ezfarm-farmcloud/cflora/hardware/ver.1/Circuit_PCB/CECS_Base_Board/PDF/CECS_base_PL.pdf

Item | Quantity | Reference | Part | Package
1 | 1 | BT1 | CR1220 | CR1220
2 3 4 5 6 7 | 3 2 4 4 1 28 | C3,C15,C16 C32,C41 C7,C26,C27,C37 C11,C34,C36,C42 C6 C1,C2,C4,C5,C8,C9,C10,C12,C13,C14,C17,C18,C19, C20,C21,C22,C23,C24,C25,C28,C29,C30,C31,C33,C35,C 38,C39,C40 | 18pF 100pF 330pF 470pF 1000pF 100nF | SMD2012
8 9 10 11 12 13 14 15 16 17 | 4 5 4 2 8 4 1 4 4 7 | D15,D18,D19,D22 D1,D2,D3,D4,D13 D16,D17,D21,D23 EC4,EC5 EC2,EC3,EC7,EC9,EC10,EC11,EC13,EC14 EC1,EC6,EC8,EC12 J8 L2,L4,L6,L8 L1,L3,L5,L7 Q1,Q2,Q3,Q4,Q5,Q6,Q7 | SS24 1N4148 ESD5B5.0ST1-D 10uF/16V 100uF/16V 220uF/35V FFC-0.5MM-40P 1uH 100uH MMBT2222LT1G | DO-214AA SOD-80 SOD-523 EC-D55 EC-F60 EC-J10 FFC-0.5MM-40P YCDM6045T VLP8040T SOT-23
18 19 20 21 22 23 24 25 26 27 28 | 3 21 1 12 6 10 1 1 17 1 1 | R47,R53,R78 R4,R6,R11,R12,R27,R34,R42,R43,R46,R48,R51,R52,R54, R55,R56,R57,R62,R63,R69,R72,R80 R32 R21,R22,R23,R24,R25,R26,R29,R40,R74,R75,R76,R81 R9,R10,R17,R18,R73,R79 R1,R2,R7,R8,R13,R14,R19,R20,R35,R70 R36 R37 R3,R5,R28,R30,R41,R44,R45,R49,R50,R58,R59,R60,R61, R64,R65,R66,R67 R38 R39 | 0R 120R 560R 1K3 2K2 4K7 6K8 8K2 10K 15K 33K | SMD2012
29 30 | 3 4 | R15,R16,R31 R33,R68,R71,R77 | 24R 0R1 | SMD3216 SMD6432
31 | 5 | SW1,SW2,SW3,SW4,SW6 | SW PB | ITS-1105-4.3-SMD
32 | 2 | U1,U5 | 74LVC14 | SO14
33 | 1 | U2 | PCF8563 | SO8
34 | 1 | U3 | MAX3485CSA | SO8
35 | 4 | U4,U9,U10,U11 | MC33063A | SO8
36 | 1 | U6 | STM32F103VET6 | TQFP100
37 | 1 | U7 | SN65HVD230/1D | SO8
38 | 1 | U8 | MAX3232CSE | SO16
39 | 1 | Y2 | Xtal-16MHz | XTAL3225-SMD
1 | 1 | CAN1 | RJ45-4C4P
2 | 10 | D5,D6,D7,D8,D9,D10,D11,D12D14,D20 | 3pi LED
3 | 1 | F1 | F-520
4 | 4 | J1,J2,J3,J4 | BR-350MLH-3P
5 | 2 | J5,J6 | HEADER 8X2 2.0mm
6 | 2 | J7,J10 | HEADER 24X2
7 | 2 | J9,J17 | 5267-4P
8 | 1 | J11 | Header 6X2 2.54mm
9 | 3 | J12,J20,J21 | 5267-2P
10 | 1 | J13 | HEADER 17X2
11 | 2 | J14,J15 | Header 2P 2.54mm
12 | 1 | J16 | 5267-3P
13 | 1 | J18 | IDC 5X2 2mm
14 | 1 | J19 | YW500-02V
15 | 2 | LS1,LS2 | DS1E-S-DC5V
16 | 1 | LS3 | Buzzer
17 | 1 | SW5 | SW DIP-4
18 | 5 | T1,T2,T3,T4,T5 | TP
19 | 1 | Y1 | 32768Hz
20 | 2 | RV1,RV2 | VARISTOR 18V
21 | 2 | ISO1,ISO2 | TLP281

dip.

*** CECS_Base_Board_PL

*** 이하 수삽부품
