ezfarm-farmcloud/cflora/hardware/ver.1/Circuit_PCB/CECS_MODULE_AtoD/pdf/cecs_module_atod_PL.pdf

Item | Quantity | Reference | Part | Package
1 2 3 4 5 6 7 8 | 2 1 2 2 1 8 49 8 | C41,C43 C58 C59,C65 C64,C73 C72 C4,C8,C12,C19,C24,C29,C34,C39 C2,C3,C5,C7,C9,C10,C13,C14,C15,C17,C18,C20,C22, C1,C6,C11,C16,C21,C26,C31,C36 | 18pF 100pF 330pF 470pF 1500pF 68nF 100nF 150nF | SMD2012
9 10 11 12 13 14 15 16 17 18 | 2 9 16 8 1 2 13 8 16 32 | R75,R89 R82,R84,R85,R86,R87,R92,R94,R100,R106 R3,R7,R12,R15,R21,R25,R30,R34,R39,R43,R48,R52,R57, R95,R96,R97,R98,R102,R104,R108,R110 R107 R101,R109 R73,R74,R76,R77,R78,R79,R80,R81,R83,R88,R90,R91, R4,R16,R24,R33,R42,R51,R59,R69 R2,R9,R11,R18,R20,R27,R29,R36,R38,R45,R47,R54,R56, R1,R5,R6,R8,R10,R13,R14,R17,R19,R22,R23,R26,R28, | 0R 120R 249R 1K3 2K2 5K6 10K 13K 49K9 100K | SMD2012
19 20 | 2 1 | R99,R105 R103 | 0R1 0R2 | SMD6432
21 22 23 24 25 26 27 28 29 30 31 32 33 34 35 36 37 38 39 | 2 3 6 3 3 3 3 19 8 1 1 1 3 1 8 1 1 1 1 | EC1,EC2 EC3,EC4,EC5 EC7,EC8,EC10,EC12,EC13,EC14 EC6,EC9,EC11 L1,L4,L6 L2,L3,L5 D28,D33,D34 D1,D2,D4,D5,D7,D8,D10,D11,D13,D14,D16,D18,D19, D3,D6,D9,D12,D15,D17,D20,D23 U15 U10 U12 U14,U16,U17 U13 U1,U2,U3,U4,U5,U6,U7,U8 U11 U9 Y1 SW2 | 1uF/35V 10uF/16V 100uF/16V 220uF/35V 100uH 1uH SS24 ESD5B5.0ST1-D BTA54SL LM1117S-5.0 SN65HVD230/1D ADR381 MC33063A 74LVC14 TL074C MAX3232CSE STM32F103VET6 Xtal-16MHz SW PUSHBUTTON | EC-D55 EC-D55 EC-F60 EC-J10 VLP8040T YCDM6045T DO-214AA SOD-523 SOT-23 SOT-223 SO8 SO8 SO8 SO14 SO14 SO16 TQFP100 XTAL3225-SMD ITS-1105-4.3-SMD
1 | 2 | CAN1,CAN2 | RJ45-4P4C
2 | 5 | D29,D30,D31,D32,D35 | 3pi LED
3 | 1 | F1 | F-520
4 | 8 | J1,J3,J5,J7,J9,J11,J13,J15 | BR-350MLH-3P
5 | 8 | J2,J4,J6,J8,J10,J12,J14,J16 | Header 3X2 2.54mm
6 | 1 | J17 | JMP
7 | 1 | J18 | IDC 5X2 2mm
8 | 2 | J19,J20 | 5267-3P
9 | 1 | J21 | HEADER 8X2 2.0mm
10 | 1 | J22 | YW500-02V
11 | 1 | J23 | HEADER 8X2 2mm
12 | 1 | RV1 | VARISTOR 18V
13 | 1 | SW1 | SW DIP-4
14 | 21 | T1,T2,T3,T4,T5,T6,T7,T8,T9,T10,T11,T12,T13,T14,T15, | TP

dip.

*** 이하 수삽부품

*** CECS_AtoD_Module_PL
