ezfarm-farmcloud/cflora/hardware/ver.1/Circuit_PCB/CECS_atod_base_PL.xlsx

Sheet: CECS_AtoD_Module
*** CECS_AtoD_Module_PL
Item | Quantity | Reference | Part | Package
1 | 2 | C41,C43 | 18pF | SMD2012
2 | 1 | C58 | 100pF
3 | 2 | C59,C65 | 330pF
4 | 2 | C64,C73 | 470pF
5 | 1 | C72 … 부품없음, 실장하지 않음 | 1500pF
6 | 8 | C4,C8,C12,C19,C24,C29,C34,C39 | 68nF
7 | 49 | C2,C3,C5,C7,C9,C10,C13,C14,C15,C17,C18,C20,C22, C23,C25,C27,C28,C30,C32,C33,C35,C37,C38,C40,C42,C44,C45,C46,C47,C48,C49,C50,C51,C52,C53,C54,C55,C56,C57,C60,C61,C62,C63,C66,C67,C68,C69,C70,C71 | 100nF
8 | 8 | C1,C6,C11,C16,C21,C26,C31,C36 | 150nF
9 | 2 | R75,R89 | 0R | SMD2012
10 | 9 | R82,R84,R85,R86,R87,R92,R94,R100,R106 | 120R
11 | 16 | R3,R7,R12,R15,R21,R25,R30,R34,R39,R43,R48,R52,R57,R60,R66,R70 | 249R
12 | 8 | R95,R96,R97,R98,R102,R104,R108,R110 | 1K3
13 | 1 | R107 | 2K2
14 | 2 | R101,R109 | 5K6 >> 6K2로 변경
15 | 13 | R73,R74,R76,R77,R78,R79,R80,R81,R83,R88,R90,R91, R93 | 10K
16 | 8 | R4,R16,R24,R33,R42,R51,R59,R69 | 13K
17 | 16 | R2,R9,R11,R18,R20,R27,R29,R36,R38,R45,R47,R54,R56,R63,R65,R72 | 49K9
18 | 32 | R1,R5,R6,R8,R10,R13,R14,R17,R19,R22,R23,R26,R28, R31,R32,R35,R37,R40,R41,R44,R46,R49,R50,R53,R55, R58,R61,R62,R64,R67,R68,R71 | 100K
19 | 2 | R99,R105 | 0R1 | SMD6432
20 | 1 | R103 | 0R2
21 | 2 | EC1,EC2 | 1uF/50V로 변경 | EC-D55
22 | 3 | EC3,EC4,EC5 | 10uF/16V | EC-D55
23 | 6 | EC7,EC8,EC10,EC12,EC13,EC14 | 100uF/16V | EC-F60
24 | 3 | EC6,EC9,EC11 | 220uF/35V | EC-J10
25 | 3 | L1,L4,L6 | 100uH | VLP8040T
26 | 3 | L2,L3,L5 | 1uH | YCDM6045T
27 | 3 | D28,D33,D34 | SS24 | DO-214AA
28 | 19 | D1,D2,D4,D5,D7,D8,D10,D11,D13,D14,D16,D18,D19, D21,D22,D24,D25,D26,D27 | ESD5B5.0ST1-D | SOD-523
29 | 8 | D3,D6,D9,D12,D15,D17,D20,D23 | BTA54SL | SOT-23
30 | 1 | U15 | LM1117S-5.0 | SOT-223
31 | 1 | U10 | SN65HVD230/1D | SO8
32 | 1 | U12 | ADR381 | SO8
33 | 3 | U14,U16,U17 … 부품 부족 3세트실장 | MC33063A | SO8
34 | 1 | U13 | 74LVC14 | SO14
35 | 8 | U1,U2,U3,U4,U5,U6,U7,U8 TL074, TL084 부품 2종 준비 5세트씩 실장한다, | TL074C | SO14
36 | 1 | U11 | MAX3232CSE | SO16
37 | 1 | U9 | STM32F103VET6 | TQFP100
38 | 1 | Y1 | Xtal-16MHz | XTAL3225-SMD
39 | 1 | SW2 | SW PUSHBUTTON | ITS-1105-4.3-SMD
*** 이하 수삽부품
1 | 2 | CAN1,CAN2 | RJ45-4P4C | dip.
2 | 5 | D29,D30,D31,D32,D35 | 3pi LED
3 | 1 | F1 | F-520
4 | 8 | J1,J3,J5,J7,J9,J11,J13,J15 | BR-350MLH-3P
5 | 8 | J2,J4,J6,J8,J10,J12,J14,J16 | Header 3X2 2.54mm
6 | 1 | J17 | JMP
7 | 1 | J18 | IDC 5X2 2mm
8 | 2 | J19,J20 | 5267-3P
9 | 1 | J21 | HEADER 8X2 2.0mm
10 | 1 | J22 | YW500-02V
11 | 1 | J23 | HEADER 8X2 2mm
12 | 1 | RV1 | VARISTOR 18V
13 | 1 | SW1 | SW DIP-4
14 | 21 | T1,T2,T3,T4,T5,T6,T7,T8,T9,T10,T11,T12,T13,T14,T15, T16,T17,T18,T19,T20,T21 | TP

Sheet: CECS_Base_Board
*** CECS_Base_Board_PL
Item | Quantity | Reference | Part | Package
1 | 1 | BT1 | CR1220 | CR1220
2 | 3 | C3,C15,C16 | 18pF | SMD2012
3 | 2 | C32,C41 | 100pF
4 | 4 | C7,C26,C27,C37 | 330pF
5 | 4 | C11,C34,C36,C42 | 470pF
6 | 1 | C6 | 1000pF
7 | 28 | C1,C2,C4,C5,C8,C9,C10,C12,C13,C14,C17,C18,C19, C20,C21,C22,C23,C24,C25,C28,C29,C30,C31,C33,C35,C38,C39,C40 | 100nF
8 | 4 | D15,D18,D19,D22 | SS24 | DO-214AA
9 | 5 | D1,D2,D3,D4,D13 | 1N4148 | SOD-80
10 | 4 | D16,D17,D21,D23 | ESD5B5.0ST1-D | SOD-523
11 | 2 | EC4,EC5 | 10uF/16V | EC-D55
12 | 8 | EC2,EC3,EC7,EC9,EC10,EC11,EC13,EC14 | 100uF/16V | EC-F60
13 | 4 | EC1,EC6,EC8,EC12 | 220uF/35V | EC-J10
14 | 1 | J8 | FFC-0.5MM-40P | FFC-0.5MM-40P
15 | 4 | L2,L4,L6,L8 | 1uH | YCDM6045T
16 | 4 | L1,L3,L5,L7 | 100uH | VLP8040T
17 | 7 | Q1,Q2,Q3,Q4,Q5,Q6,Q7 | MMBT2222LT1G | SOT-23
18 | 3 | R47,R53,R78 | 0R | SMD2012
19 | 21 | R4,R6,R11,R12,R27,R34,R42,R43,R46,R48,R51,R52,R54,R55,R56,R57,R62,R63,R69,R72,R80 | 120R
20 | 1 | R32 | 560R
21 | 12 | R21,R22,R23,R24,R25,R26,R29,R40,R74,R75,R76,R81 | 1K3
22 | 6 | R9,R10,R17,R18,R73,R79 | 2K2
23 | 10 | R1,R2,R7,R8,R13,R14,R19,R20,R35,R70 | 4K7
24 | 1 | R36 | 6K8
25 | 1 | R37 | 8K2
26 | 17 | R3,R5,R28,R30,R41,R44,R45,R49,R50,R58,R59,R60,R61,R64,R65,R66,R67 | 10K
27 | 1 | R38 | 15K
28 | 1 | R39 | 33K
29 | 3 | R15,R16,R31 | 24R | SMD3216
30 | 4 | R33,R68,R71,R77 | 0R1 | SMD6432
31 | 5 | SW1,SW2,SW3,SW4,SW6 | SW PB | ITS-1105-4.3-SMD
32 | 2 | U1,U5 | 74LVC14 | SO14
33 | 1 | U2 … 부품부족, 5세트 실장 | PCF8563 | SO8
34 | 1 | U3 … 부품 없음, 실장하지 않음 | MAX3485CSA | SO8
35 | 4 | U4,U9,U10,U11 … … 부품 부족 1세트실장 | MC33063A | SO8
36 | 1 | U6 | STM32F103VET6 | TQFP100
37 | 1 | U7 | SN65HVD230/1D | SO8
38 | 1 | U8 | MAX3232CSE | SO16
39 | 1 | Y2 | Xtal-16MHz | XTAL3225-SMD
*** 이하 수삽부품
1 | 1 | CAN1 | RJ45-4C4P | dip.
2 | 10 | D5,D6,D7,D8,D9,D10,D11,D12D14,D20 | 3pi LED
3 | 1 | F1 | F-520
4 | 4 | J1,J2,J3,J4 | BR-350MLH-3P
5 | 2 | J5,J6 | HEADER 8X2 2.0mm
6 | 2 | J7,J10 | HEADER 24X2
7 | 2 | J9,J17 | 5267-4P
8 | 1 | J11 | Header 6X2 2.54mm
9 | 3 | J12,J20,J21 | 5267-2P
10 | 1 | J13 | HEADER 17X2
11 | 2 | J14,J15 | Header 2P 2.54mm
12 | 1 | J16 | 5267-3P
13 | 1 | J18 | IDC 5X2 2mm
14 | 1 | J19 | YW500-02V
15 | 2 | LS1,LS2 | DS1E-S-DC5V
16 | 1 | LS3 | Buzzer
17 | 1 | SW5 | SW DIP-4
18 | 5 | T1,T2,T3,T4,T5 | TP
19 | 1 | Y1 | 32768Hz
20 | 2 | RV1,RV2 | VARISTOR 18V
21 | 2 | ISO1,ISO2 | TLP281
