ezfarm-farmcloud/cflora/hardware/ver.2/Circuit_PCB/CFLORA_BASE2016/pdf/base.pdf

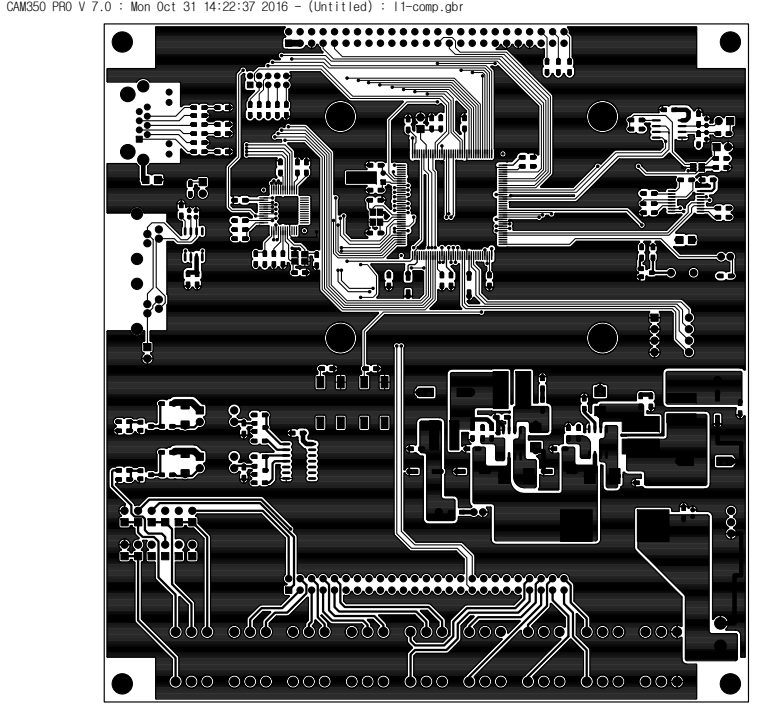
[picture p28: page 1]

CAM350 PRO V 7.0 : Mon Oct 31 14:22:37 2016 - (Untitled) : l1-comp.gbr

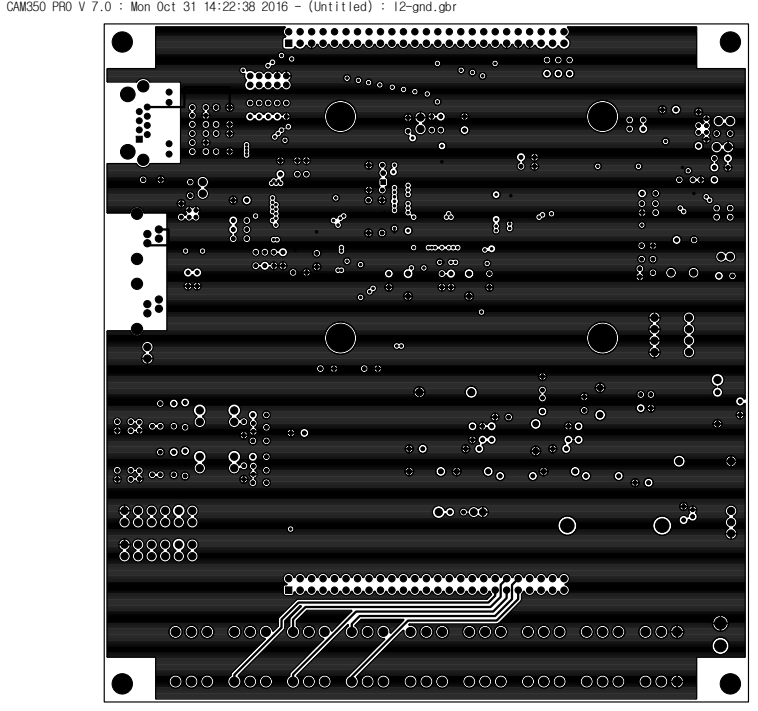
[picture p29: page 2]

CAM350 PRO V 7.0 : Mon Oct 31 14:22:38 2016 - (Untitled) : l2-gnd.gbr

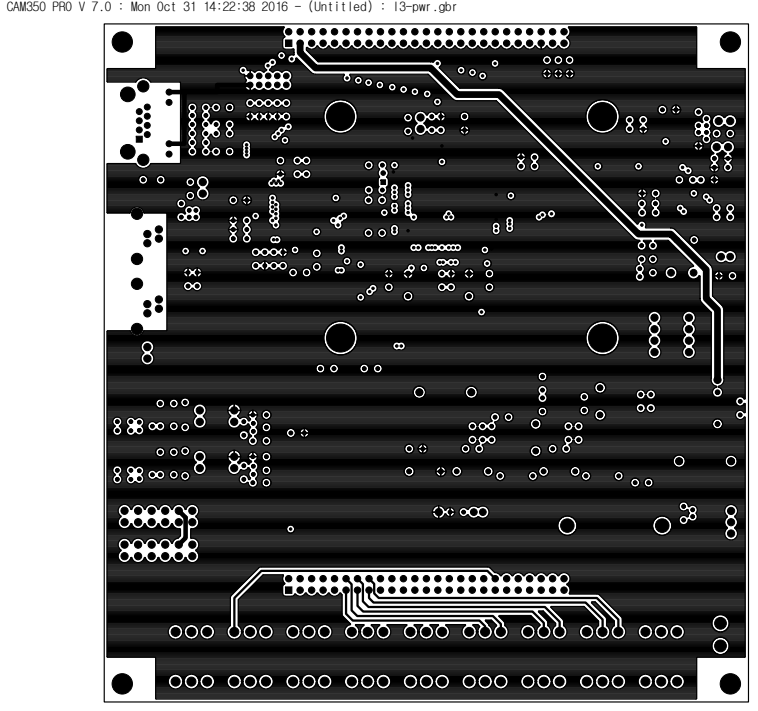
[picture p30: page 3]

CAM350 PRO V 7.0 : Mon Oct 31 14:22:38 2016 - (Untitled) : l3-pwr.gbr

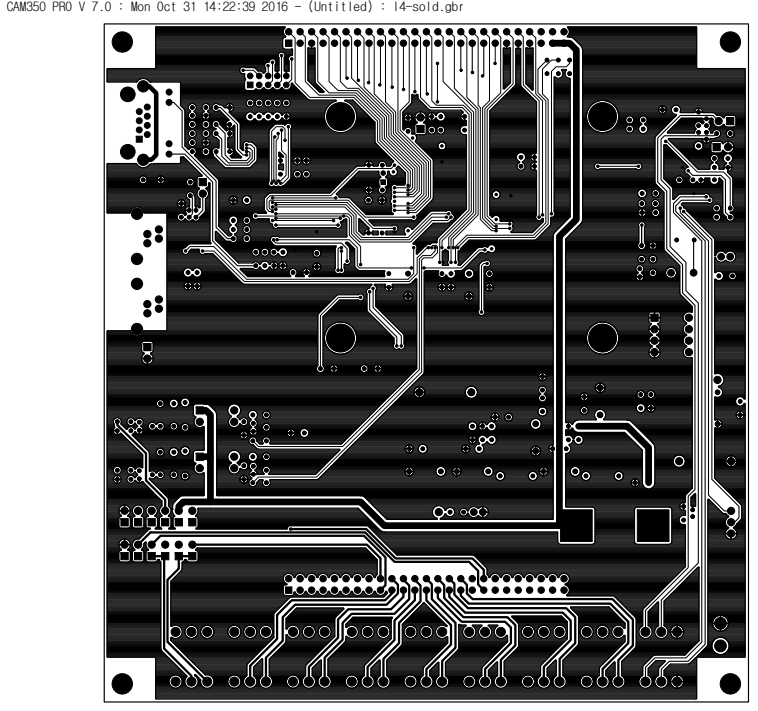
[picture p31: page 4]

CAM350 PRO V 7.0 : Mon Oct 31 14:22:39 2016 - (Untitled) : l4-sold.gbr

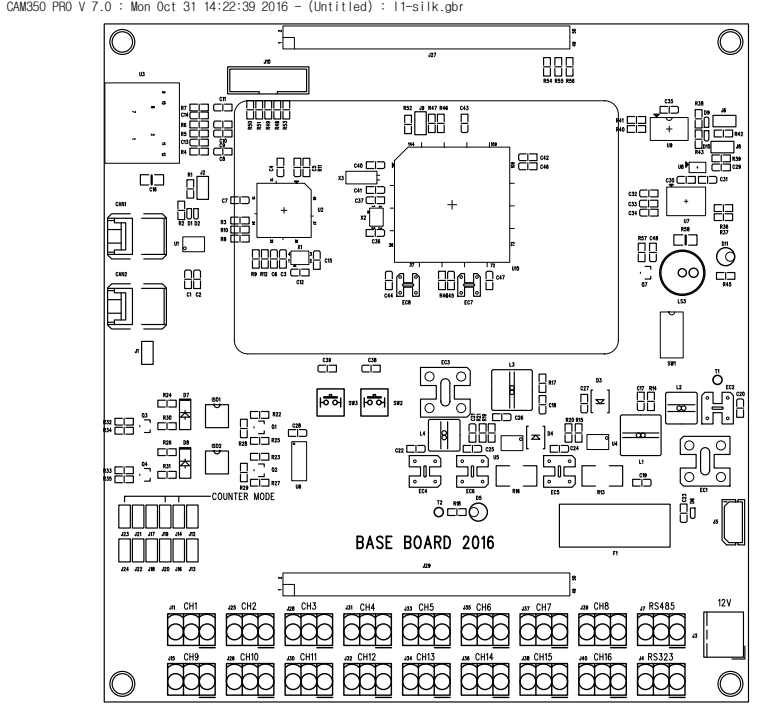
[picture p32: page 5]

CAM350 PRO V 7.0 : Mon Oct 31 14:22:39 2016 - (Untitled) : l1-silk.gbr

CAM350 PRO V 7.0 : Mon Oct 31 14:22:39 2016 - (Untitled) : l4-silk.gbr

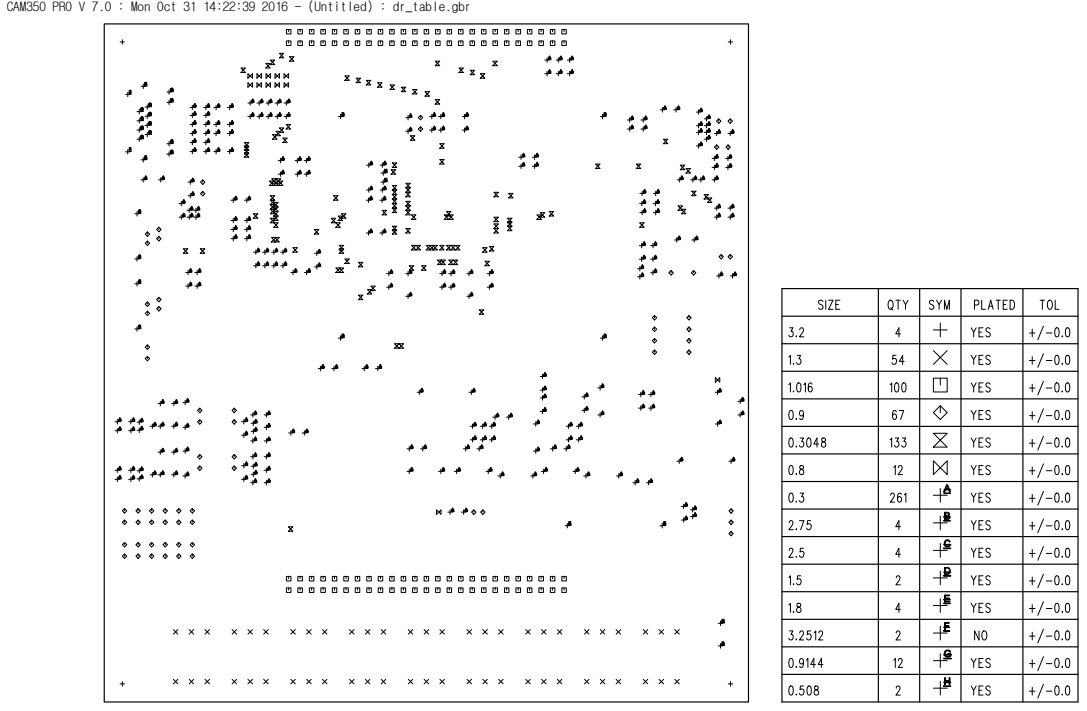
[picture p33: page 7]

CAM350 PRO V 7.0 : Mon Oct 31 14:22:39 2016 - (Untitled) : dr_table.gbr

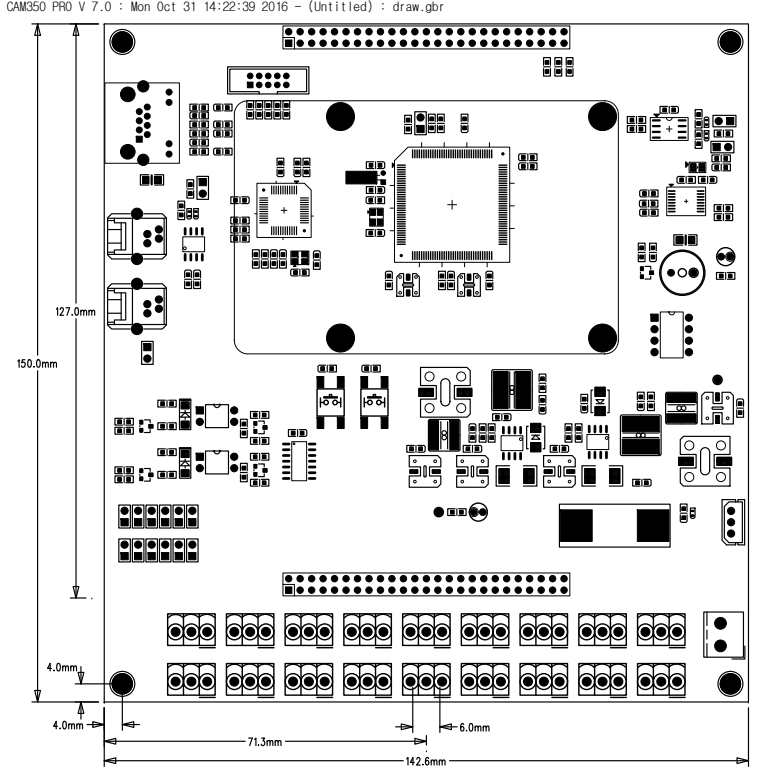
[picture p34: page 8]

CAM350 PRO V 7.0 : Mon Oct 31 14:22:39 2016 - (Untitled) : draw.gbr

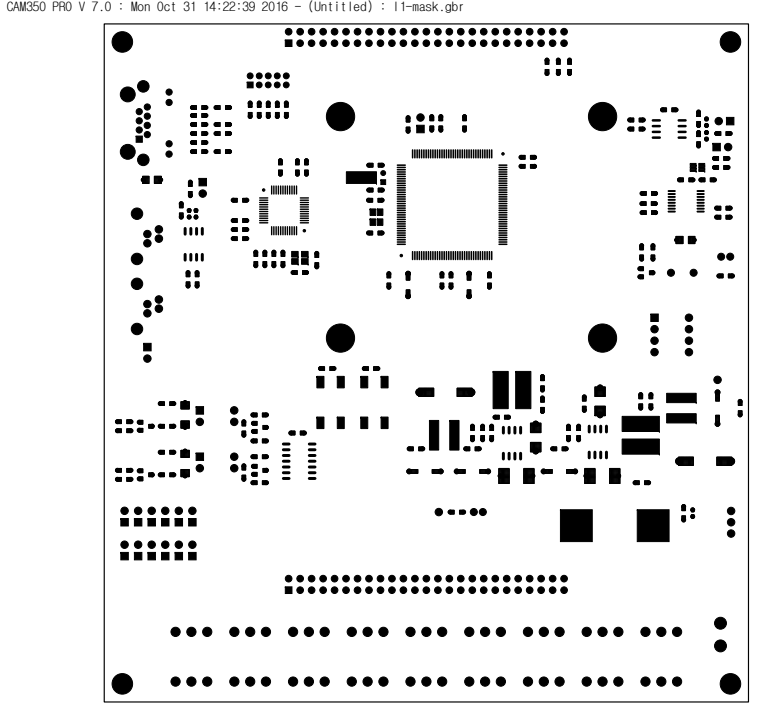
[picture p35: page 9]

CAM350 PRO V 7.0 : Mon Oct 31 14:22:39 2016 - (Untitled) : l1-mask.gbr

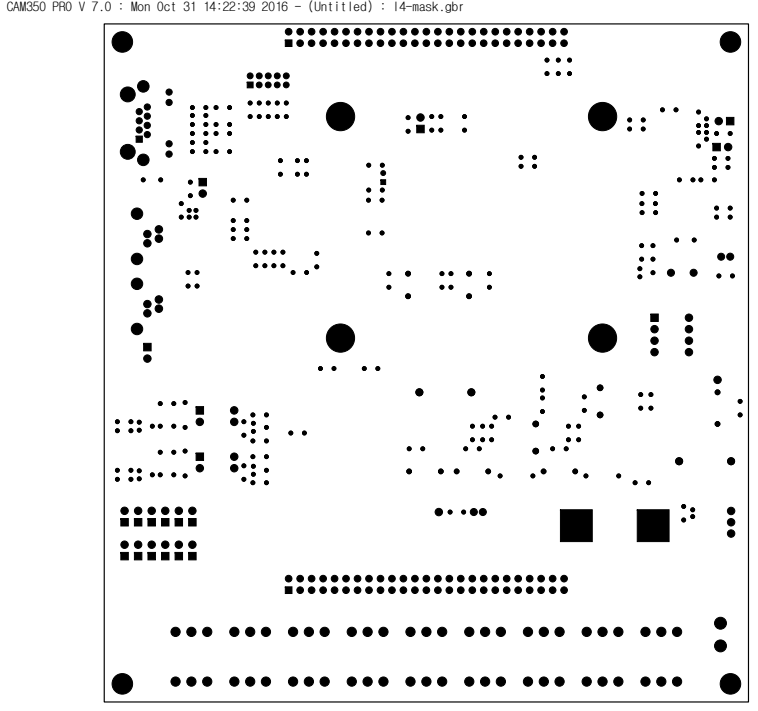
[picture p36: page 10]

CAM350 PRO V 7.0 : Mon Oct 31 14:22:39 2016 - (Untitled) : l4-mask.gbr

CAM350 PRO V 7.0 : Mon Oct 31 14:22:39 2016 - (Untitled) : l1-paste.gbr

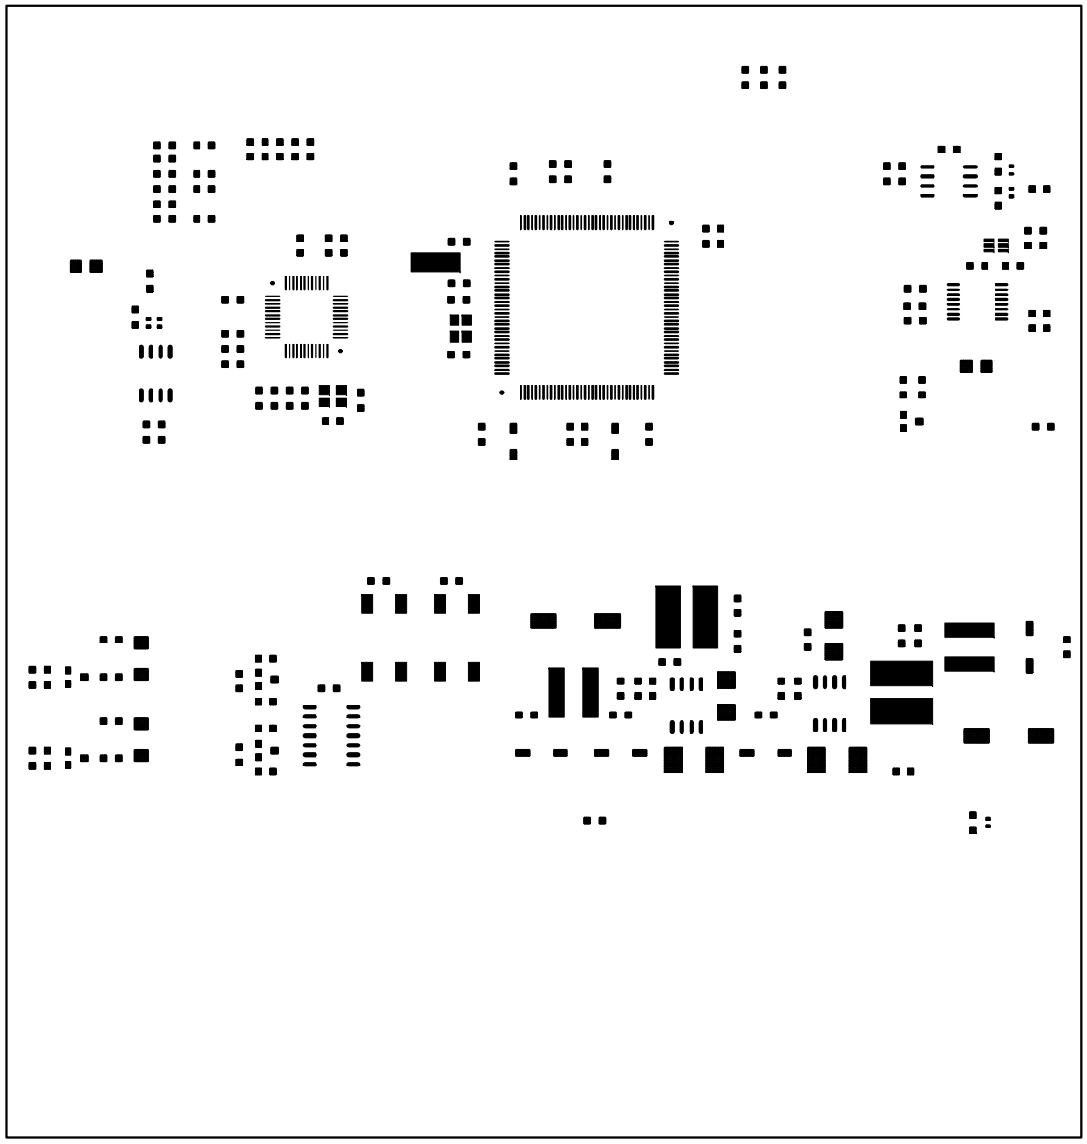
[picture p37: figure]

CAM350 PRO V 7.0 : Mon Oct 31 14:22:39 2016 - (Untitled) : l4-paste.gbr
