ezfarm-farmcloud/cflora/hardware/ver.2/Circuit_PCB/MODULE_AtoD2016/pdf/atod.pdf

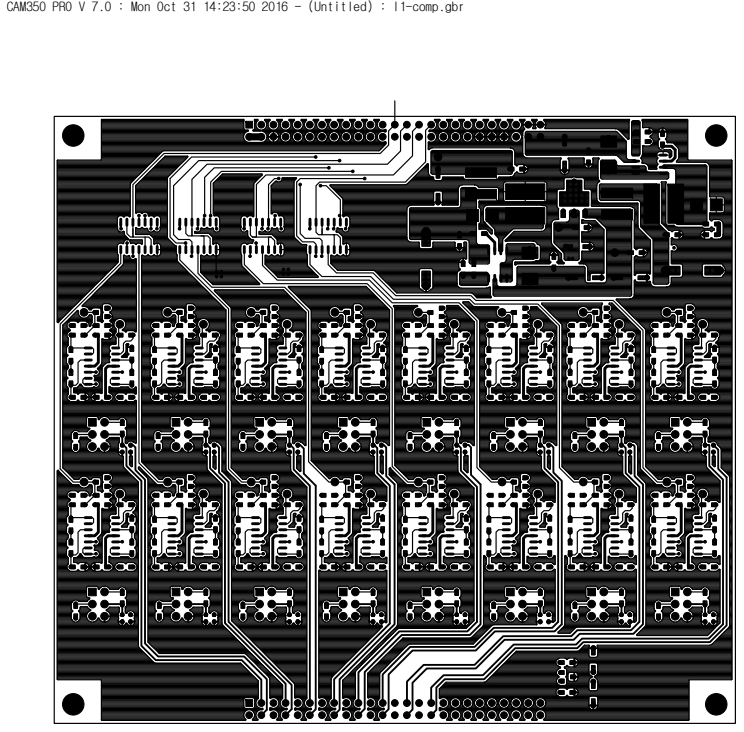
[picture p38: page 1]

CAM350 PRO V 7.0 : Mon Oct 31 14:23:50 2016 - (Untitled) : l1-comp.gbr

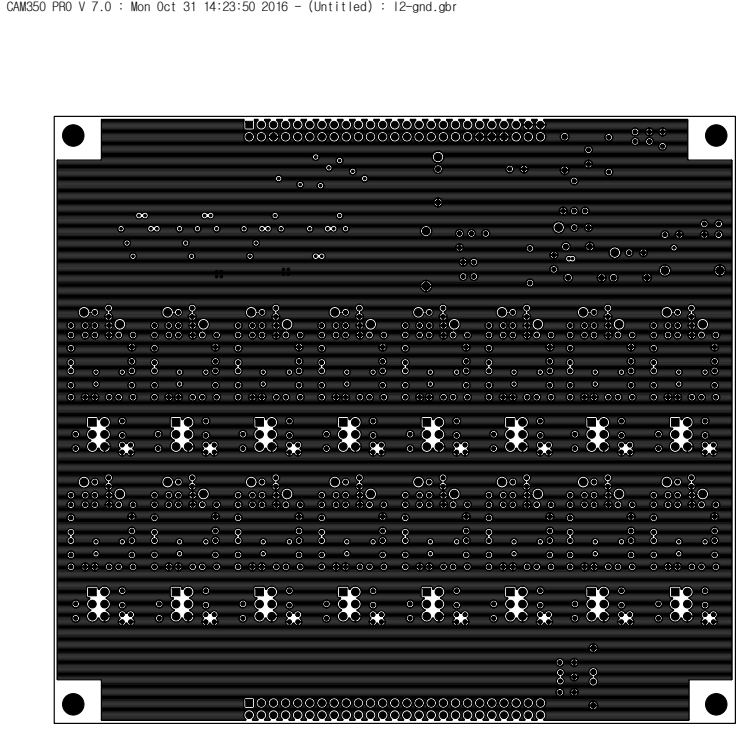
[picture p39: page 2]

CAM350 PRO V 7.0 : Mon Oct 31 14:23:50 2016 - (Untitled) : l2-gnd.gbr

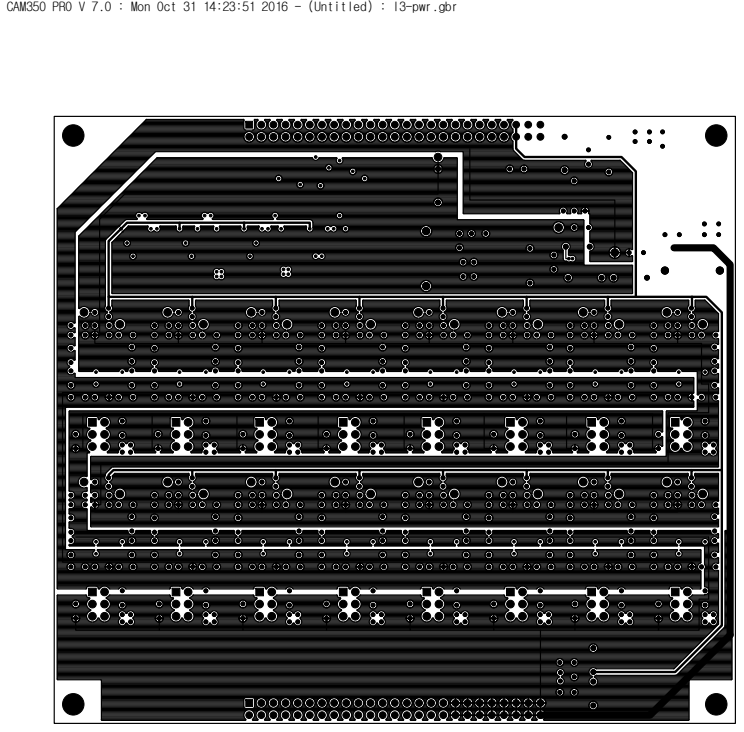
[picture p40: page 3]

CAM350 PRO V 7.0 : Mon Oct 31 14:23:51 2016 - (Untitled) : l3-pwr.gbr

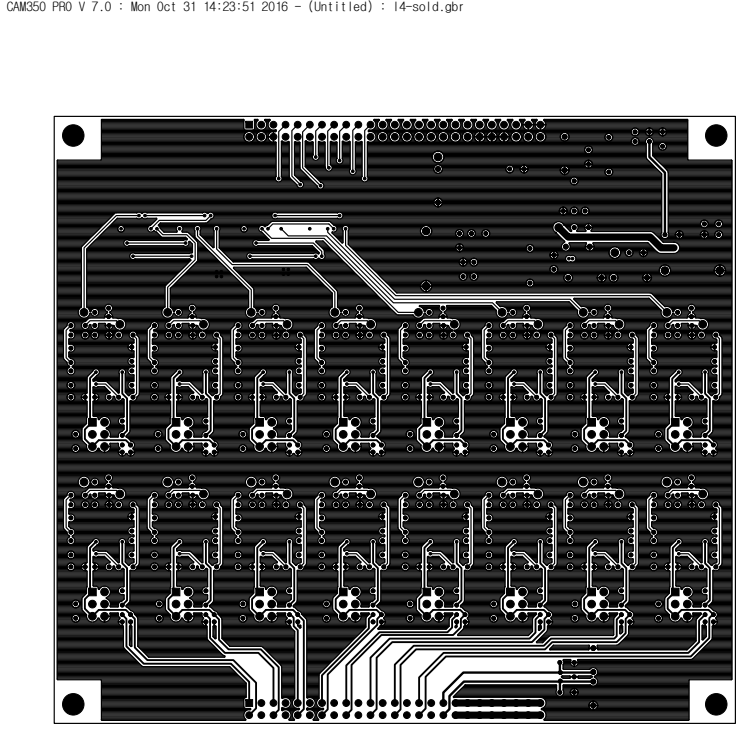
[picture p41: page 4]

CAM350 PRO V 7.0 : Mon Oct 31 14:23:51 2016 - (Untitled) : l4-sold.gbr

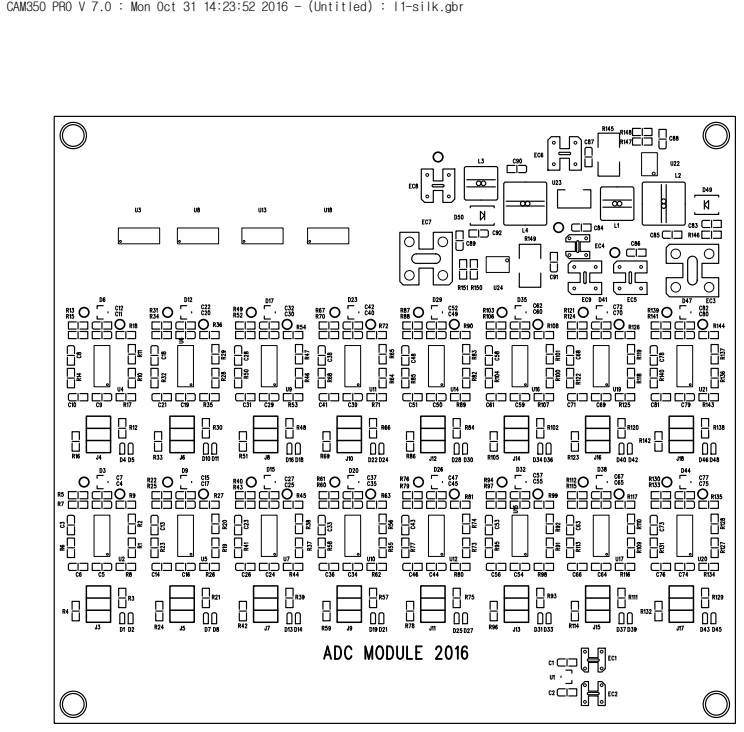
[picture p42: page 5]

CAM350 PRO V 7.0 : Mon Oct 31 14:23:52 2016 - (Untitled) : l1-silk.gbr

CAM350 PRO V 7.0 : Mon Oct 31 14:23:52 2016 - (Untitled) : l4-silk.gbr

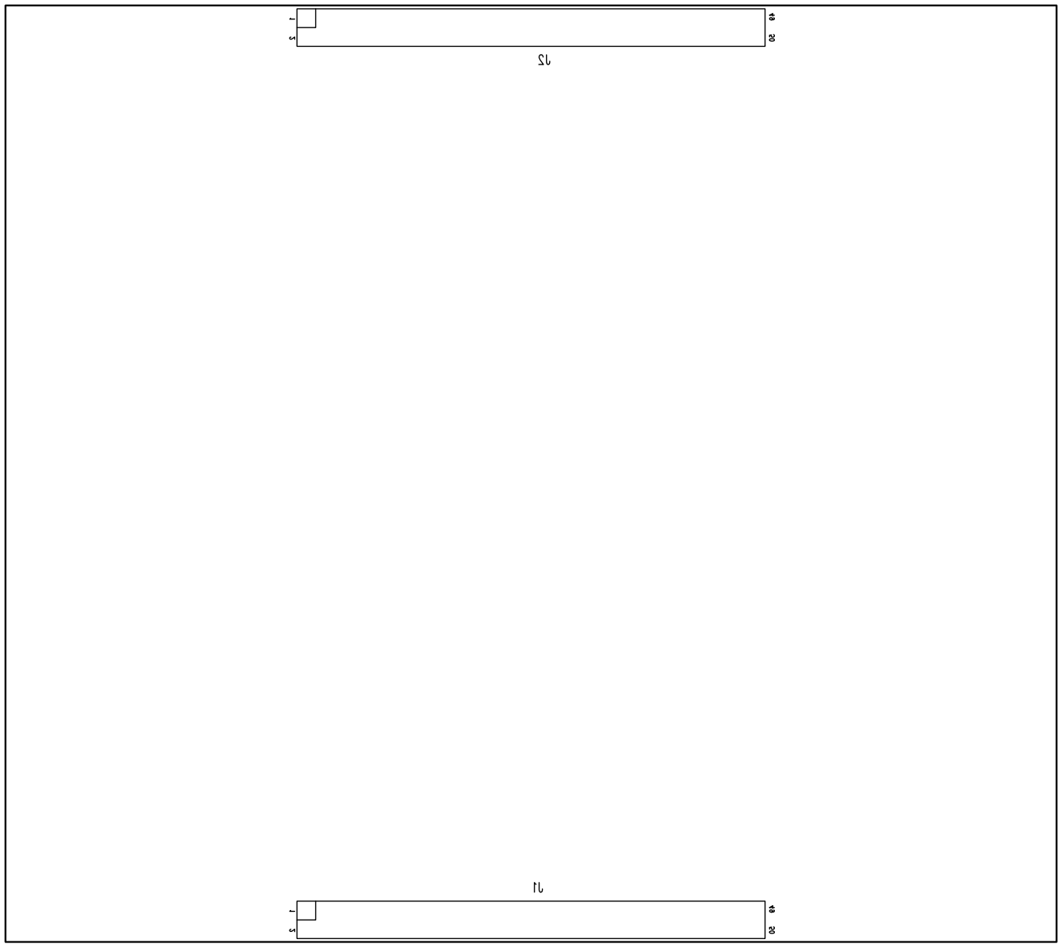
[picture p43: figure]
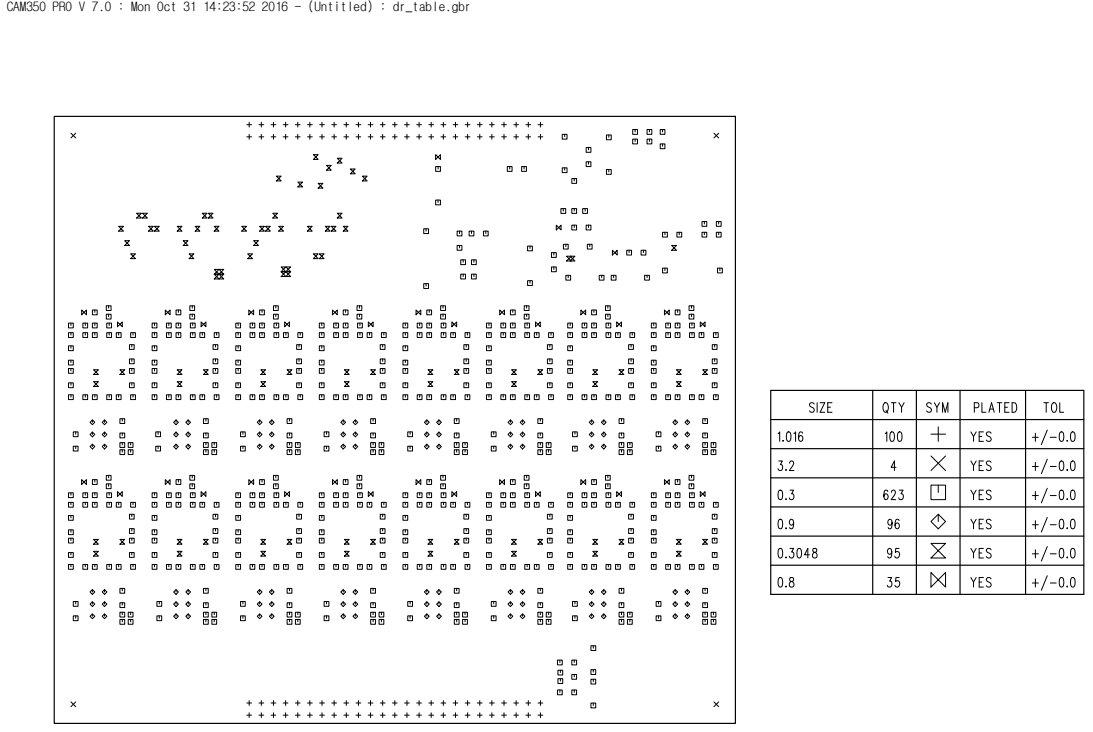
[picture p44: page 7]

CAM350 PRO V 7.0 : Mon Oct 31 14:23:52 2016 - (Untitled) : dr_table.gbr

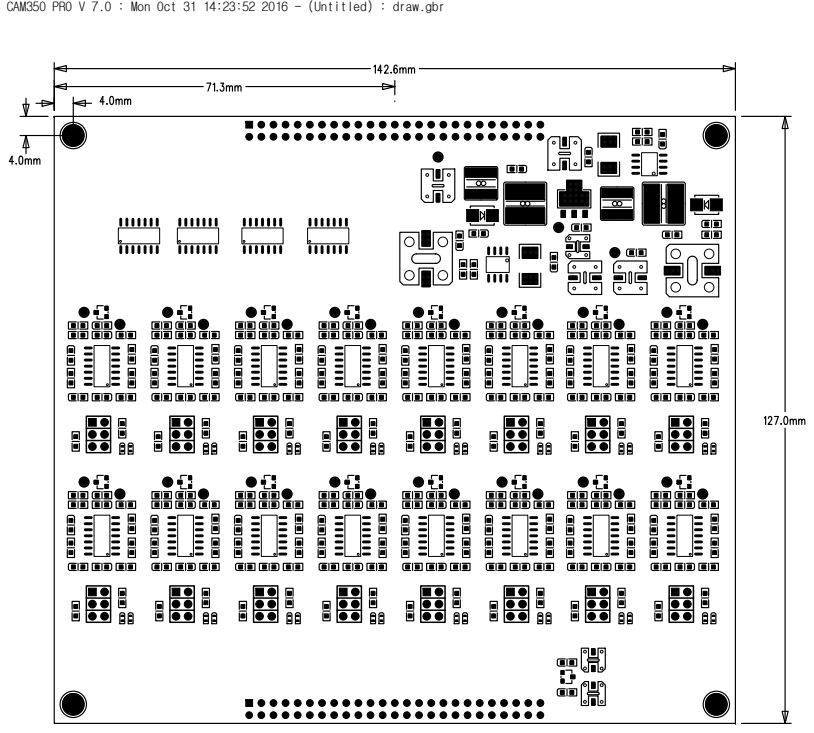
[picture p45: page 8]

CAM350 PRO V 7.0 : Mon Oct 31 14:23:52 2016 - (Untitled) : draw.gbr

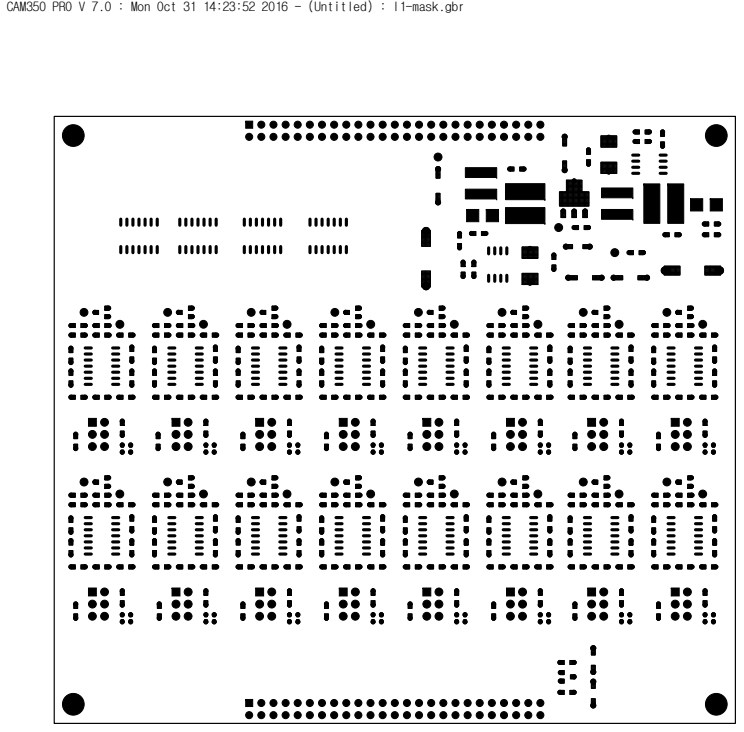
[picture p46: page 9]

CAM350 PRO V 7.0 : Mon Oct 31 14:23:52 2016 - (Untitled) : l1-mask.gbr

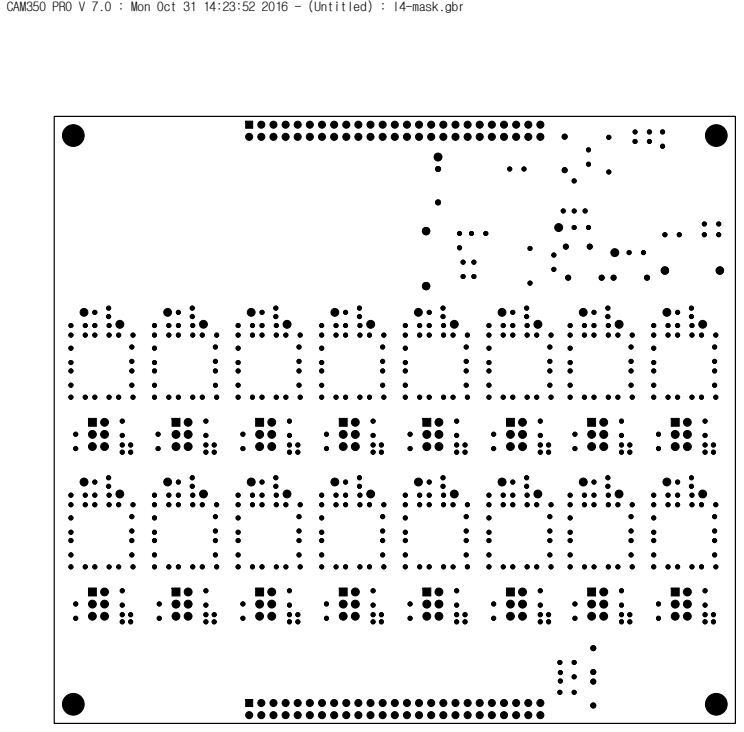
[picture p47: page 10]

CAM350 PRO V 7.0 : Mon Oct 31 14:23:52 2016 - (Untitled) : l4-mask.gbr

CAM350 PRO V 7.0 : Mon Oct 31 14:23:52 2016 - (Untitled) : l1-paste.gbr

CAM350 PRO V 7.0 : Mon Oct 31 14:23:53 2016 - (Untitled) : l4-paste.gbr
