ezfarm-farmcloud/cflora/hardware/ver.2/Circuit_PCB/MODULE_IsoInput2016/pdf/iso.pdf

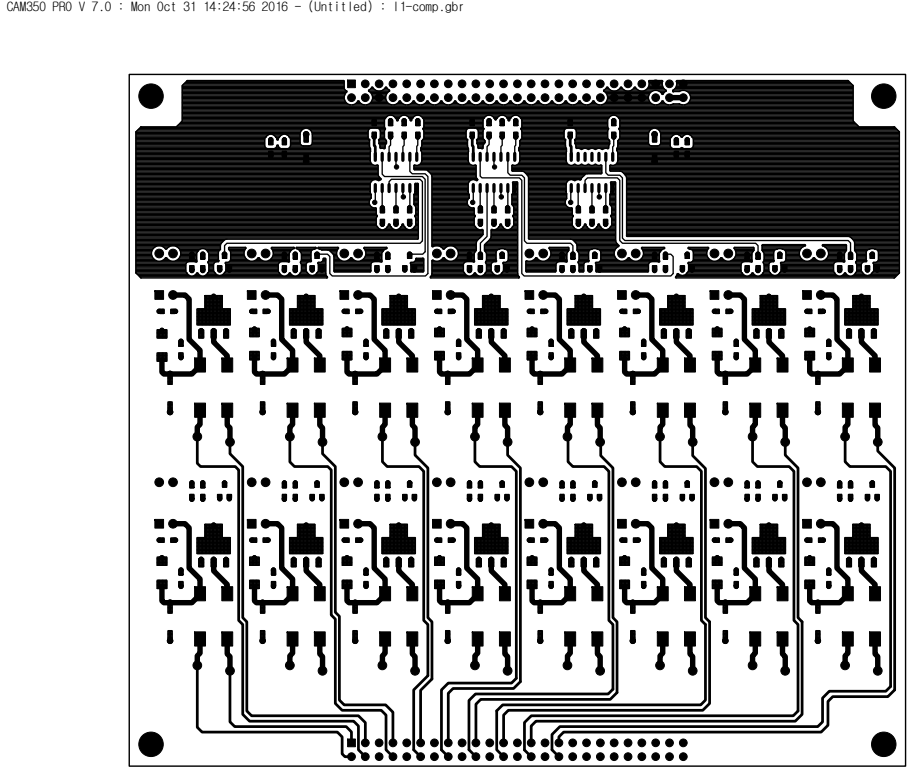
[picture p48: page 1]

CAM350 PRO V 7.0 : Mon Oct 31 14:24:56 2016 - (Untitled) : l1-comp.gbr

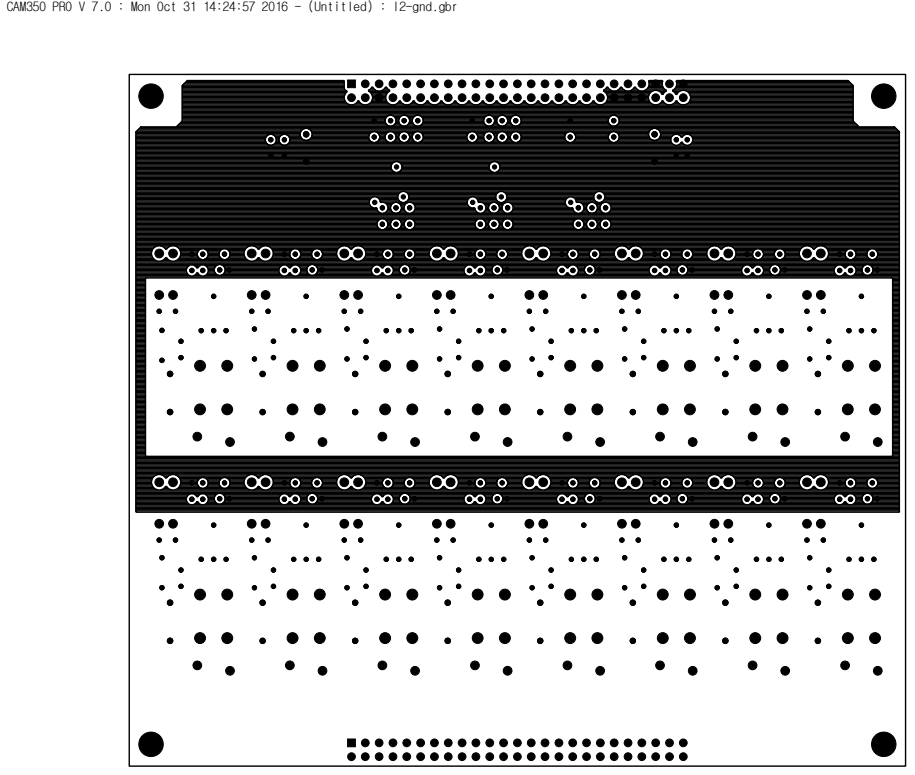
[picture p49: page 2]

CAM350 PRO V 7.0 : Mon Oct 31 14:24:57 2016 - (Untitled) : l2-gnd.gbr

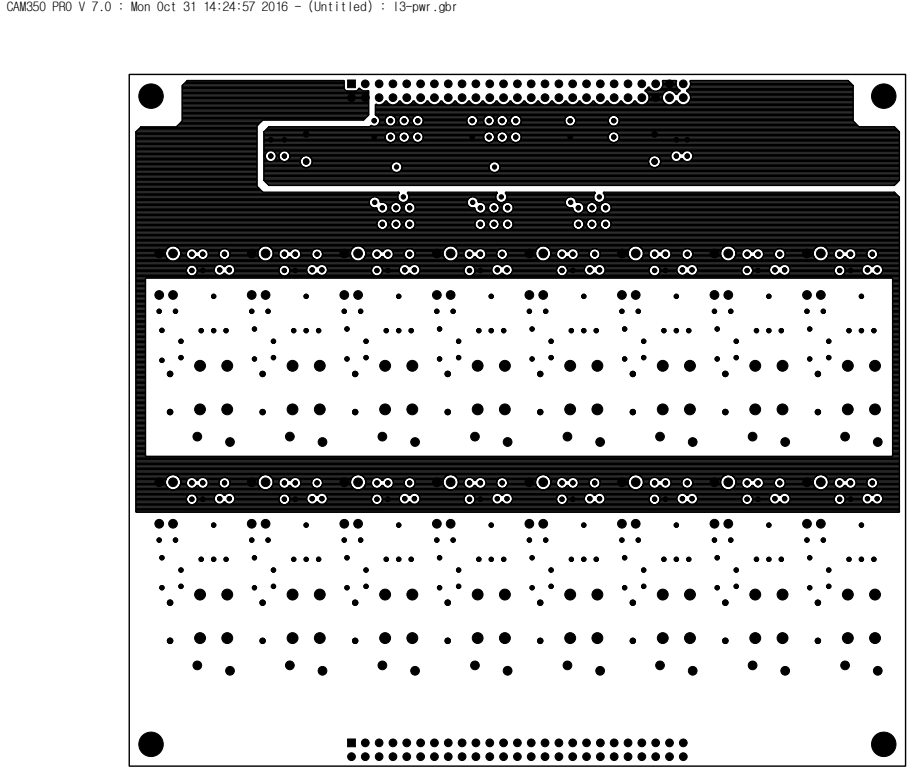
[picture p50: page 3]

CAM350 PRO V 7.0 : Mon Oct 31 14:24:57 2016 - (Untitled) : l3-pwr.gbr

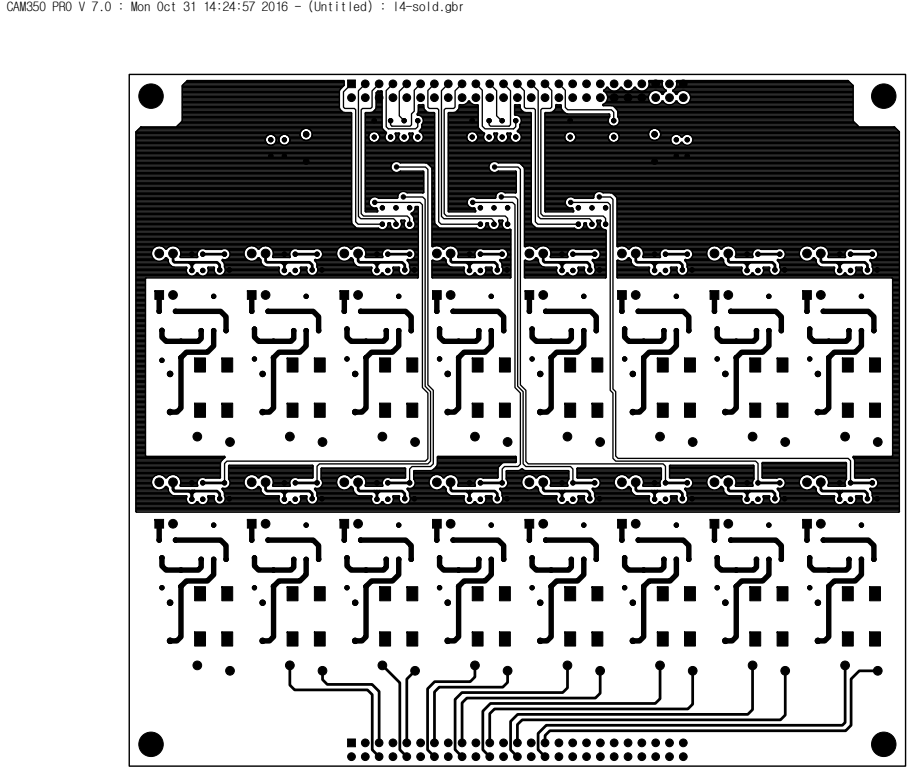
[picture p51: page 4]

CAM350 PRO V 7.0 : Mon Oct 31 14:24:57 2016 - (Untitled) : l4-sold.gbr

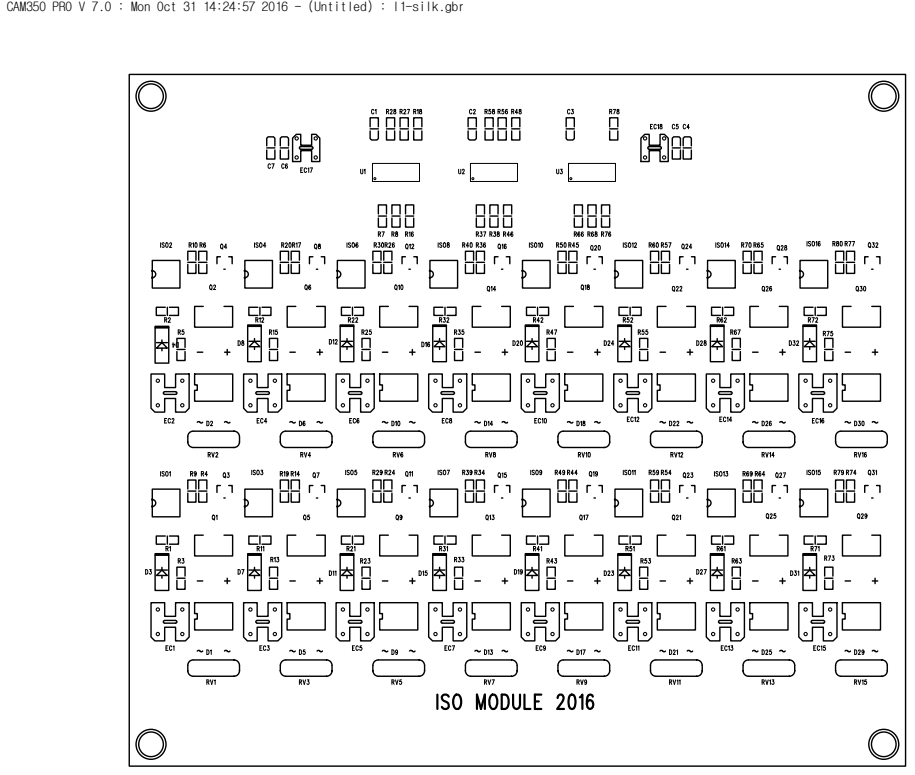
[picture p52: page 5]

CAM350 PRO V 7.0 : Mon Oct 31 14:24:57 2016 - (Untitled) : l1-silk.gbr

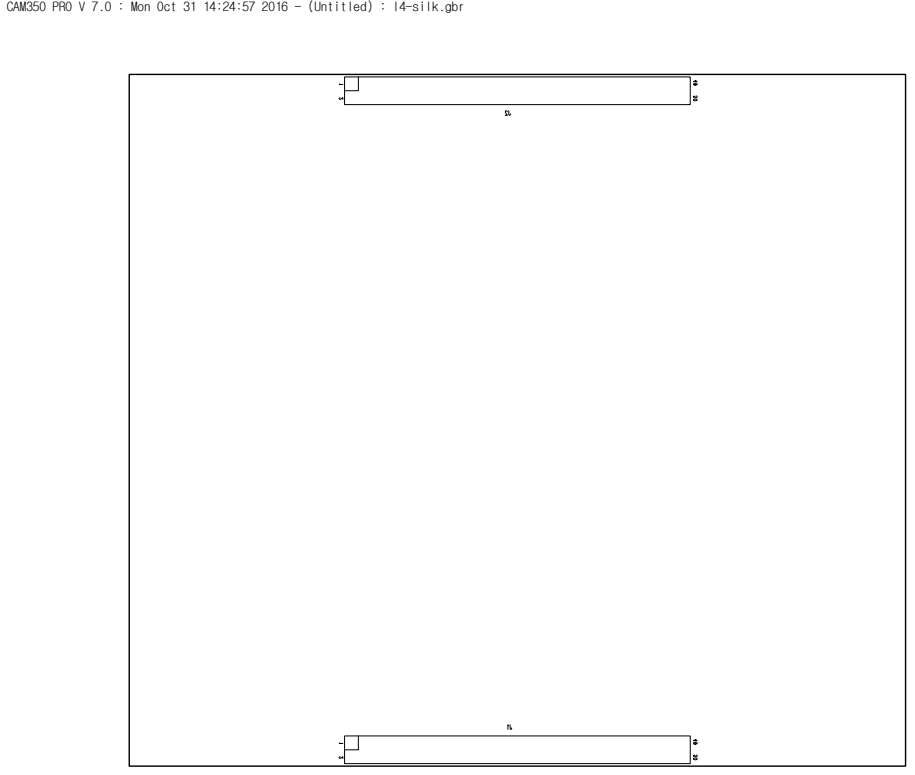
[picture p53: page 6]

CAM350 PRO V 7.0 : Mon Oct 31 14:24:57 2016 - (Untitled) : l4-silk.gbr

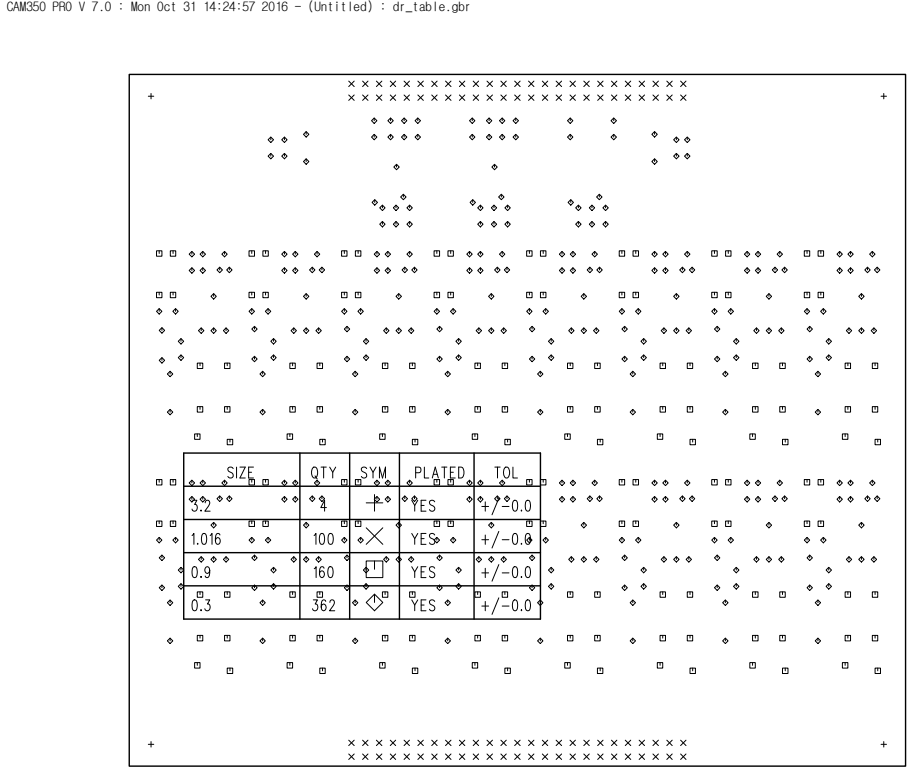
[picture p54: page 7]

CAM350 PRO V 7.0 : Mon Oct 31 14:24:57 2016 - (Untitled) : dr_table.gbr

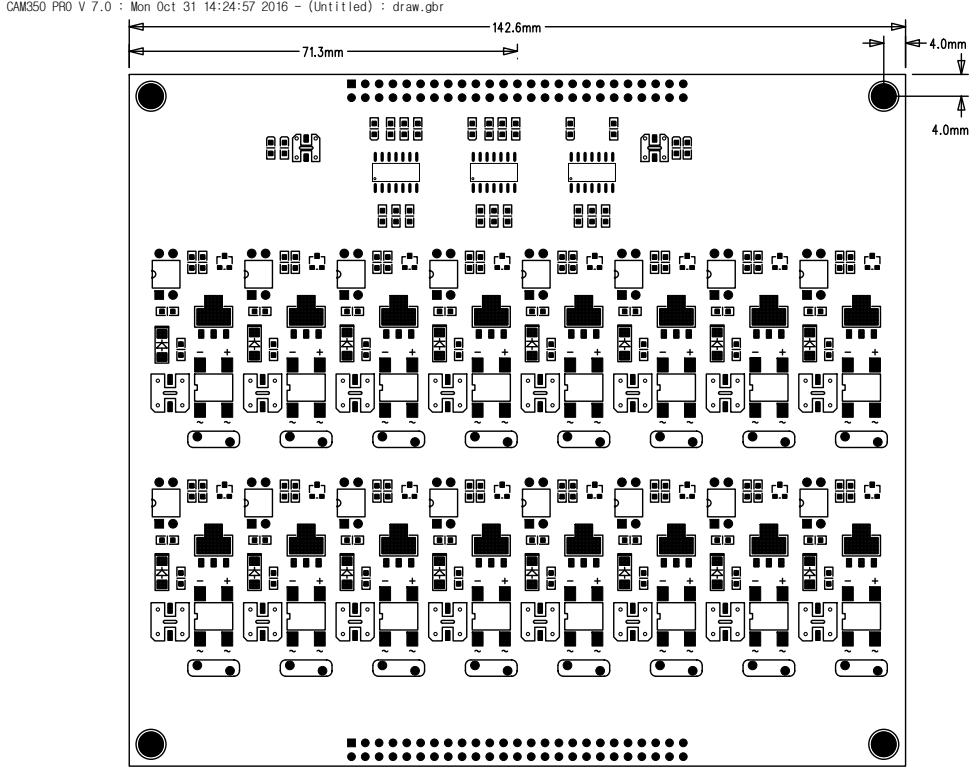
[picture p55: page 8]

CAM350 PRO V 7.0 : Mon Oct 31 14:24:57 2016 - (Untitled) : draw.gbr

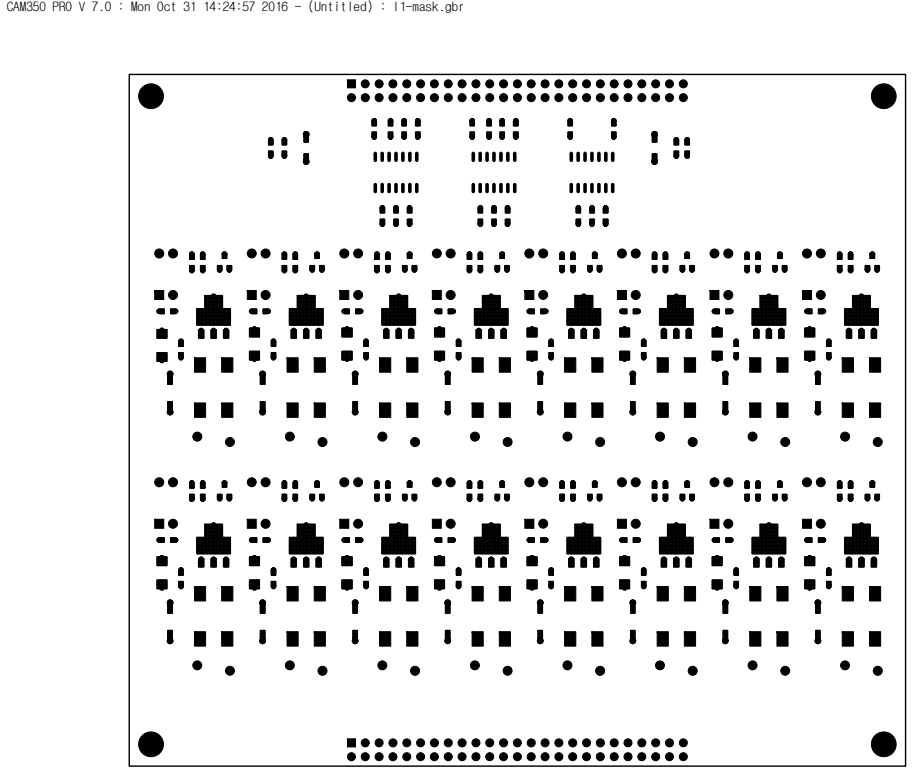
[picture p56: page 9]

CAM350 PRO V 7.0 : Mon Oct 31 14:24:57 2016 - (Untitled) : l1-mask.gbr

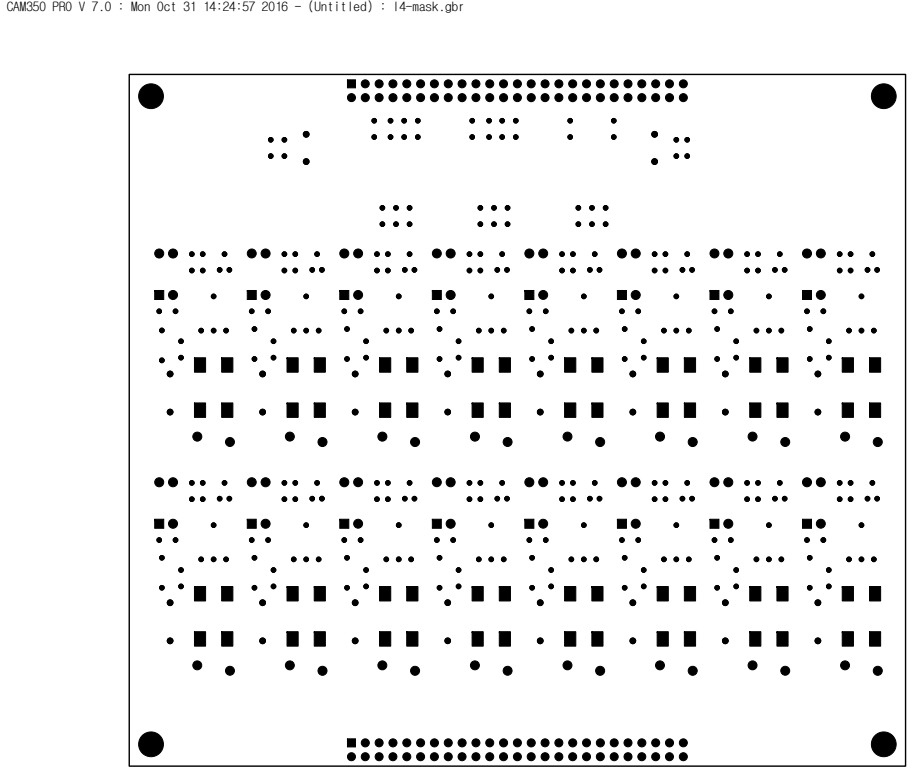
[picture p57: page 10]

CAM350 PRO V 7.0 : Mon Oct 31 14:24:57 2016 - (Untitled) : l4-mask.gbr

CAM350 PRO V 7.0 : Mon Oct 31 14:24:57 2016 - (Untitled) : l1-paste.gbr

CAM350 PRO V 7.0 : Mon Oct 31 14:24:57 2016 - (Untitled) : l4-paste.gbr
