ezfarm-farmcloud/cflora/hardware/ver.2/Circuit_PCB/MODULE_Relay2016/pdf/relay.pdf

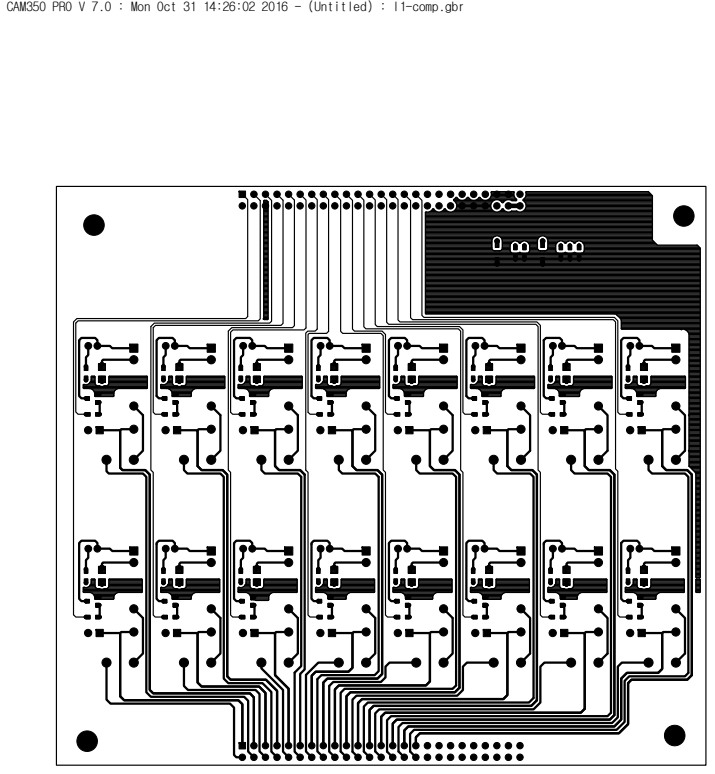
[picture p58: page 1]

CAM350 PRO V 7.0 : Mon Oct 31 14:26:02 2016 - (Untitled) : l1-comp.gbr

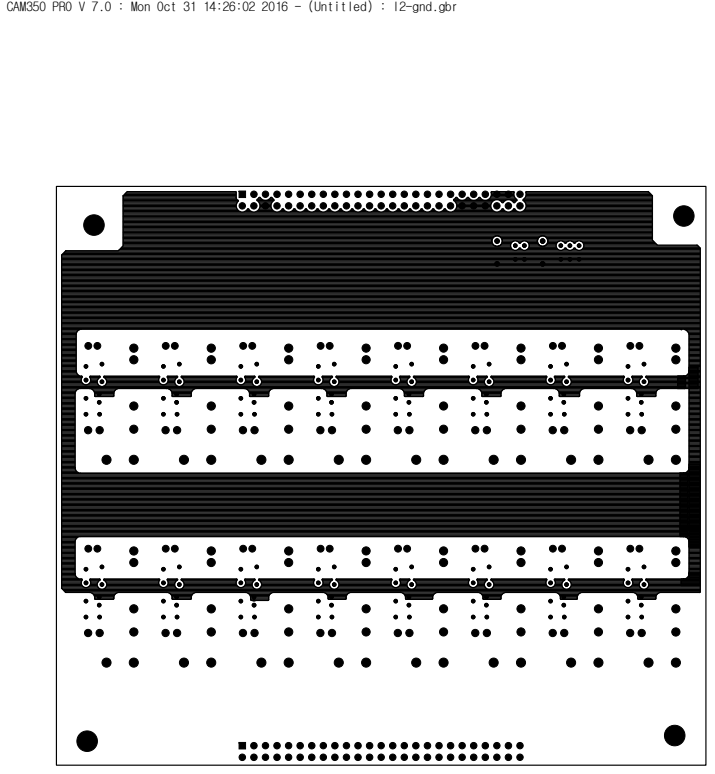
[picture p59: page 2]

CAM350 PRO V 7.0 : Mon Oct 31 14:26:02 2016 - (Untitled) : l2-gnd.gbr

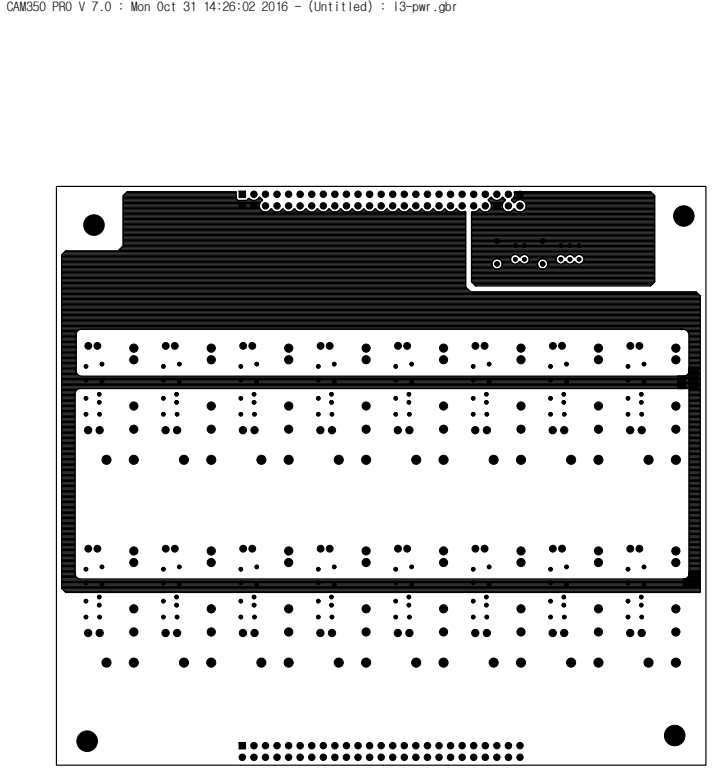
[picture p60: page 3]

CAM350 PRO V 7.0 : Mon Oct 31 14:26:02 2016 - (Untitled) : l3-pwr.gbr

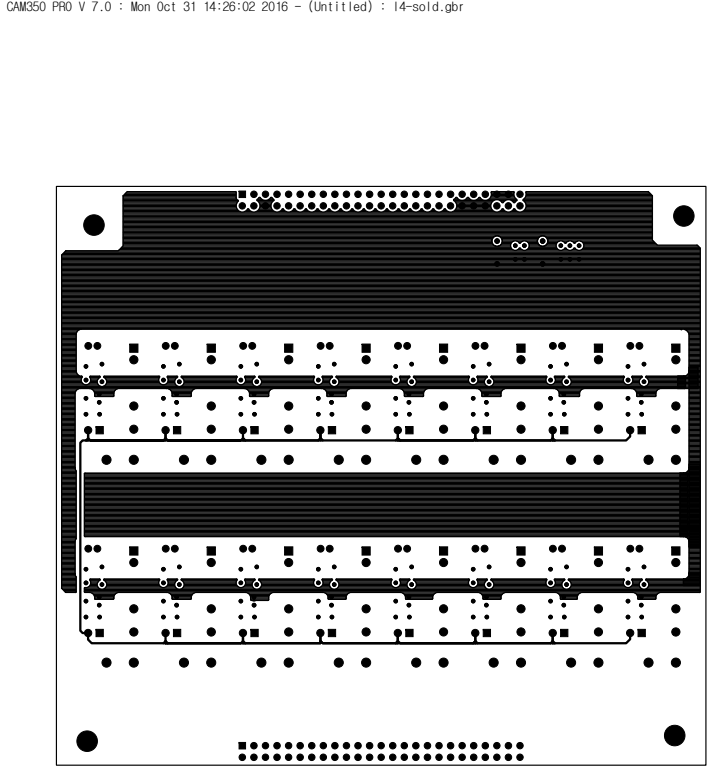
[picture p61: page 4]

CAM350 PRO V 7.0 : Mon Oct 31 14:26:02 2016 - (Untitled) : l4-sold.gbr

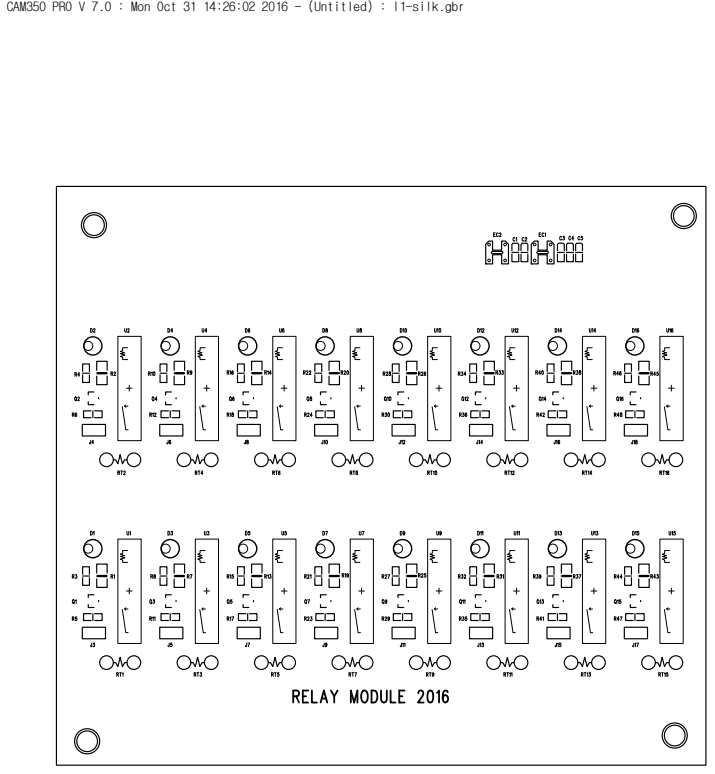
[picture p62: page 5]

CAM350 PRO V 7.0 : Mon Oct 31 14:26:02 2016 - (Untitled) : l1-silk.gbr

CAM350 PRO V 7.0 : Mon Oct 31 14:26:03 2016 - (Untitled) : l4-silk.gbr

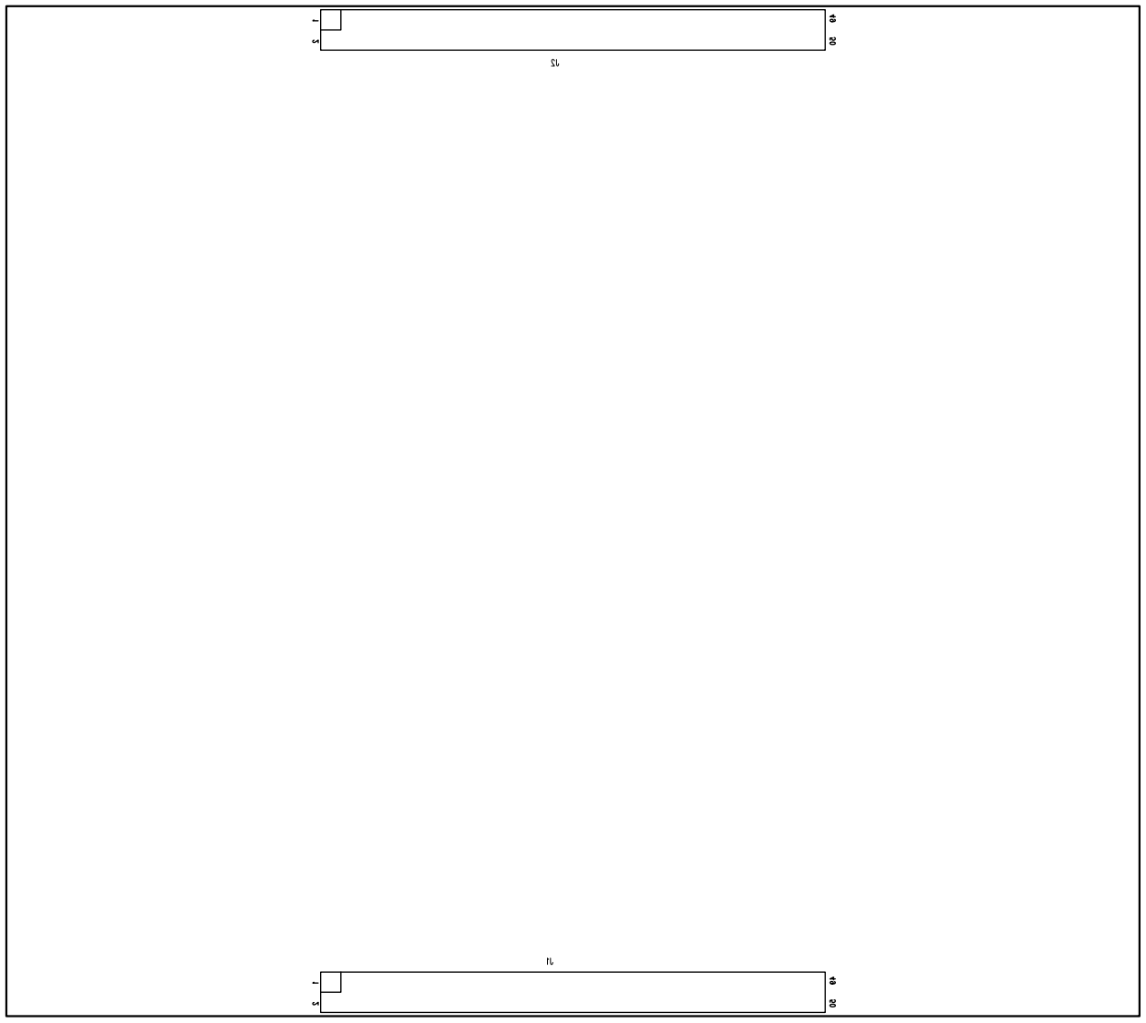
[picture p63: figure]
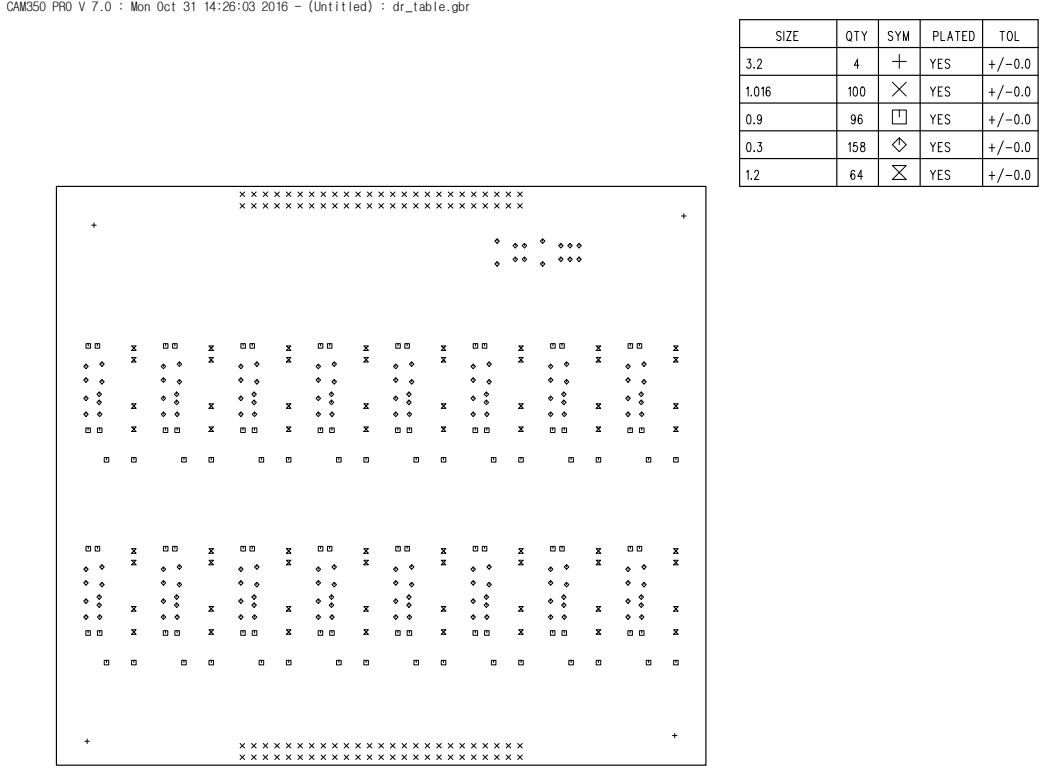
[picture p64: page 7]

CAM350 PRO V 7.0 : Mon Oct 31 14:26:03 2016 - (Untitled) : dr_table.gbr

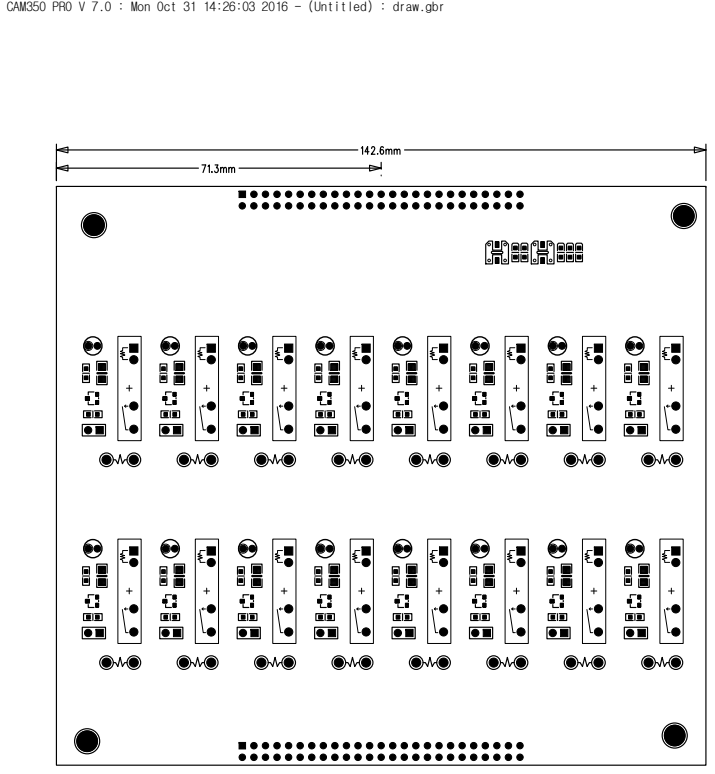
[picture p65: page 8]

CAM350 PRO V 7.0 : Mon Oct 31 14:26:03 2016 - (Untitled) : draw.gbr

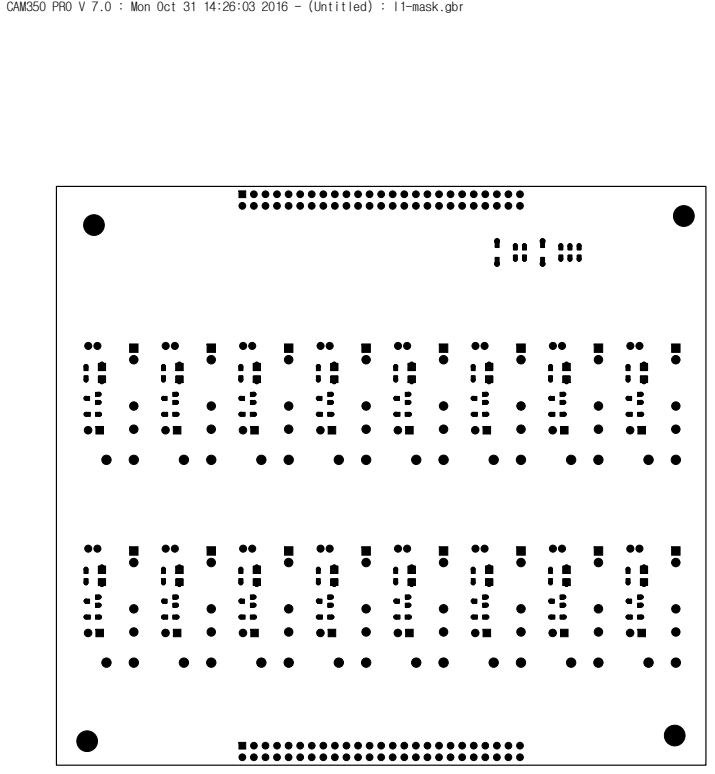
[picture p66: page 9]

CAM350 PRO V 7.0 : Mon Oct 31 14:26:03 2016 - (Untitled) : l1-mask.gbr

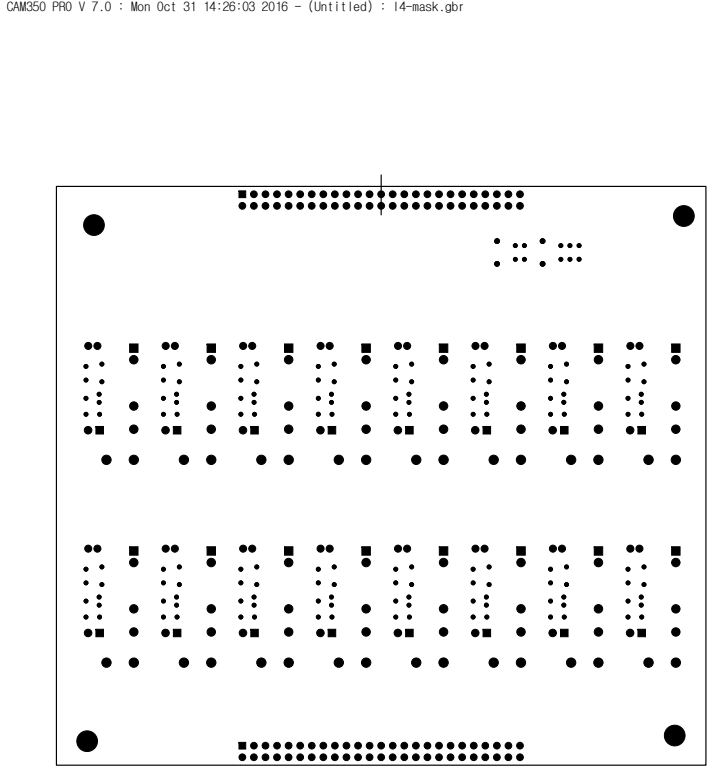
[picture p67: page 10]

CAM350 PRO V 7.0 : Mon Oct 31 14:26:03 2016 - (Untitled) : l4-mask.gbr

CAM350 PRO V 7.0 : Mon Oct 31 14:26:03 2016 - (Untitled) : l1-paste.gbr

CAM350 PRO V 7.0 : Mon Oct 31 14:26:03 2016 - (Untitled) : l4-paste.gbr
