ezfarm-farmcloud/cflora/hardware/ver.1/Circuit_PCB/CECS_Base_Board/PDF/cecs_baseboard_circuit.pdf

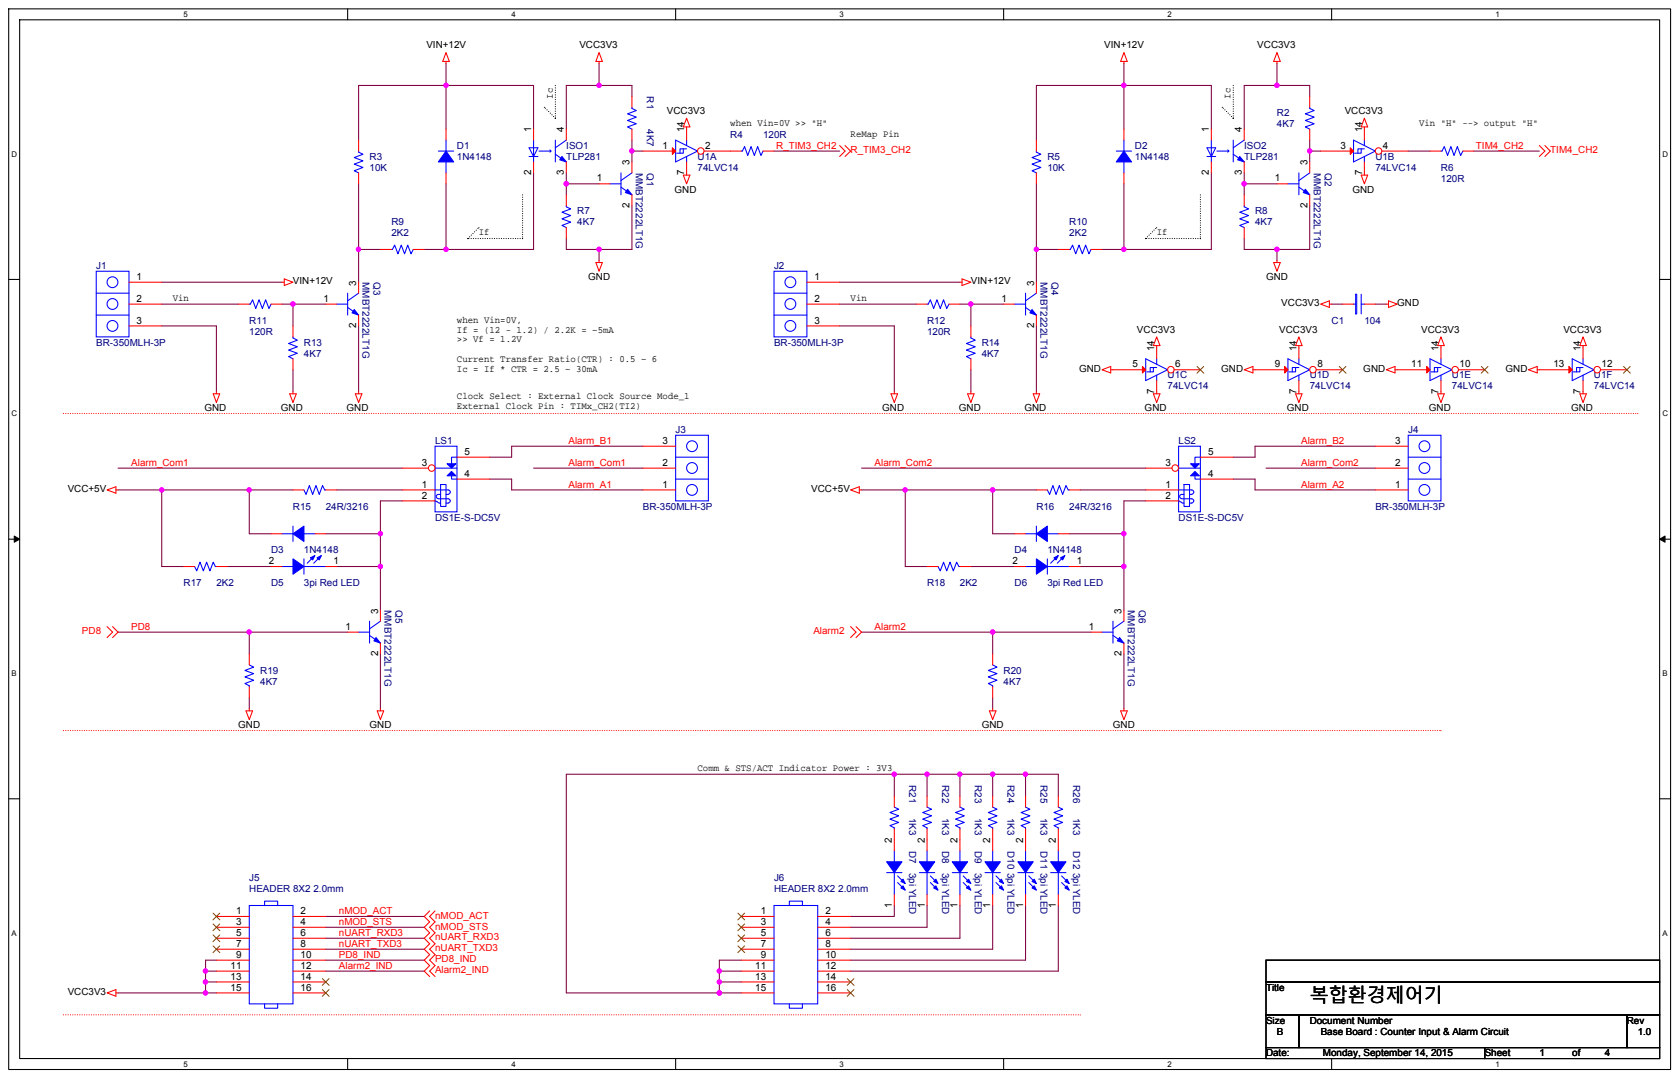
[picture p68: page 1]

when Vin=0V,
Current Transfer Ratio(CTR) : 0.5 ~ 6
Ic = If * CTR = 2.5 ~ 30mA

Clock Select : External Clock Source Mode_1
External Clock Pin : TIMx_CH2(TI2)

Comm & STS/ACT Indicator Power : 3V3

Size Size Size B B B | Document Number Document Number Document Number Base Board : Counter Input & Alarm Circuit Base Board : Counter Input & Alarm Circuit Base Board : Counter Input & Alarm Circuit | Rev Rev Rev 1.0 1.0 1.0

Date: Date: Date: Monday, September 14, 2015 Monday, September 14, 2015 Monday, September 14, 2015 | Sheet Sheet Sheet 1 1 1 of of of 4 4 4

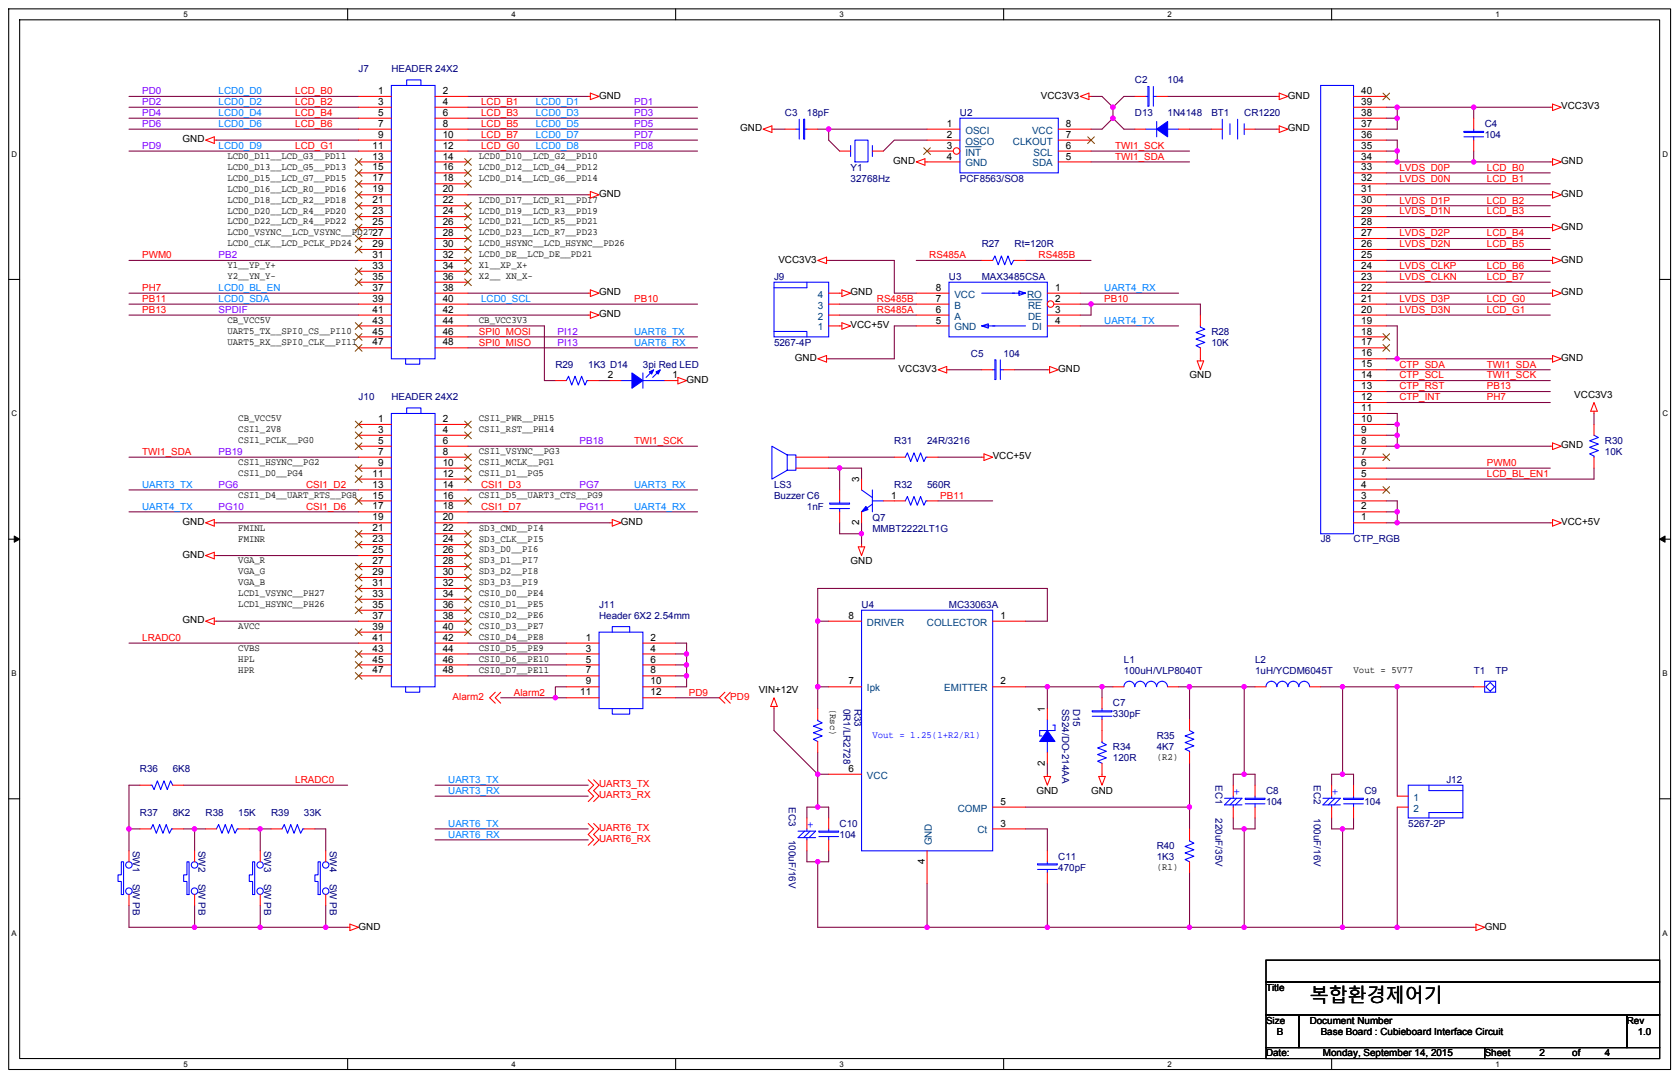
[picture p69: page 2]

44 CSI0_D5__PE9 3 | 4
46 CSI0_D6__PE10 5 | 6
48 CSI0_D7__PE11 7 | 8

Size Size Size B B B | Document Number Document Number Document Number Base Board : Cubieboard Interface Circuit Base Board : Cubieboard Interface Circuit Base Board : Cubieboard Interface Circuit | Rev Rev Rev 1.0 1.0 1.0

Date: Date: Date: Monday, September 14, 2015 Monday, September 14, 2015 Monday, September 14, 2015 | Sheet Sheet Sheet 2 2 2 of of of 4 4 4

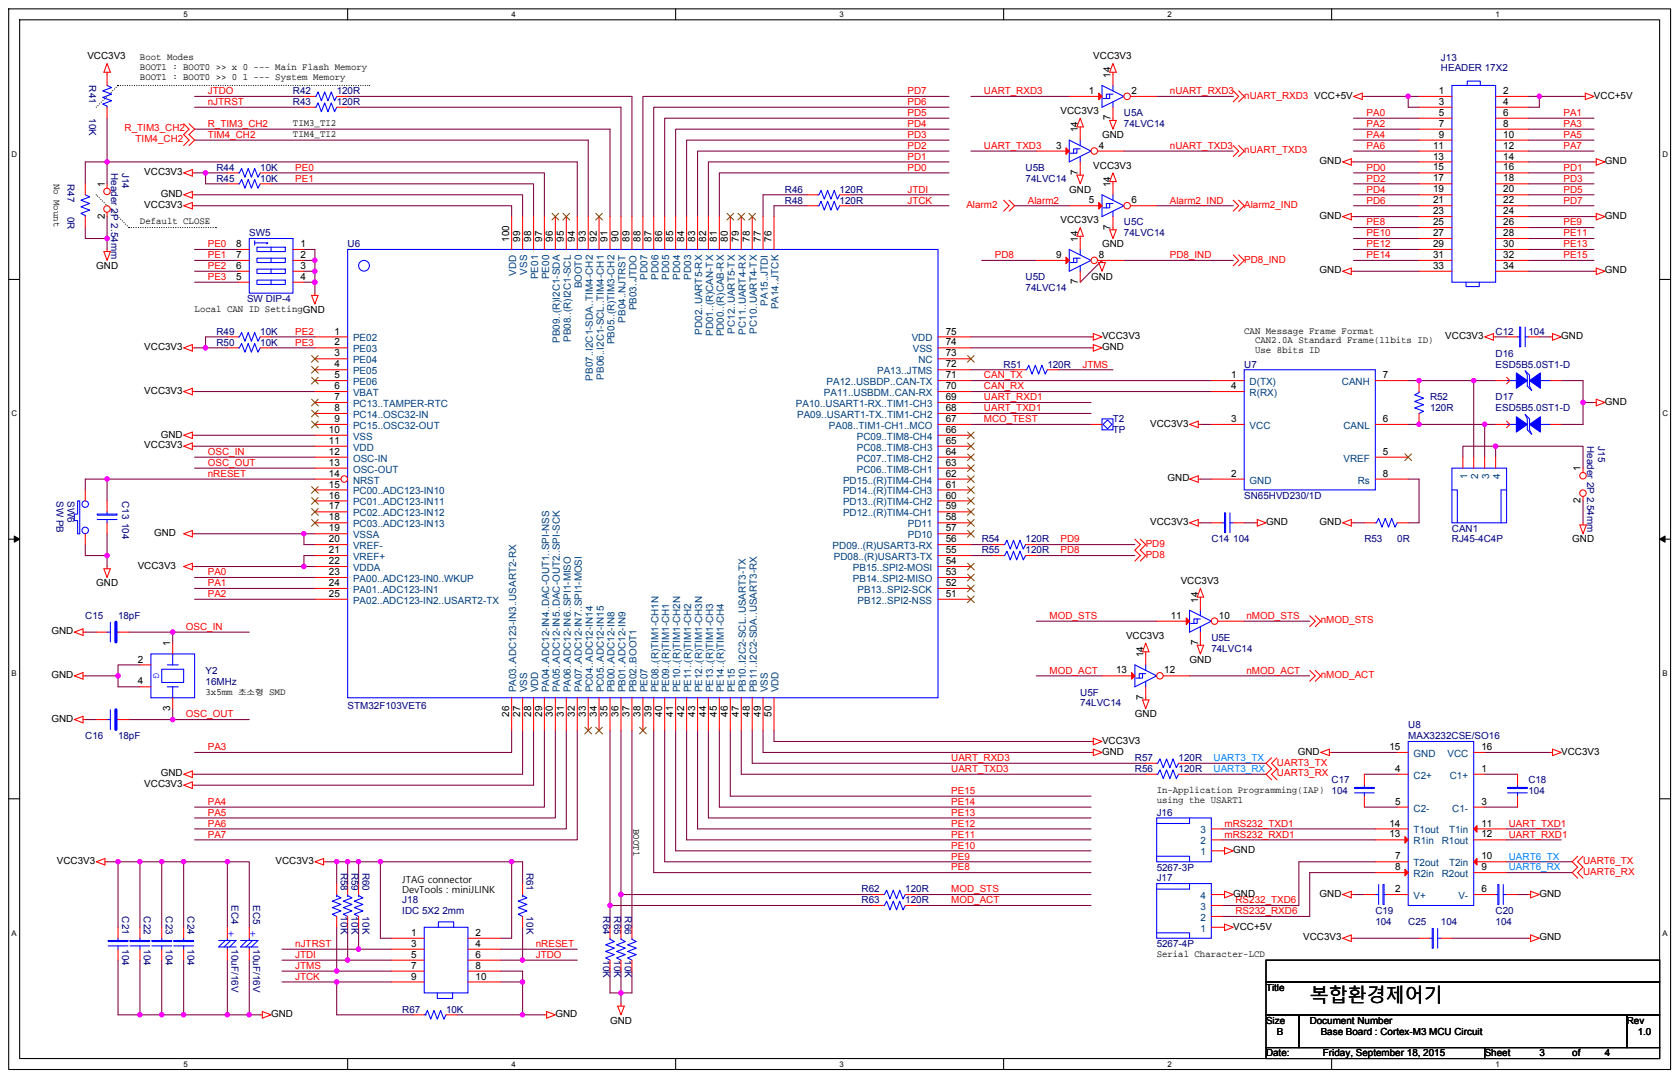
[picture p70: page 3]

PA14..JTCK 76 PA15..JTDI 77 PC10..UART4-TX 78 PC11..UART4-RX 79 PC12..UART5-TX 80 PD00..(R)CAB-RX 81 PD01..(R)CAN-TX 82 PD02..UART5-RX 83 PD03 84 PD04 85 PD05 86 PD06 87 PD07 88 PB03..JTDO 89 PB04..NJTRST 90 PB05..(R)TIM3-CH2 91 PB06..I2C1-SCL..TIM4-CH1 92 PB07..I2C1-SDA..TIM4-CH2 93 BOOT0 94 PB08..(R)I2C1-SCL 95 PB09..(R)I2C1-SDA 96 PE00 97 PE01 98 VSS 99 VDD 100SW5 SW DIP-4

Local CAN ID Setting

CAN Message Frame Format
CAN2.0A Standard Frame(11bits ID)
Use 8bits ID

VBAT 6 | CAN_RX | R(RX) 4 | R52 120R
PC13..TAMPER-RTC 7 | UART_RXD1 UART_TXD1 | VCC 3

PB11..I2C2-SDA..USART3-RX 48 PB10..I2C2-SCL..USART3-TX 47 PE15 46 PE14..(R)TIM1-CH4 45 PE13..(R)TIM1-CH3 44 PE12..(R)TIM1-CH3N 43 PE11..(R)TIM1-CH2 42 PE10..(R)TIM1-CH2N 41 PE09..(R)TIM1-CH1 40 PE08..(R)TIM1-CH1N 39 PE07 38 PB02..BOOT1 37 PB01..ADC12-IN9 36 PB00..ADC12-IN8 35 PC05..ADC12-IN15 34 PC04..ADC12-IN14 33

In-Application Programming(IAP)
using the USART1

Size Size Size B B B | Document Number Document Number Document Number Base Board : Cortex-M3 MCU Circuit Base Board : Cortex-M3 MCU Circuit Base Board : Cortex-M3 MCU Circuit | Rev Rev Rev 1.0 1.0 1.0

Date: Date: Date: Friday, September 18, 2015 Friday, September 18, 2015 Friday, September 18, 2015 | Sheet Sheet Sheet 3 3 3 of of of 4 4 4

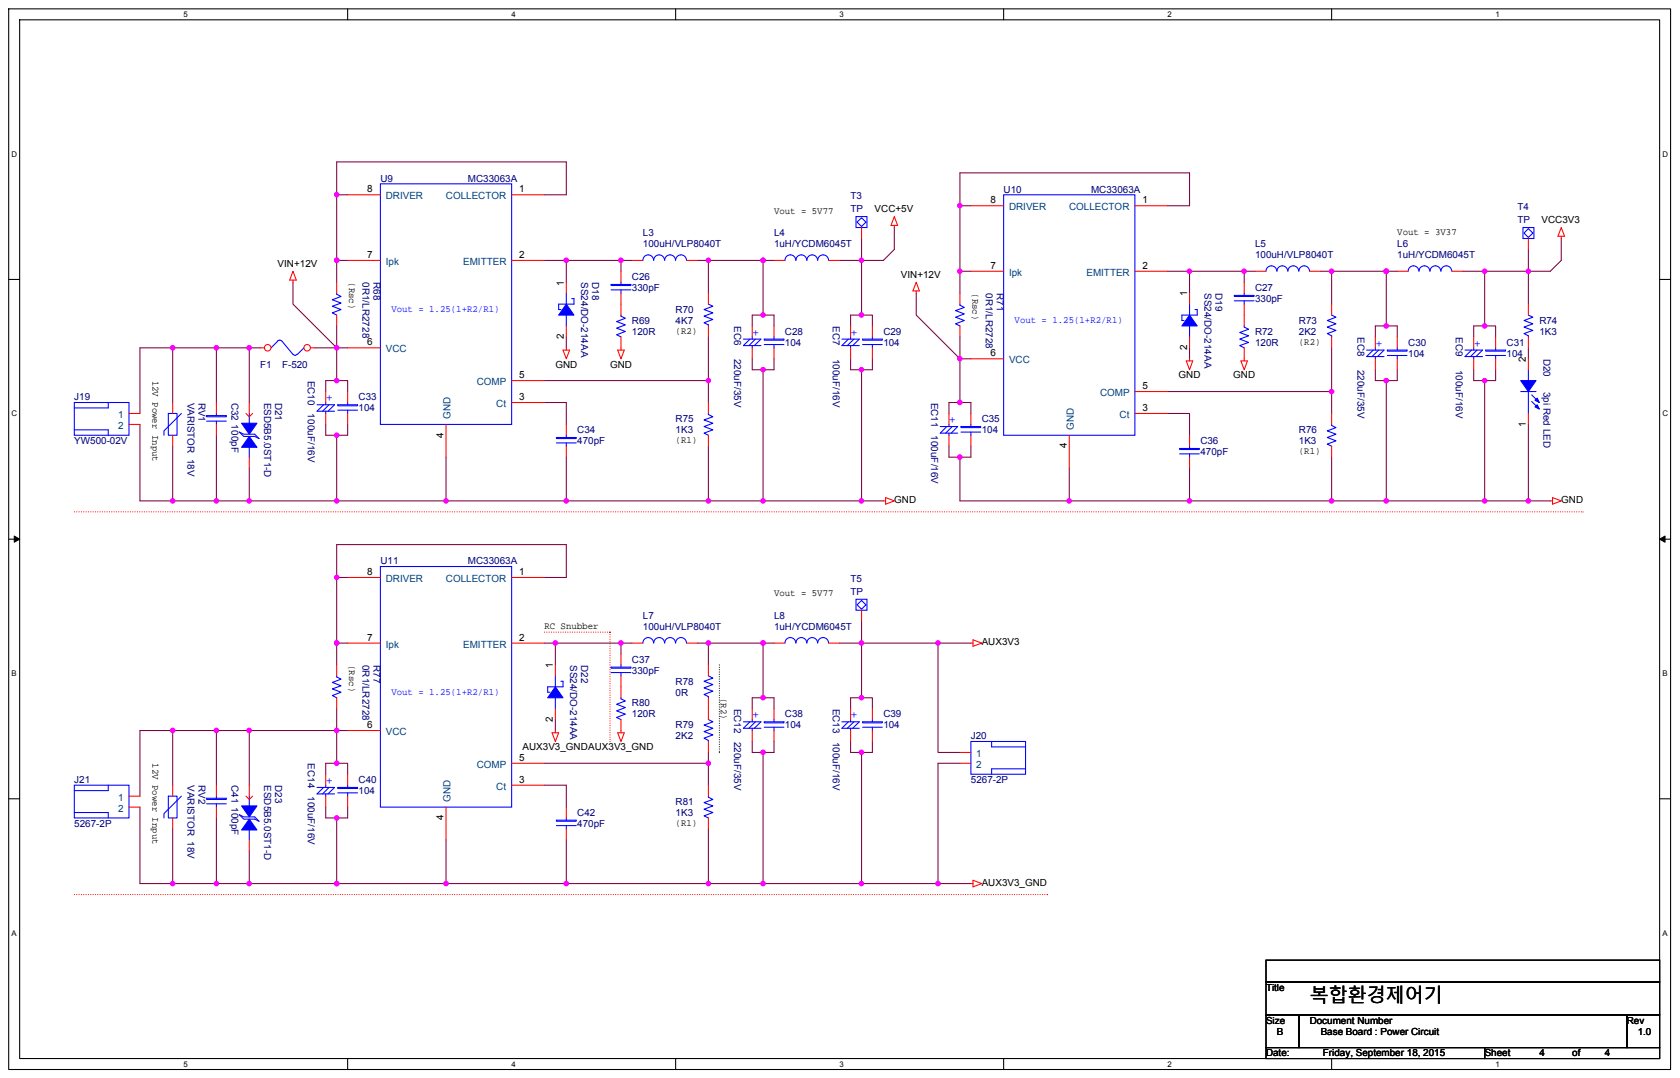
[picture p71: page 4]

12V Power Input 12V Power Input (R1)

Size Size Size B B B | Document Number Document Number Document Number Base Board : Power Circuit Base Board : Power Circuit Base Board : Power Circuit | Rev Rev Rev 1.0 1.0 1.0

Date: Date: Date: Friday, September 18, 2015 Friday, September 18, 2015 Friday, September 18, 2015 | Sheet Sheet Sheet 4 4 4 of of of 4 4 4
