ezfarm-farmcloud/cflora/hardware/ver.1/Circuit_PCB/CECS_MODULE_AtoD/pdf/cecs_module_atod_circuit.pdf

# 복합환경제어기

# 복합환경제어기

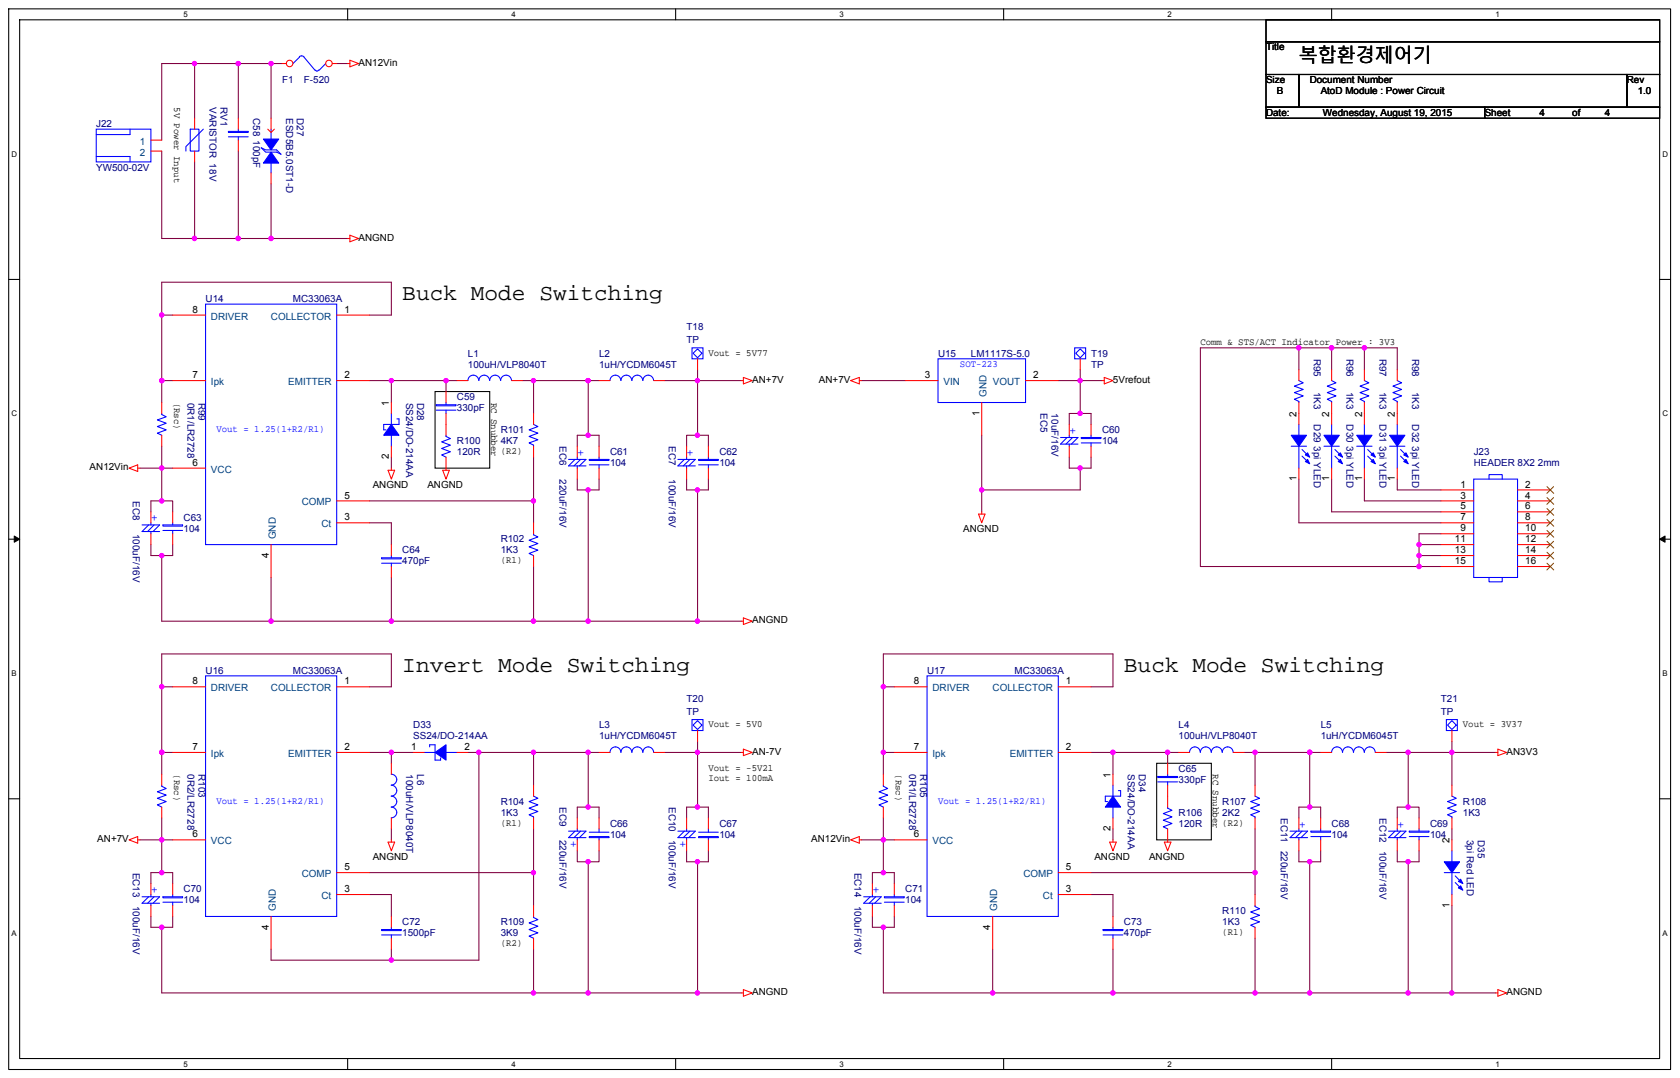
[picture p72: page 1]

Size Size Size B B B | Document Number Document Number Document Number AtoD Module : Power Circuit AtoD Module : Power Circuit AtoD Module : Power Circuit | Rev Rev Rev 1.0 1.0 1.0

Date: Date: Date: Wednesday, August 19, 2015 Wednesday, August 19, 2015 Wednesday, August 19, 2015 | Sheet Sheet Sheet 4 4 4 of of of 4 4 4

Comm & STS/ACT Indicator Power : 3V3

(Rsc) (Rsc) Vout = -5V21 Iout = 100mA

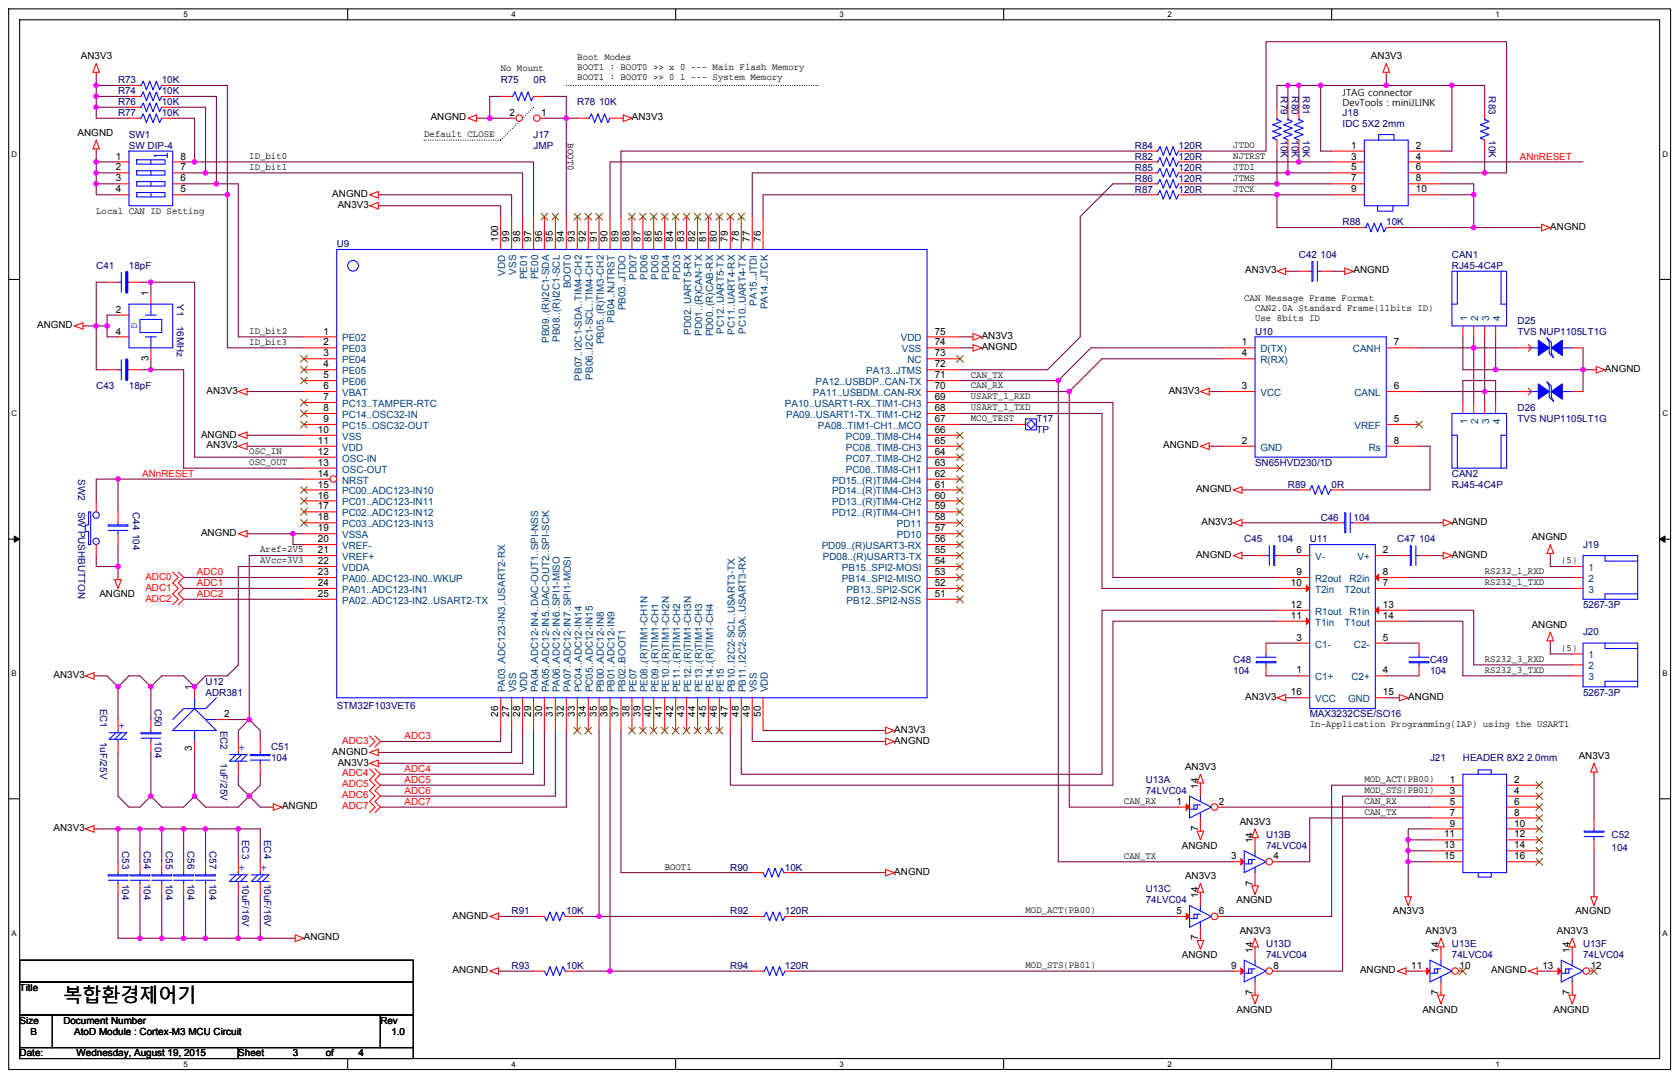
[picture p73: page 2]

Local CAN ID Setting

PA14..JTCK 76 PA15..JTDI 77 PC10..UART4-TX 78 PC11..UART4-RX 79 PC12..UART5-TX 80 PD00..(R)CAB-RX 81 PD01..(R)CAN-TX 82 PD02..UART5-RX 83 PD03 84 PD04 85 PD05 86 PD06 87 PD07 88 PB03..JTDO 89 PB04..NJTRST 90 PB05..(R)TIM3-CH2 91 PB06..I2C1-SCL..TIM4-CH1 92 PB07..I2C1-SDA..TIM4-CH2 93 BOOT0 94 PB08..(R)I2C1-SCL 95 PB09..(R)I2C1-SDA 96 PE00 97 PE01 98 VSS 99 VDD 100

PC13..TAMPER-RTC 7 PC14..OSC32-IN 8 PC15..OSC32-OUT 9 VSS 10 | USART_1_RXD

USART_1_TXD
MCO_TEST

PA00..ADC123-IN0..WKUP 23
PA01..ADC123-IN1 24 | | RS232_1_TXD
PA02..ADC123-IN2..USART2-TX 25 | R1out 12

PB11..I2C2-SDA..USART3-RX 48 PB10..I2C2-SCL..USART3-TX 47 PE15 46 PE14..(R)TIM1-CH4 45 PE13..(R)TIM1-CH3 44 PE12..(R)TIM1-CH3N 43 PE11..(R)TIM1-CH2 42 PE10..(R)TIM1-CH2N 41 PE09..(R)TIM1-CH1 40 PE08..(R)TIM1-CH1N 39 PE07 38 PB02..BOOT1 37 PB01..ADC12-IN9 36 PB00..ADC12-IN8 35 PC05..ADC12-IN15 34 PC04..ADC12-IN14 33

MAX3232CSE/SO16
In-Application Programming(IAP) using the USART1

Size Size Size B B B | Document Number Document Number Document Number AtoD Module : Cortex-M3 MCU Circuit AtoD Module : Cortex-M3 MCU Circuit AtoD Module : Cortex-M3 MCU Circuit | Rev Rev Rev 1.0 1.0 1.0

Date: Date: Date: Wednesday, August 19, 2015 Wednesday, August 19, 2015 Wednesday, August 19, 2015 | Sheet Sheet Sheet 3 3 3 of of of 4 4 4

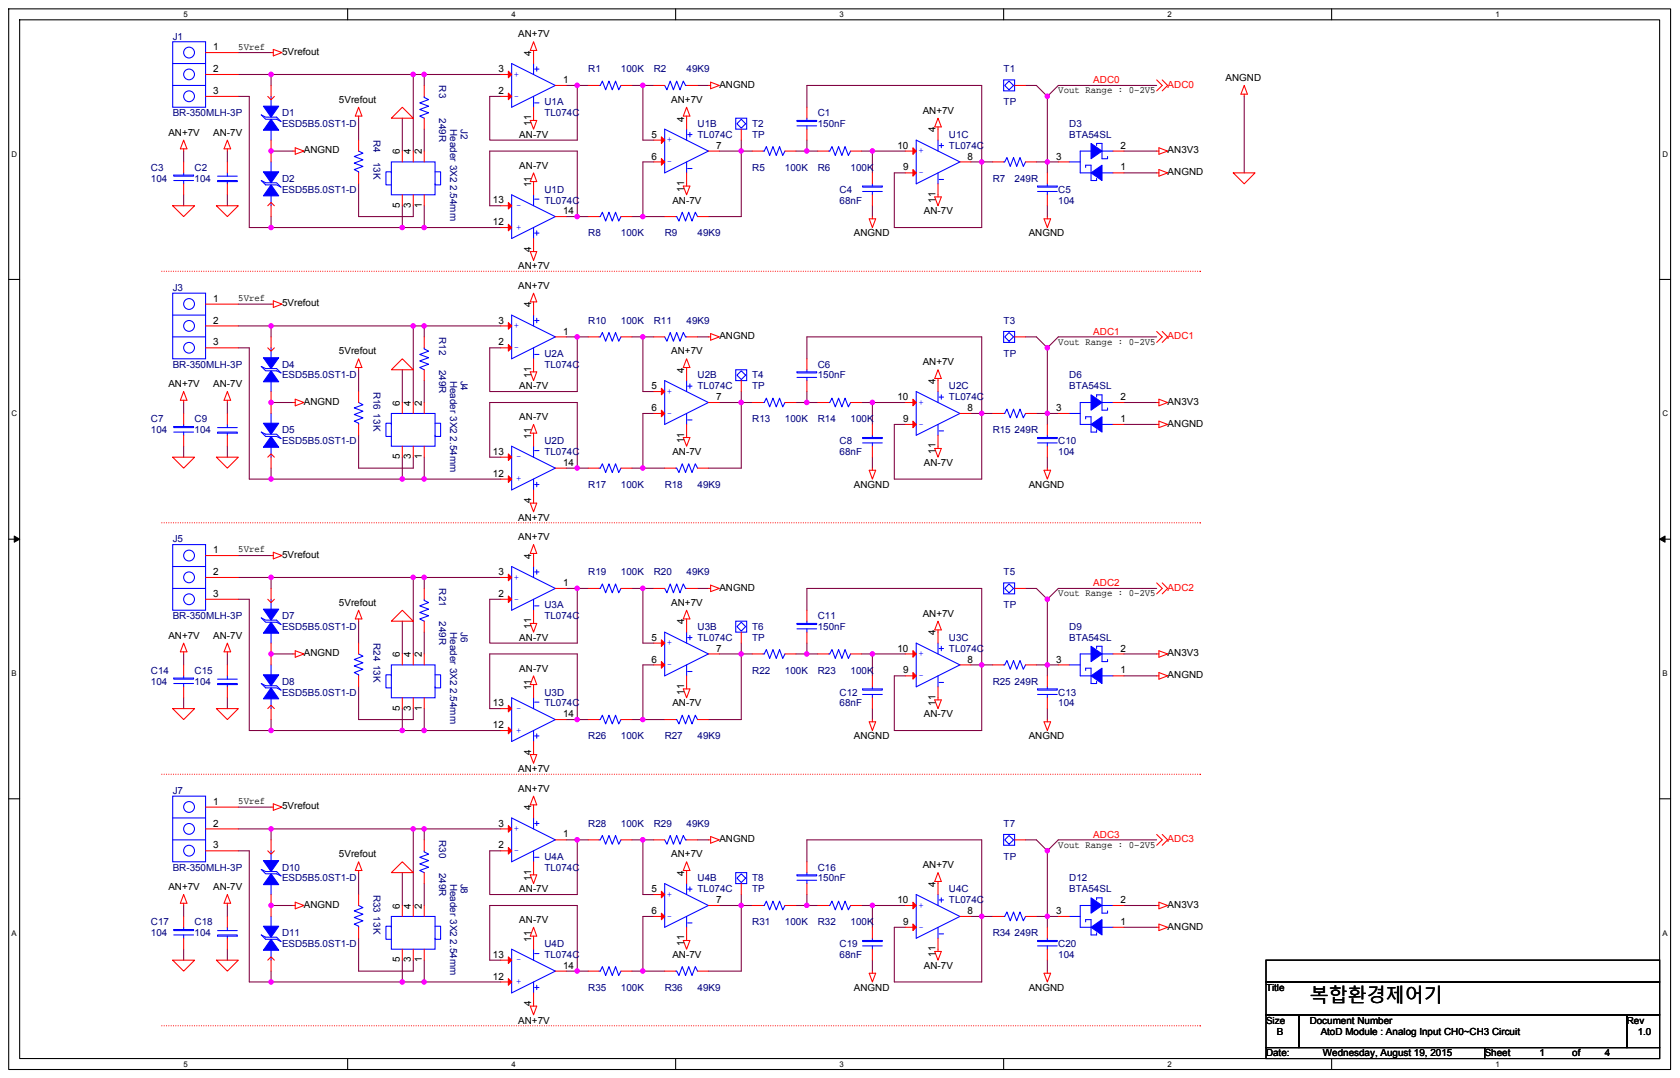
[picture p74: page 3]

Size Size Size B B B | Document Number Document Number Document Number AtoD Module : Analog Input CH0~CH3 Circuit AtoD Module : Analog Input CH0~CH3 Circuit AtoD Module : Analog Input CH0~CH3 Circuit | Rev Rev Rev 1.0 1.0 1.0

Date: Date: Date: Wednesday, August 19, 2015 Wednesday, August 19, 2015 Wednesday, August 19, 2015 | Sheet Sheet Sheet 1 1 1 of of of 4 4 4

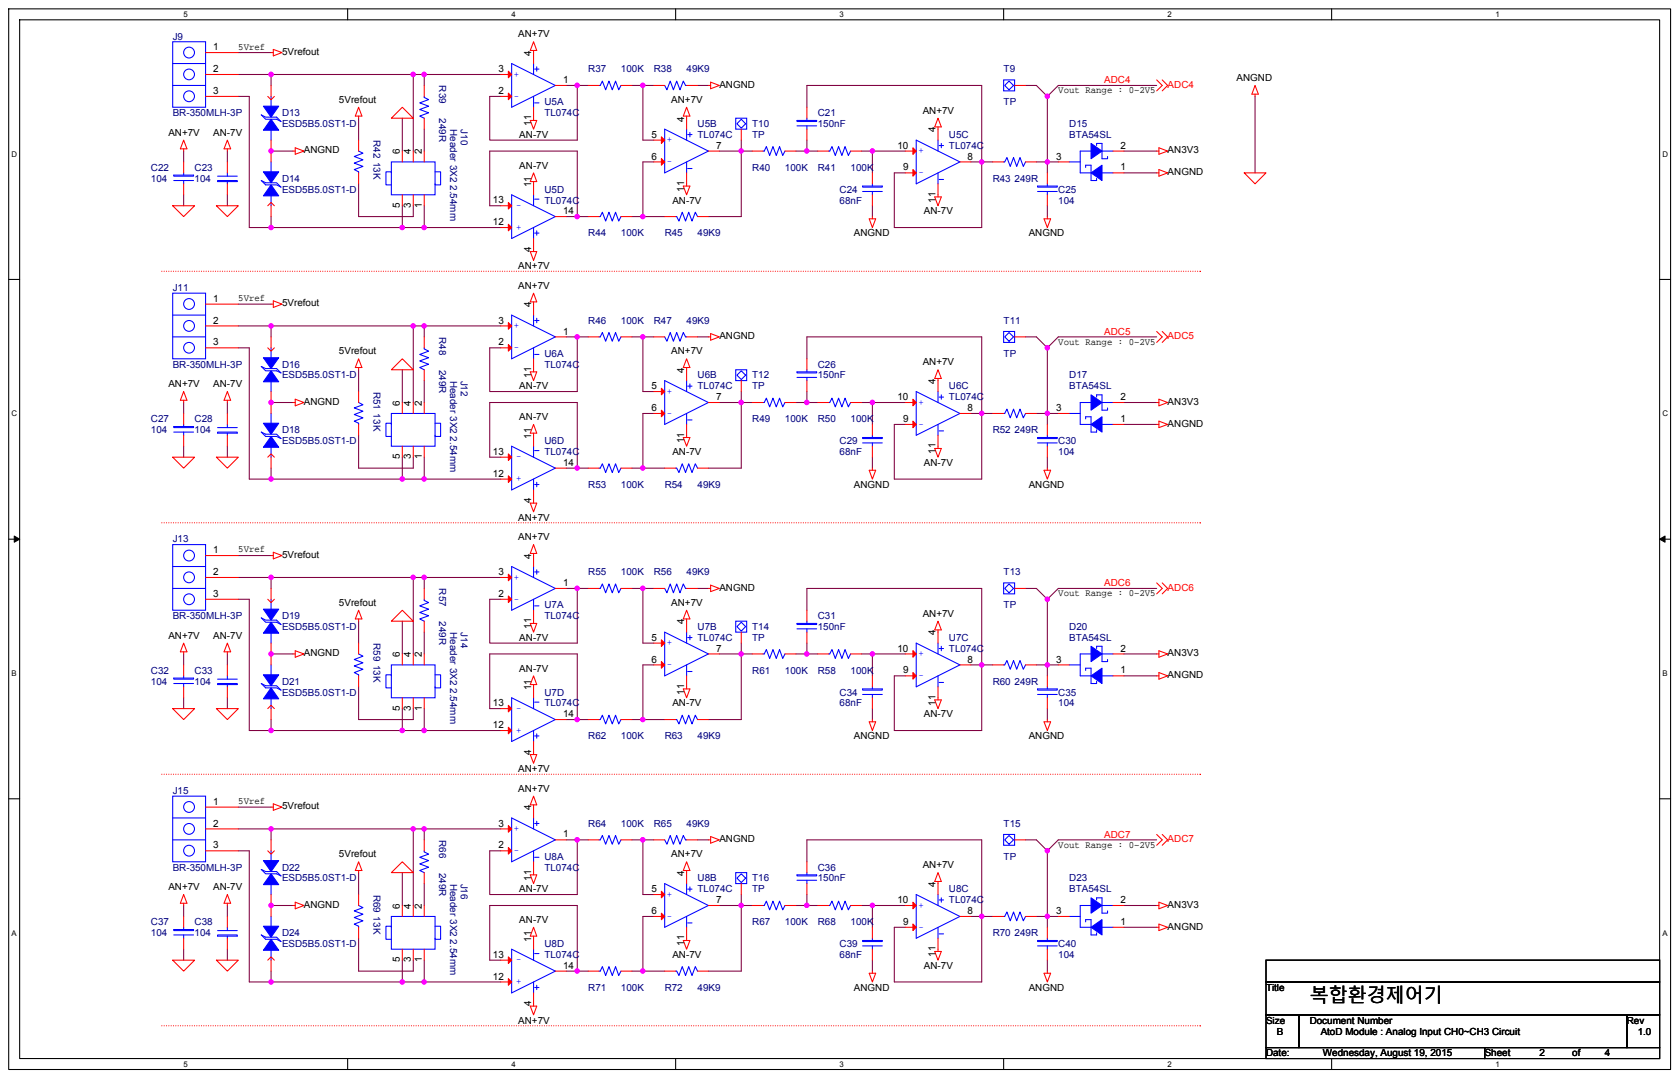
[picture p75: page 4]
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

Date: Date: Date: Wednesday, August 19, 2015 Wednesday, August 19, 2015 Wednesday, August 19, 2015 | Sheet Sheet Sheet 2 2 2 of of of 4 4 4
