ezfarm-farmcloud/cflora/hardware/ver.1/Circuit_PCB/CECS_MODULE_IsoInput/pdf/cecs_module_isoinput_circuit.pdf

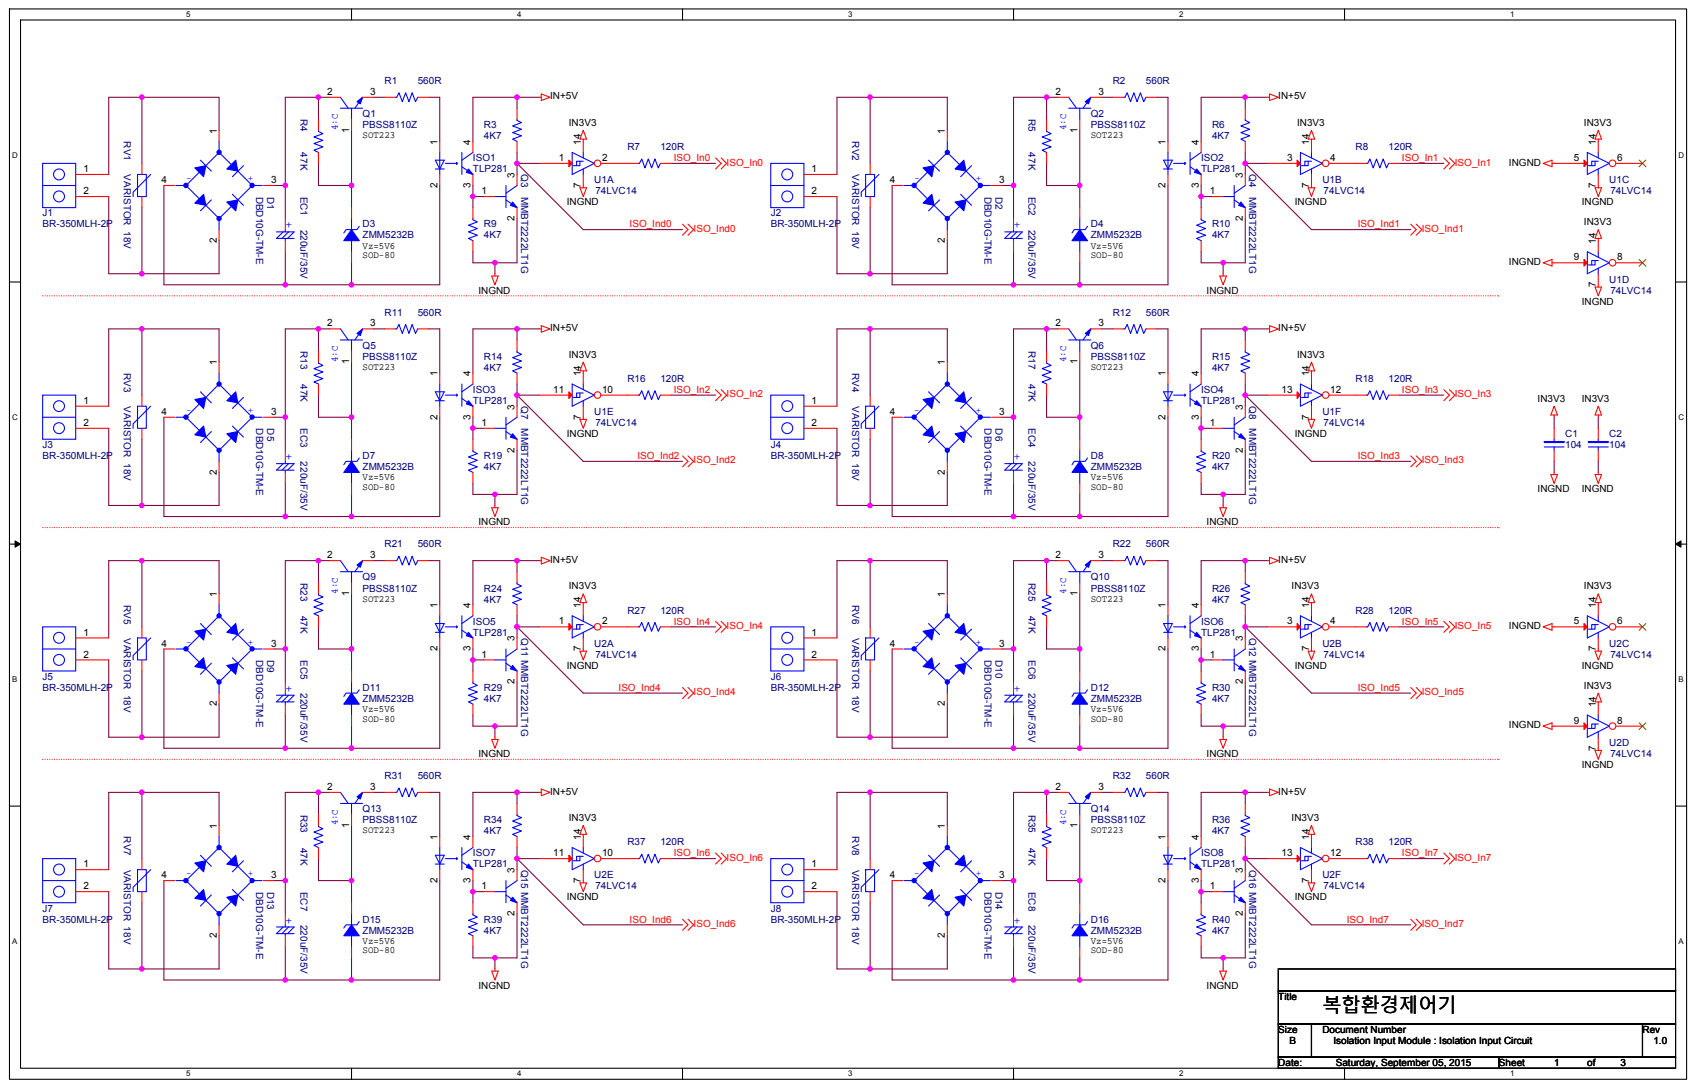
[picture p76: page 1]

Size Size Size B B B | Document Number Document Number Document Number Isolation Input Module : Isolation Input Circuit Isolation Input Module : Isolation Input Circuit Isolation Input Module : Isolation Input Circuit | Rev Rev Rev 1.0 1.0 1.0

Date: Date: Date: Saturday, September 05, 2015 Saturday, September 05, 2015 Saturday, September 05, 2015 | Sheet Sheet Sheet 1 1 1 of of of 3 3 3

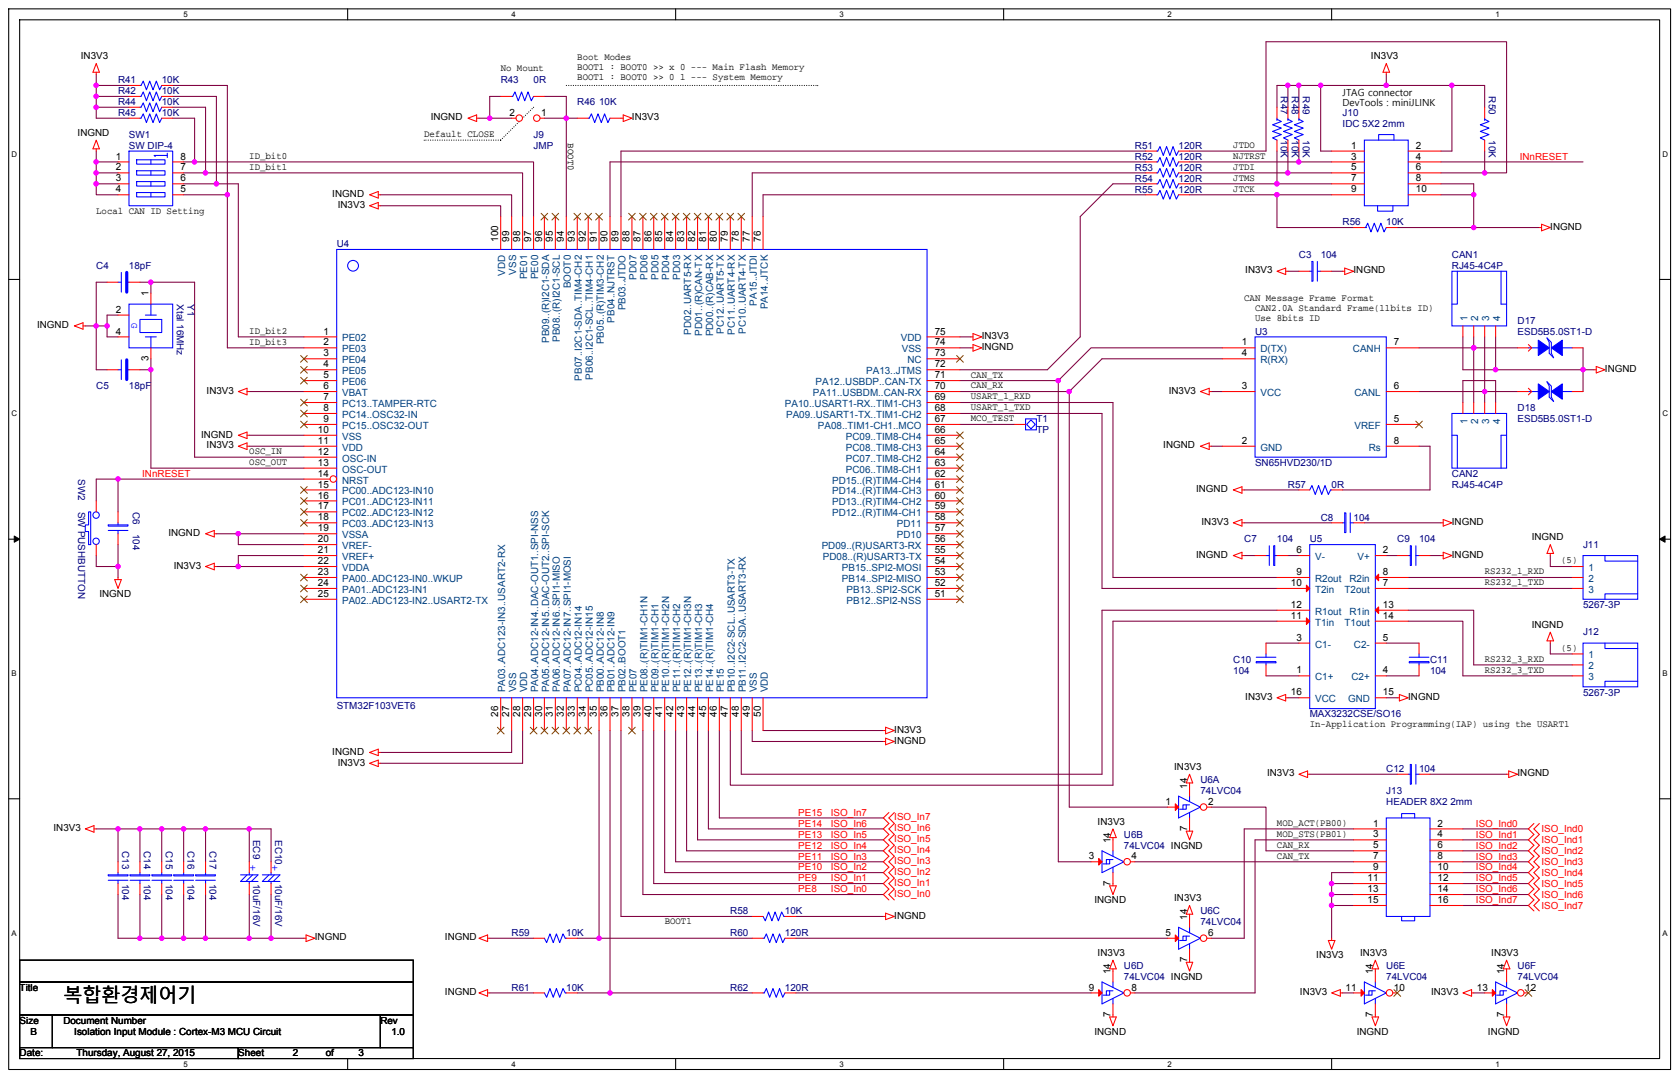
[picture p77: page 2]

Local CAN ID Setting

PA14..JTCK 76 PA15..JTDI 77 PC10..UART4-TX 78 PC11..UART4-RX 79 PC12..UART5-TX 80 PD00..(R)CAB-RX 81 PD01..(R)CAN-TX 82 PD02..UART5-RX 83 PD03 84 PD04 85 PD05 86 PD06 87 PD07 88 PB03..JTDO 89 PB04..NJTRST 90 PB05..(R)TIM3-CH2 91 PB06..I2C1-SCL..TIM4-CH1 92 PB07..I2C1-SDA..TIM4-CH2 93 BOOT0 94 PB08..(R)I2C1-SCL 95 PB09..(R)I2C1-SDA 96 PE00 97 PE01 98 VSS 99 VDD 100

PC13..TAMPER-RTC 7 PC14..OSC32-IN 8 PC15..OSC32-OUT 9 VSS 10 | USART_1_RXD

USART_1_TXD
MCO_TEST

PB11..I2C2-SDA..USART3-RX 48 PB10..I2C2-SCL..USART3-TX 47 PE15 46 PE14..(R)TIM1-CH4 45 PE13..(R)TIM1-CH3 44 PE12..(R)TIM1-CH3N 43 PE11..(R)TIM1-CH2 42 PE10..(R)TIM1-CH2N 41 PE09..(R)TIM1-CH1 40 PE08..(R)TIM1-CH1N 39 PE07 38 PB02..BOOT1 37 PB01..ADC12-IN9 36 PB00..ADC12-IN8 35 PC05..ADC12-IN15 34 PC04..ADC12-IN14 33

MAX3232CSE/SO16
In-Application Programming(IAP) using the USART1

Size Size Size B B B | Document Number Document Number Document Number Isolation Input Module : Cortex-M3 MCU Circuit Isolation Input Module : Cortex-M3 MCU Circuit Isolation Input Module : Cortex-M3 MCU Circuit | Rev Rev Rev 1.0 1.0 1.0

Date: Date: Date: Thursday, August 27, 2015 Thursday, August 27, 2015 Thursday, August 27, 2015 | Sheet Sheet Sheet 2 2 2 of of of 3 3 3

# Buck Mode Switching

# 복합환경제어기

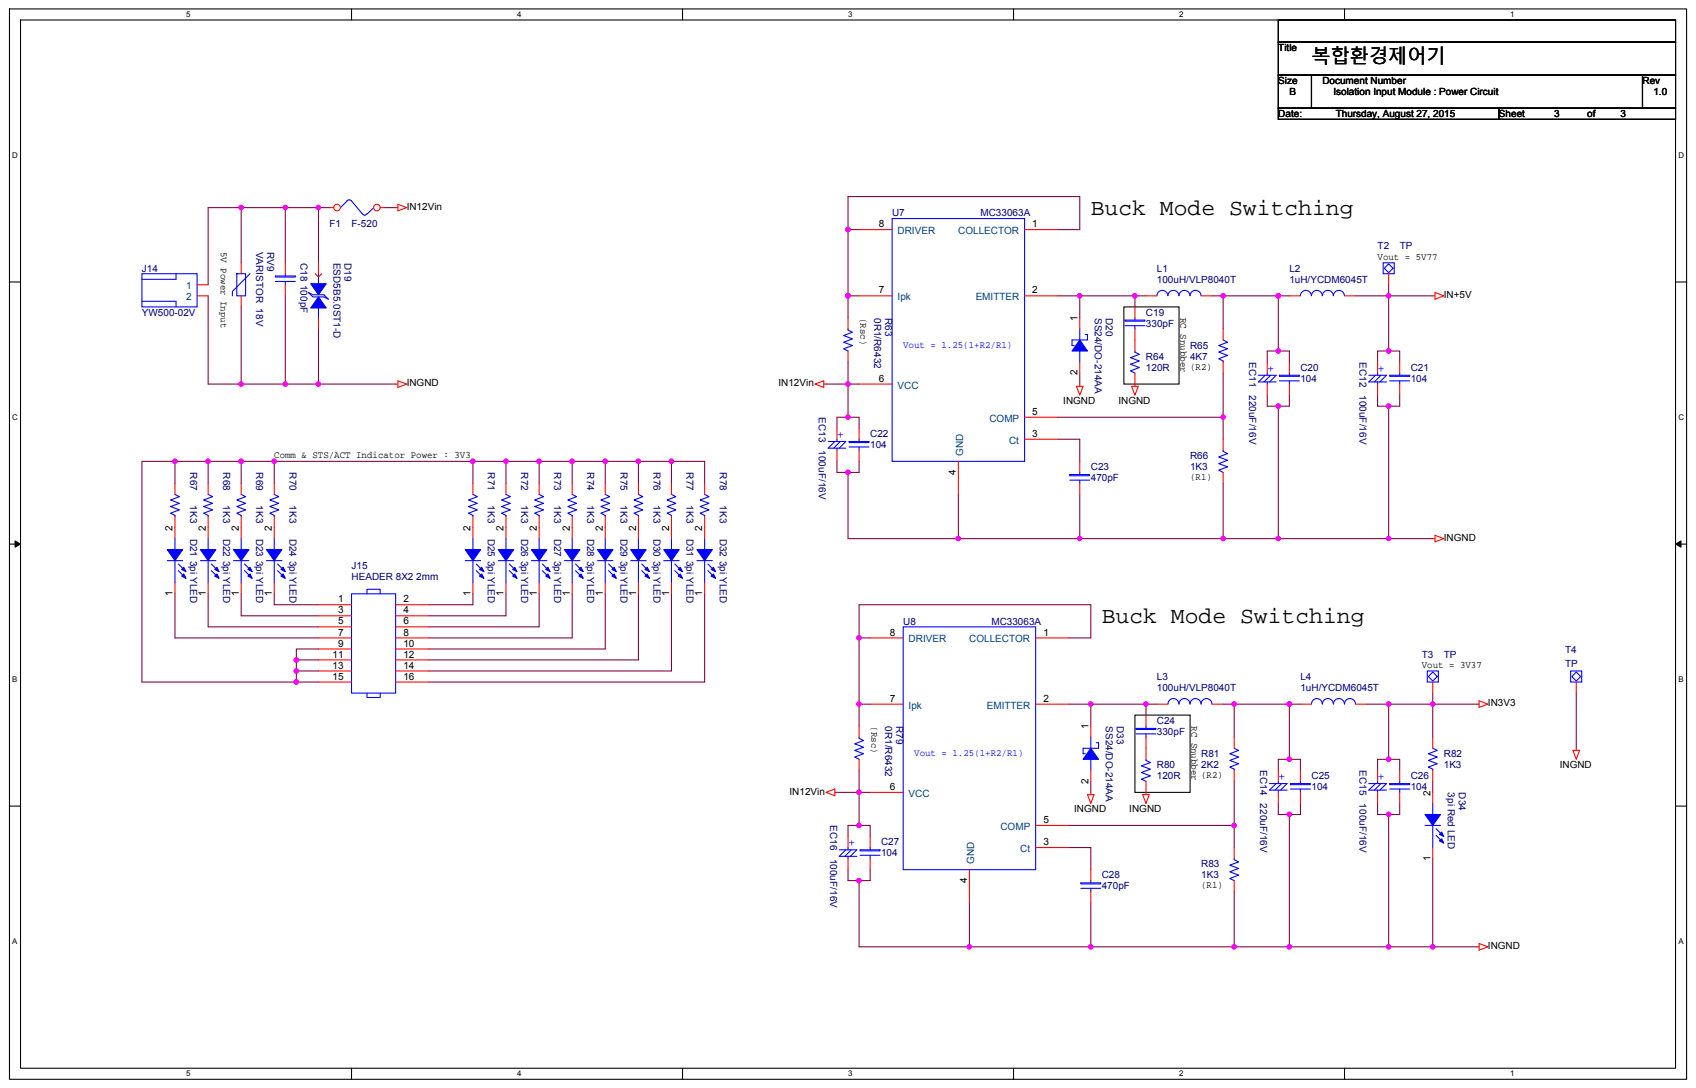
[picture p78: page 3]

Size Size Size B B B | Document Number Document Number Document Number Isolation Input Module : Power Circuit Isolation Input Module : Power Circuit Isolation Input Module : Power Circuit | Rev Rev Rev 1.0 1.0 1.0

Date: Date: Date: Thursday, August 27, 2015 Thursday, August 27, 2015 Thursday, August 27, 2015 | Sheet Sheet Sheet 3 3 3 of of of 3 3 3

Comm & STS/ACT Indicator Power : 3V3
