ezfarm-farmcloud/cflora/hardware/ver.1/Circuit_PCB/CECS_Base_Board/PDF/cecs_baseboard_layout.pdf

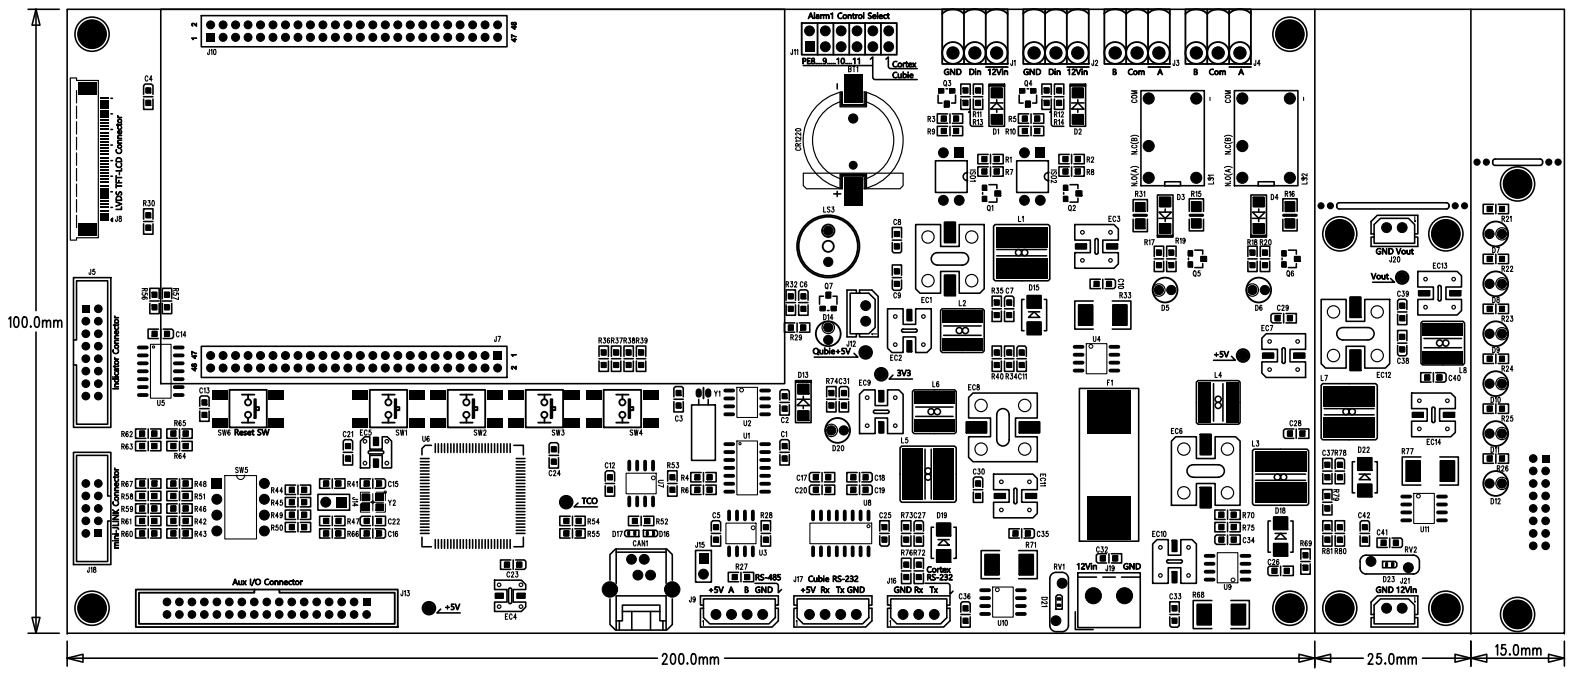
[picture p82: page 1]
