ezfarm-farmcloud/cflora/hardware/ver.1/Circuit_PCB/CECS_MODULE_AtoD/pdf/cecs_module_atod_layout.pdf

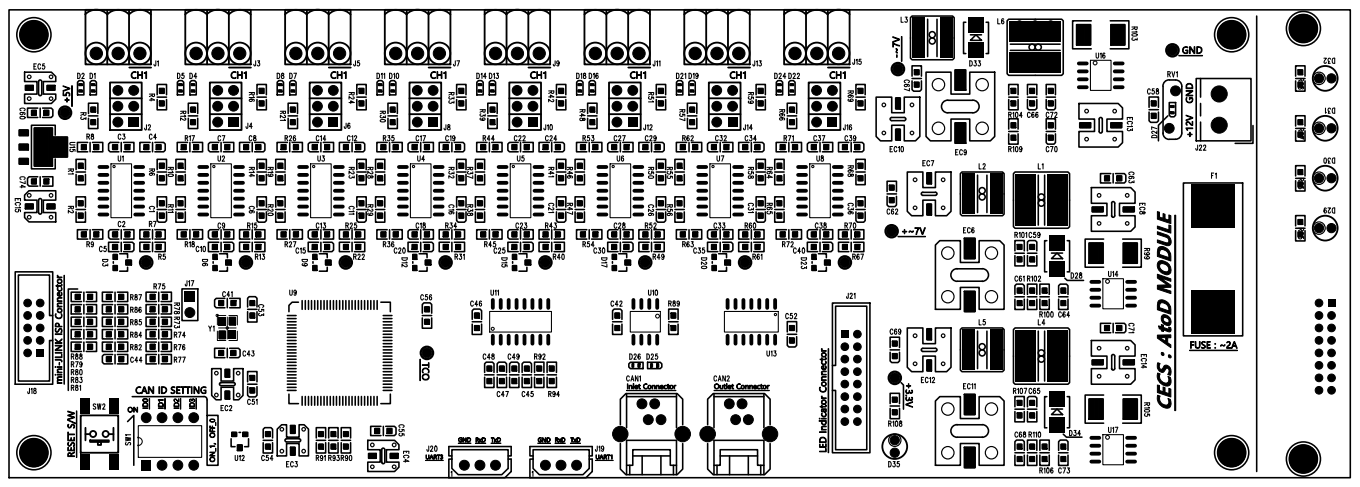
[picture p83: page 1]
