ezfarm-farmcloud/cflora/hardware/ver.1/Circuit_PCB/CECS_MODULE_IsoInput/pdf/cecs_module_isoinput_layout.pdf

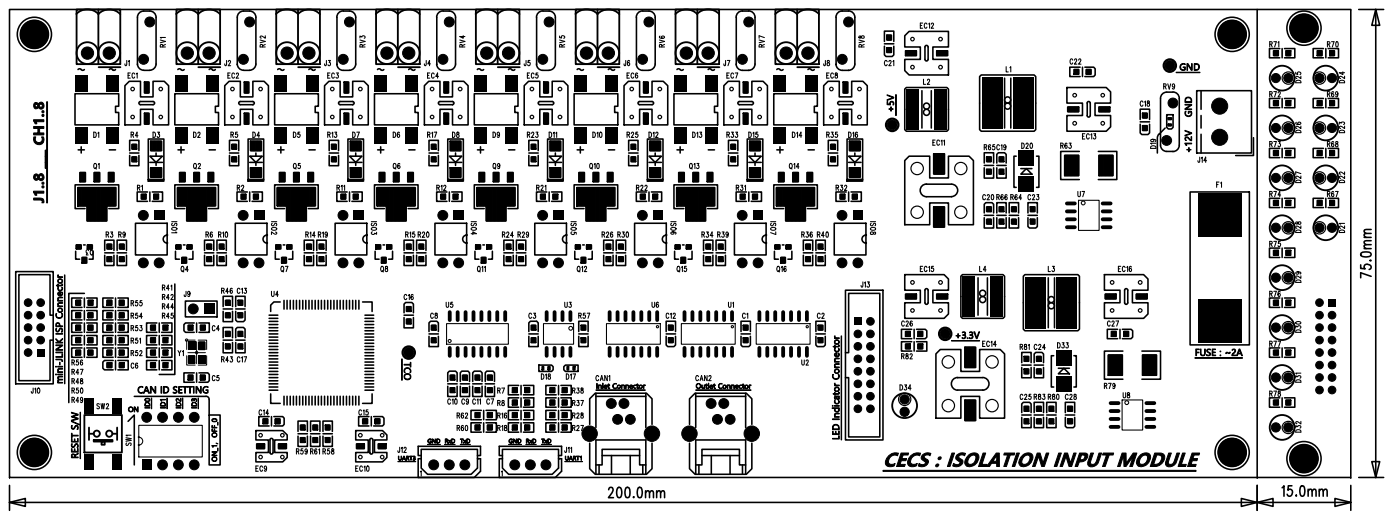
[picture p84: page 1]
