ezfarm-farmcloud/cflora/hardware/ver.1/Circuit_PCB/CECS_MODULE_Relay/pdf/cecs_module_relay_layout.pdf

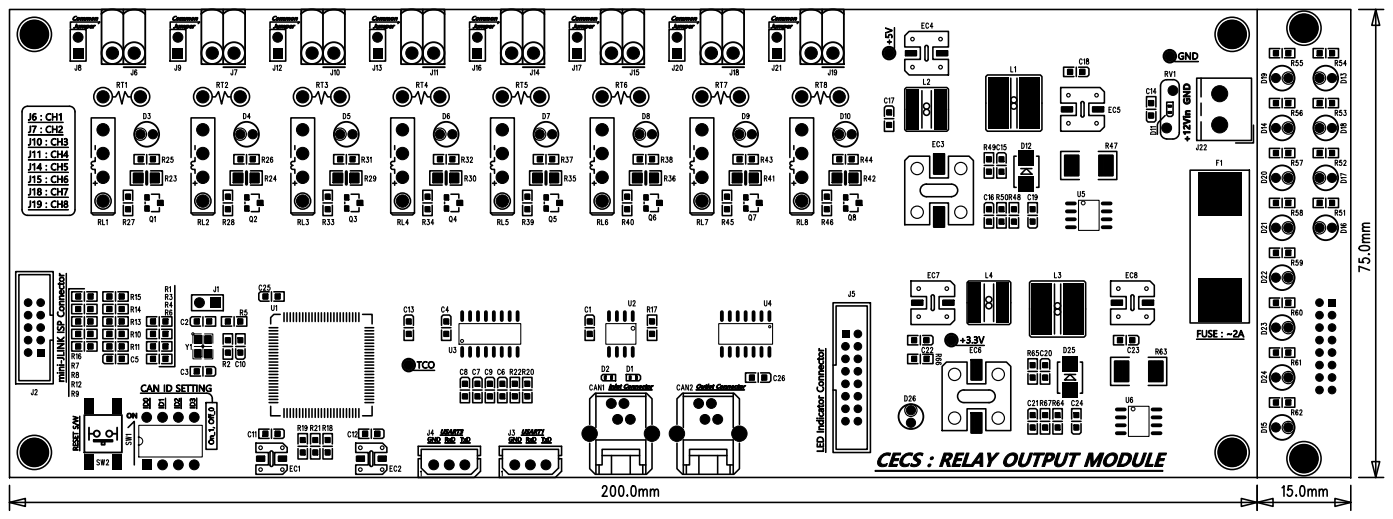
[picture p85: page 1]
