ezfarm-farmcloud/cflora/(list of files, drawings)

Other design files:
hardware/ver.1/Circuit_PCB/CECS_Base_Board/CECS_BASEBOARD_NEW.DSN
hardware/ver.1/Circuit_PCB/CECS_Base_Board/CECS_BASEBOARD_NEW.opj
hardware/ver.1/Circuit_PCB/CECS_Base_Board/CECS_BASEBOARD_NEW_Check.pcb
hardware/ver.1/Circuit_PCB/CECS_MODULE_AtoD/CECS_MODULE_ATOD.DSN
hardware/ver.1/Circuit_PCB/CECS_MODULE_AtoD/CECS_MODULE_AtoD.opj
hardware/ver.1/Circuit_PCB/CECS_MODULE_AtoD/CECS_Module_AtoD_Check.pcb
hardware/ver.1/Circuit_PCB/CECS_MODULE_IsoInput/CECS_MODULE_ISOINPUT.DSN
hardware/ver.1/Circuit_PCB/CECS_MODULE_IsoInput/CECS_MODULE_IsoInput.opj
hardware/ver.1/Circuit_PCB/CECS_MODULE_IsoInput/CECS_Module_IsoInput_Check.pcb
hardware/ver.1/Circuit_PCB/CECS_MODULE_Relay/CECS_MODULE_RELAY.DSN
hardware/ver.1/Circuit_PCB/CECS_MODULE_Relay/CECS_MODULE_Relay.opj
hardware/ver.1/Circuit_PCB/CECS_MODULE_Relay/CECS_Module_Relay_Check.pcb
hardware/ver.2/Circuit_PCB/CFLORA_BASE2016/pcb/cflora_base_1125.pcb
hardware/ver.2/Circuit_PCB/CFLORA_BASE2016/sch/CFLORA_BASE_11124.DSN
hardware/ver.2/Circuit_PCB/MODULE_AtoD2016/pcb/module_AtoD2016_1031.pcb
hardware/ver.2/Circuit_PCB/MODULE_AtoD2016/sch/CECS_MODULE_ATOD_1020.DSN
hardware/ver.2/Circuit_PCB/MODULE_AtoD2016/sch/cecs_module_atod_1020.opj
hardware/ver.2/Circuit_PCB/MODULE_IsoInput2016/pcb/cece_module_isoinput_1031.pcb
hardware/ver.2/Circuit_PCB/MODULE_IsoInput2016/sch/CECS_MODULE_ISOINPUT_1020.DSN
hardware/ver.2/Circuit_PCB/MODULE_Relay2016/pcb/cecs_module_relay_1031.pcb
hardware/ver.2/Circuit_PCB/MODULE_Relay2016/sch/CECS_MODULE_RELAY_1020.DSN
