ezfarm-farmcloud/cflora/software/node/src/TTA12daemon.cpp

/*
	TTA1,2 Simulator ver 2.1

*/


#include <stdarg.h>
#include <stdio.h>
#include <sys/types.h>
#include <sys/stat.h>
#include <fcntl.h>
#include <linux/input.h>
#include <string.h>
#include <stdlib.h>

#include "tcpman.h"
#include "Packet.h"
#include "util.h"
#include "TTA12_packet.h"
extern "C" {
#include "iniparser.h"
#include "rs232.h"
#include "hwctrl.h"
}

#include <time.h>
#include <regex.h>


int TransSensorDataCount=0;
int TransActuatorDataCount=0;
int SensorReadCount=0;
int RS2323ReadCount=0;
char GCG_connected=0;

u16	COMM_SENSOR_VALUE[MAX_COMM_SENSOR] ;
u8	comm_data_count1=0;
u8	comm_data_count2=0;
u8  newlineflag1=0;
u8  newlineflag2=0;


TTA12PacketParsing TTAParser;
TTA12PacketParsing TTAPtest;


pthread_t t_idTimer,t_idRS232;

pthread_mutex_t mutex_process ;
pthread_mutex_t mutex_key ;
pthread_mutex_t mutex_rsbuf[MAX_COMM_SENSOR] ;

/////////  TCP/IP manager //////////////////////////////
tcpmanager tcpman ;

WORD REG_PARSE( int idx,char *regdata) {
	int ret;
	char pattern[128], str[128], tmp[128];
	WORD RETVAL=0;

	int cflags = REG_EXTENDED;
	regex_t reg;

	strcpy(pattern, COMM_SENSOR[idx].EXP);
	strcpy(str, regdata);

	printf("regexp(%s),string(%s)\n", pattern, str);
	// reg compile
	ret = regcomp(&reg, pattern, cflags);
	if (ret != 0) {
		char errStr[128];
		regerror(ret, &reg, errStr, sizeof(errStr));
		printf("regcomp error(%s)\n", errStr);
		return 0;
	}

	int g = 0, len;
	int offset = 0, cnt = 1;
	// pattern matching
	regmatch_t pmatch[8];

	printf("comm sensor count (%d)(%d)\n", idx, COMM_SENSOR[idx].SENSOR_CNT);
	if ((ret = regexec(&reg, str+offset, COMM_SENSOR[idx].SENSOR_CNT + 1, pmatch, 0)) == 0) {
	    printf("regexec [%d]\n", ret);
        for (g = 0; g < COMM_SENSOR[idx].SENSOR_CNT + 1; g++) {
			if (pmatch[g].rm_so == (size_t)-1) {
				regfree(&reg);
                return -1;
            }
			if (g == 0)
                offset = pmatch[0].rm_eo;
            strcpy (tmp, str);
            tmp[pmatch[g].rm_eo] = 0;
            if (g > 0) {
				SI[COMM_SENSOR[idx].SENSOR_NODE * 8 + g - 1].data.value 
						= (WORD)(atof(tmp + pmatch[g].rm_so) * COMM_SENSOR[idx].ENCODE);
				printf("matched (%d:%s:%d)\n", g, tmp, SI[COMM_SENSOR[idx].SENSOR_NODE * 8 + g - 1].data.value);
			}
		}
	}
	regfree(&reg);

	return 0;
}


int ACTUATOR_NODE_CONTROL( int node, int mode, u8 ch,u8 set )
{

	COMMPACKET Packet ;

   u16 outSETMASK=0x0000;
   u16 outRESETMASK=0xFFFF;

	Packet.wCanID = ACTUATOR_MAP[node*16+ch].CANID  ;

	//memset( Packet.wData , 0 , 16 ) ;
	
	if( mode == REQCMD_INIT || mode == REQCMD_INIT_NODE || mode == REQCMD_INIT_ACT )
	{
			Packet.wData[0]= outSETMASK ;
			Packet.wData[1]= outRESETMASK ;
	}
	if( mode == REQCMD_ACTUATOR_SET )
	{
		if( set )
		{
			outSETMASK = 0x01 << ch ;
			outRESETMASK = 0x00 ;
		} else {
			outSETMASK = 0x00 ;
			outRESETMASK = 0x01 << ch  ;
		}

			Packet.wData[0]= outSETMASK ;
			Packet.wData[1]= outRESETMASK ;
	}

	printf( "ACTUATOR SET CAN_ID[%04X]--- ON[%04X] OFF[%04x]\n",
		Packet.wCanID ,
		Packet.wData[0],
		Packet.wData[1]
	) ;

	USART_SendPacket( COMM_SENSOR[0].PORT,&Packet ) ;
	usleep( 1000*100 ) ;

	return 1 ;
}
////////////////////////////////////////////////////////////////////////////////////
//

//
int TransOnStatusActuatorData( char mode )
{
	ActuatorValue NodeActData[16*8] ;
	int NodeDataCount=0;
	int scount=0;
	ActuatorValue GetActData[16*8] ;// at debug mode

	BYTE ncnt=0;
	BYTE cnt=0 ;
	TTA12Packet TTAPacket;

	for( ncnt = 0 ;ncnt < InstalledActuatorNodeCount ;ncnt++)
	{
		TTAPacket.Clear() ;
		TTAPacket.SetFrameDevice( FCF_ACTUATOR ) ;
		TTAPacket.SetFrameType( FTYPE_DATA ) ;
		TTAPacket.SetSecurity( 1 ) ;
		TTAPacket.SetAckConfirm( 1 ) ;
		TTAPacket.SetControlID( HouseControl_ID ) ;

		TTAPacket.SetNodeID( ncnt ) ;
		SequenceCount++ ;
		TTAPacket.MakeHeader() ;
		TTAPacket.MakePayload() ;
		NodeDataCount=0;

		for( cnt=0; cnt < 16 ;cnt++)
		{
//			if ( AI[ncnt*16+cnt].data.value != 0 ) {

			//printf(" id=%d,%d aData[%d].value =  %d \n",TTAParser.aData[i].id,TTAParser.aData[i].type,i,TTAParser.aData[i].value ) ;
			if( AI[ncnt*16+cnt].state == mode &&  AI[ncnt*16+cnt].data.id < 255 )
			{

				NodeActData[NodeDataCount].id = AI[ncnt*16+cnt].data.id ;
				NodeActData[NodeDataCount].type = AI[ncnt*16+cnt].data.type  ;
				//NodeActData[NodeDataCount].value = AI[ncnt*16+cnt].data.value | ( ACTUATOR_MAP[ncnt*16+cnt].ARG<<12 ) ;
				NodeActData[NodeDataCount].value = ACTUATOR_MAP[ncnt*16+cnt].COUNT | ( ACTUATOR_MAP[ncnt*16+cnt].ARG<<12 ) ;

				//ACTUATOR_MAP[b*8+i].ARG
				if( mode == 0x04 )
				{
					if( AI[ncnt*16+cnt].data.value == 0 )
					{
						printf("NODE: %d Add OFF ACT %d %d %d ARG=%d\n",ncnt ,
								NodeActData[NodeDataCount].id,
								NodeActData[NodeDataCount].type,
								NodeActData[NodeDataCount].value,
							ACTUATOR_MAP[ncnt*16+cnt].ARG

							) ;

					} else {
						printf("NODE : %d Add ON ACT %d %d %d ARG=%d\n",ncnt ,
								NodeActData[NodeDataCount].id,
								NodeActData[NodeDataCount].type,
								NodeActData[NodeDataCount].value,
							ACTUATOR_MAP[ncnt*16+cnt].ARG

							) ;
					}
				} else {
						printf("NODE : %d STARTUP ACT INFO %d %d %d ARG=%d\n",ncnt ,
								NodeActData[NodeDataCount].id,
								NodeActData[NodeDataCount].type,
								NodeActData[NodeDataCount].value,
							ACTUATOR_MAP[ncnt*16+cnt].ARG

							) ;
				}

				if( NodeDataCount < 64 ) NodeDataCount++;
				AI[ncnt*16+cnt].state=0x00 ;
			}
//
//			}
		}
		if( NodeDataCount > 0 )
		{
			TTAPacket.MakeActuatorData( PLTYPE_VALUE,NodeDataCount,NodeActData ) ;
			CPacket *pk = TTAPacket.GetPacket() ;
			if( mode == 0x04 )
			{
					printf("Actuator Status node:%d Data -> GCG ..\n",ncnt) ;
			} else {
					printf("StartUp Actuator Info node:%d Data -> GCG ..\n",ncnt) ;
			}

			//HexaPrint(  pk->GetBYTE(),pk->Getsize()  ) ;
			send_msg( (char *)pk->GetBYTE(),pk->Getsize() ) ;

//*

			TTAPtest.Clear() ;
			TTAPtest.packet.Add( (BYTE *)pk->GetBYTE(),pk->Getsize() ) ;

			if( TTAPtest.ParsingPacket() == FTYPE_DATA )
			{

				printf( " DATA packet : %d ,%d \n",TTAPtest.packet.Getsize() , TTAPtest.packet.GetReadIndex () ) ;

				CPacket *rk = TTAPtest.GetPacket() ;
				printf("Actuator  FTYPE_DATA TTAP-TEST -------------------------------------------- \n") ;
				scount = TTAPtest.GetActuatorData( GetActData )  ;
				for( int i = 0 ; i < scount ;i ++ )
				{
						printf( "ID:%d  VALUE:%04X\n\n" , GetActData[i].id , GetActData[i].value ) ;
				}

			}
//*/


		}
	}
}
////////////////////////////////////////////////////////////////////////////////////
//

//
int TransPassiveModeSensorData( void )
{
	SensorValue NodeSensorData[8] ;
	int NodeSensorDataCount=0;
	BYTE cnt=0 ;
	BYTE getINDEX;
	TTA12Packet TTAPacket;

	TTAPacket.Clear() ;
	TTAPacket.SetFrameDevice( FCF_SENSOR ) ;
	TTAPacket.SetFrameType( FTYPE_DATA ) ;
	TTAPacket.SetSecurity( 1 ) ;
	TTAPacket.SetAckConfirm( 1 ) ;
	TTAPacket.SetControlID( HouseControl_ID ) ;

	TTAPacket.SetNodeID( TTAParser.NODE_ID ) ;
	SequenceCount++ ;
	TTAPacket.MakeHeader() ;
	TTAPacket.MakePayload() ;


	if( TTAParser.PLF.length > 0 )
	{
		for( cnt=0; cnt < TTAParser.PLF.length ;cnt++)
		{
			//printf(" id=%d,%d aData[%d].value =  %d \n",TTAParser.sData[i].id,TTAParser.sData[i].type,i,TTAParser.sData[i].value ) ;
			getINDEX = GetSensorConfigIndex( TTAParser.sData[cnt].id ) ;
			if( getINDEX != -1 )
			{
				NodeSensorData[cnt] = SI[getINDEX].data;
				NodeSensorDataCount++;

				SENSOR_MAP[TTAParser.NODE_ID*16+SI[cnt].data.id].SET_INTERVAL= 0x00 ; //
			}
		}
	}

	TTAPacket.MakeSensorData( PLTYPE_VALUE,NodeSensorDataCount,NodeSensorData ) ;

	CPacket *pk = TTAPacket.GetPacket() ;

	printf("Passive Sensor Data -> GCG ..\n") ;
	//HexaPrint(  pk->GetBYTE(),pk->Getsize()  ) ;
	send_msg( (char *)pk->GetBYTE(),pk->Getsize() ) ;

}

////////////////////////////////////////////////////////////////////////////////////
//

//
int TransActiveModeSensorData( char mode )
{
	SensorValue NodeSensorData[16] ;
	int scount=0;
	SensorValue GetSensorData[16] ;
	
	
	int NodeSensorDataCount=0;
	int NODE_NUM=0;BYTE cnt=0 ;
	TTA12Packet TTAPacket;
	CPacket *pk ;
	for(NODE_NUM=0; NODE_NUM < InstalledSensorNodeCount; NODE_NUM++)
	{
		NodeSensorDataCount = 0;
		TTAPacket.Clear() ;
		TTAPacket.SetFrameDevice( FCF_SENSOR ) ;
		TTAPacket.SetFrameType( FTYPE_DATA ) ;
		TTAPacket.SetSecurity( 1 ) ;
		TTAPacket.SetAckConfirm( 1 ) ;
		TTAPacket.SetControlID( HouseControl_ID ) ;

		TTAPacket.SetNodeID( NODE_NUM ) ;

		TTAPacket.MakeHeader() ;
		TTAPacket.MakePayload() ;

		for( cnt = 0 ; cnt < 16;cnt++)
		{
			if( SI[NODE_NUM*16+cnt].state == mode && SI[NODE_NUM*16+cnt].data.id < 255 )
			{

				NodeSensorData[NodeSensorDataCount].id = SI[NODE_NUM*16+cnt].data.id ;
				NodeSensorData[NodeSensorDataCount].type = SI[NODE_NUM*16+cnt].data.type  ;
				NodeSensorData[NodeSensorDataCount].value = SI[NODE_NUM*16+cnt].data.value  ;
				if( SI[NODE_NUM*16+cnt].data.id == 50 )
				{

				printf("NODE: %d Add data %d %d %d \n",NODE_NUM ,
						NodeSensorData[NodeSensorDataCount].id,
						NodeSensorData[NodeSensorDataCount].type,
						NodeSensorData[NodeSensorDataCount].value
					) ;

				}
				NodeSensorDataCount++;
				SI[NODE_NUM*16+cnt].state=0x00 ;
			}
		}

		TTAPacket.MakeSensorData( PLTYPE_VALUE,NodeSensorDataCount,NodeSensorData ) ;


		pk = TTAPacket.GetPacket() ;


		if( NodeSensorDataCount > 0 )
		{
			printf("Active Sensor Data -> GCG ..Sensor Count %d (Paket size %d)\n",NodeSensorDataCount, pk->Getsize()) ;
			SequenceCount++ ;
			//HexaPrint(  pk->GetBYTE(),pk->Getsize()  ) ;
			send_msg( (char *)pk->GetBYTE(),pk->Getsize() ) ;
/*

			TTAPtest.Clear() ;
			TTAPtest.packet.Add( (BYTE *)pk->GetBYTE(),pk->Getsize() ) ;

			if( TTAPtest.ParsingPacket() == FTYPE_DATA )
			{

				CPacket *rk = TTAPtest.GetPacket() ;
				printf("Active Sensor FTYPE_DATA TTAP-TEST -------------------------------------------- \n") ;
				scount = TTAPtest.GetSensorData( GetSensorData )  ;
				for( int i = 0 ; i < scount ;i ++ )
				{
						printf( "ID:%d  VALUE:%d\n" , GetSensorData[i].id , GetSensorData[i].value ) ;
				}
			}
//*/

		}
		NodeSensorDataCount=0;
	}


	TransSensorDataCount=0;
}



void *TCPSERVER_Thread(void * arg)
{
	//int clnt_sock=*((int*)arg);
	while(1)
	{
		if( tcpman.initok==2 ) break ;

		tcpman.Wait_Connect() ;
		usleep(1000*10) ;
	}
	return NULL;
}

void *Timer_handler(void * arg)
{
	//int clnt_sock=*((int*)arg);
	int AIndex=0;
	int SIndex=0;
	COMMPACKET Packet ;
	WORD canID[4]={0x0000,0x0100,0x0300,0x0400} ;
	WORD LiveTime=0;

	while(1)
	{
		pthread_mutex_lock(&cmd_mutex);


			for( SIndex = 0 ; SIndex < MAX_SENSOR_COUNT ; SIndex++)
			{
				if( SI[SIndex].mode == REQCMD_ACTIVE_MODE && SI[SIndex].data.id < 255 )
				{
					if( SENSOR_MAP[	SIndex ].COUNT > 0 )
					{
						SENSOR_MAP[	SIndex ].COUNT-- ;
						if( SENSOR_MAP[	SIndex ].COUNT <= 0 )
						{

								//TransSensorData[TransSensorDataCount].id = SI[SIndex].data.id ;
								//TransSensorData[TransSensorDataCount].type = SI[SIndex].data.type  ;
								//TransSensorData[TransSensorDataCount].value = SI[SIndex].data.value  ;
								SI[SIndex].state=0x04 ;
								printf("Active Mode Sensor Transfer time is up : ID: %d\n",SI[SIndex].data.id ) ;
								if( TransSensorDataCount < 63 ) TransSensorDataCount++ ;

								SENSOR_MAP[	SIndex ].COUNT = SENSOR_MAP[SIndex ].SET_INTERVAL ;

						}

					}
				}
			}
			/*
			for( AIndex = 0 ; AIndex < MAX_ACTUATOR_COUNT ; AIndex++)
			{

				if( AI[AIndex].data.value > 0  )
				{
						AI[AIndex].data.value -= 1 ;
						printf( "Actuator decrease id:%d :%d\n",AIndex,AI[AIndex].data.value ) ;
						if( AI[AIndex].data.value == 0 )
						{
							AI[AIndex].state=0x04 ;
							if( TransActuatorDataCount < 63 ) TransActuatorDataCount++ ;
							printf( "Actuator OFF index:%d id:%d \n", AIndex,AI[AIndex].data.id) ;
							//ACTUATOR_NODE_CONTROL( AI[AIndex].NODE_ID, REQCMD_ACTUATOR_SET, AI[AIndex].data.id,0x00 ) ;
							ACTUATOR_NODE_CONTROL(ACTUATOR_MAP[AIndex].NODE_ID, REQCMD_ACTUATOR_SET, ACTUATOR_MAP[AIndex].CH,0x00 ) ;
						}
				} else {
						//printf( "Actuator OFF id:%d \n",AIndex ) ;
				}
			}
			*/


			for( AIndex = 0 ; AIndex < MAX_ACTUATOR_COUNT ; AIndex++)
			{
				LiveTime=ACTUATOR_MAP[AIndex].COUNT ;
				if( LiveTime > 0 )
				{
						ACTUATOR_MAP[AIndex].COUNT-- ;
						if( ACTUATOR_MAP[AIndex].COUNT <= 0 )
						{
							printf( "Actuator OFF index:%d id:%d \n", AIndex,AI[AIndex].data.id) ;
							ACTUATOR_NODE_CONTROL(ACTUATOR_MAP[AIndex].NODE_ID, REQCMD_ACTUATOR_SET, ACTUATOR_MAP[AIndex].CH,0x00 ) ;
						}

					  printf("[%d] Actuator Status value : %d ID:%d COUNT:%d ACTUATOR_MAP[AIndex].SET_INTERVAL:%d\n",
										AIndex,
										ACTUATOR_MAP[AIndex ].COUNT,
										AI[AIndex].data.id,
										ACTUATOR_MAP[AIndex ].COUNT,
										ACTUATOR_MAP[AIndex].SET_INTERVAL ) ;

// chj start 2016/07/21



					if ( ACTUATOR_MAP[AIndex ].COUNT % ACTUATOR_MAP[AIndex].SET_INTERVAL == 0 )
					{
							AI[AIndex].state=0x04 ;
							if( TransActuatorDataCount < 63 ) TransActuatorDataCount++ ;
					}
// chj end

				} //if( LiveTime > 0 )

			}

			if( TransSensorDataCount > 0 && tcpman.getConnectionCount() )
			{

				TransActiveModeSensorData(0x04) ;
				TransSensorDataCount=0;
			}

			if( TransActuatorDataCount > 0 && tcpman.getConnectionCount() )
			{

				TransOnStatusActuatorData(0x04) ;
				TransActuatorDataCount=0;
			}

		pthread_mutex_unlock(&cmd_mutex);


			//BYTE InstalledSensorNodeCount=3;
			//BYTE InstalledActuatorNodeCount=1;
			//--------------------------------------------------------------------------------------

			//--------------------------------------------------------------------------------------
			// DATA TYPE    -------  NODE TYPE  ---- NODE ID
			//-------------------------------------------------------
			//                     BASEBD   0x00
			// ADC LO  0x0000      ADC      0x10      0x00~0xFF
			// ADC HI  0x0100
			// RELAY   0x0200      REALY    0x20
			// ISO     0x0300      ISO      0x30
			// COUNTER 0x0400      COUNTER  0x00
			// SCAN    0x0700
			unsigned long TimeValue=1000000; //1sec =1000ms =1000000us
			int nodeDelay=0;
			for( int bs = 0 ; bs < InstalledSensorNodeCount ;bs++)
			{

				if( SENSOR_MAP[bs*16].TYPE == 1 ) // AD BOARD
				{
					Packet.wCanID = (SENSOR_MAP[bs*16].CANID&0x00FF)|0x0000 ;
					memset( Packet.nData , 0 , 8 ) ;
					Packet.nData[0]= 0x00;
					Packet.nData[1]= 0xFF;

					USART_SendPacket(COMM_SENSOR[0].PORT, &Packet ) ; usleep(1000*50) ;nodeDelay++;

					Packet.wCanID = (SENSOR_MAP[bs*16].CANID&0x00FF)|0x0100 ;
					memset( Packet.nData , 0 , 8 ) ;
					Packet.nData[0]= 0x00;
					Packet.nData[1]= 0xFF;

					USART_SendPacket(COMM_SENSOR[0].PORT, &Packet ) ;usleep(1000*50) ;nodeDelay++;

					Packet.wCanID = (SENSOR_MAP[bs*16].CANID&0x00FF)|0x0500 ;
					memset( Packet.nData , 0 , 8 ) ;
					Packet.nData[0]= 0x00;
					Packet.nData[1]= 0xFF;

					USART_SendPacket(COMM_SENSOR[0].PORT, &Packet ) ; usleep(1000*50) ;nodeDelay++;

					Packet.wCanID = (SENSOR_MAP[bs*16].CANID&0x00FF)|0x0600 ;
					memset( Packet.nData , 0 , 8 ) ;
					Packet.nData[0]= 0x00;
					Packet.nData[1]= 0xFF;

					USART_SendPacket(COMM_SENSOR[0].PORT, &Packet ) ;usleep(1000*50) ;nodeDelay++;

				}

				if( SENSOR_MAP[bs*16].TYPE == 2 ) // ISO BOARD
				{
					Packet.wCanID = SENSOR_MAP[bs*16].CANID ;
					memset( Packet.nData , 0 , 8 ) ;
					Packet.nData[0]= 0x00;
					Packet.nData[1]= 0xFF;

					USART_SendPacket(COMM_SENSOR[0].PORT, &Packet ) ;usleep(1000*50) ;nodeDelay++;
				}

				if( SENSOR_MAP[bs*16].TYPE == 3 ) // COUNTER BOARD
				{
					Packet.wCanID = SENSOR_MAP[bs*16].CANID ;
					memset( Packet.nData , 0 , 8 ) ;
					Packet.nData[0]= 0x00;
					Packet.nData[1]= 0xFF;
					//printf("Counter Read Request ===========================\n") ;
					USART_SendPacket(COMM_SENSOR[0].PORT, &Packet ) ;usleep(1000*50) ;nodeDelay++;
				}

			}


			if( RS2323ReadCount < 60 ) RS2323ReadCount++ ;
			else RS2323ReadCount=0;

			time_t _time;
			struct tm *ptm;
			_time=time((time_t *)0) ;
			ptm = gmtime( &_time) ;
			printf("Timer == %d:%ds (node delay %d)\n",ptm->tm_min,ptm->tm_sec,nodeDelay ) ;

			if( nodeDelay < 200 ) usleep( TimeValue - (nodeDelay*50000 ) ) ;
	}
}

void *RS232_Thread(void * arg)
{
	int n = 0 ;
	int cnt, i ;
	unsigned char readbuf[255];


	while(1)
	{
		for (i = 0; i < INSTALL_COMM_SENSOR_COUNT; i++) {
			memset(readbuf, 0x00, 255 ) ;
  			n = RS232_PollComport(COMM_SENSOR[i].PORT, readbuf, 254);
  			if(n > 0) {
				printf ("%d[%d] read %d characters\n", i, COMM_SENSOR[i].PORT, n); 
  				pthread_mutex_lock(&mutex_rsbuf[i]);
  				for( cnt = 0 ; cnt < n ; cnt++) {
  					USART_RxQuePush(i, readbuf[cnt] ) ;
  				}
  				pthread_mutex_unlock(&mutex_rsbuf[i]);
  			}
      		}

		usleep(50000) ;
	}

	return NULL ;
}


void InitializeActuatorOffAtStartup(void)
{
		int i=0;
		for( i=0; i < InstalledActuatorNodeCount*16 ;i++)
		{

				printf(">> ACTUATOR INIT OFF NODE_ID=%d,ID=%d,CH=%d,INIT TIME=%d\n",
					ACTUATOR_MAP[i].NODE_ID,
					ACTUATOR_MAP[i].ID,
					ACTUATOR_MAP[i].CH,
					ACTUATOR_MAP[i].INIT_TIME ) ;

				AI[i].data.id = ACTUATOR_MAP[i].ID ;
				//AI[i].data.value = ACTUATOR_MAP[i].INIT_TIME ;
				//ACTUATOR_MAP[	i ].COUNT= ActuatorInterval ;
				
				ACTUATOR_NODE_CONTROL( ACTUATOR_MAP[i].NODE_ID , REQCMD_ACTUATOR_SET,ACTUATOR_MAP[i].CH, 0 ) ;
				
				
/*
			if( ACTUATOR_MAP[i].INIT_TIME > 0 )
			{
				printf(" ACTUATOR INIT ON NODE_ID=%d,ID=%d,CH=%d,INIT TIME=%d\n",
					ACTUATOR_MAP[i].NODE_ID,
					ACTUATOR_MAP[i].ID,
					ACTUATOR_MAP[i].CH,
					ACTUATOR_MAP[i].INIT_TIME ) ;

				AI[i].data.id = ACTUATOR_MAP[i].ID ;
				AI[i].data.value = ACTUATOR_MAP[i].INIT_TIME ;
				ACTUATOR_MAP[	i ].COUNT= ActuatorInterval ;
				ACTUATOR_NODE_CONTROL( ACTUATOR_MAP[i].NODE_ID , REQCMD_ACTUATOR_SET,ACTUATOR_MAP[i].CH, 1 ) ;
			} else {
				printf(" ACTUATOR INIT OFF NODE_ID=%d,ID=%d,CH=%d,INIT TIME=%d\n",
					ACTUATOR_MAP[i].NODE_ID,
					ACTUATOR_MAP[i].ID,
					ACTUATOR_MAP[i].CH,
					ACTUATOR_MAP[i].INIT_TIME ) ;

				AI[i].data.id = ACTUATOR_MAP[i].ID ;
				//AI[i].data.value = ACTUATOR_MAP[i].INIT_TIME ;
				//ACTUATOR_MAP[	i ].COUNT= ActuatorInterval ;
				ACTUATOR_NODE_CONTROL( ACTUATOR_MAP[i].NODE_ID , REQCMD_ACTUATOR_SET,ACTUATOR_MAP[i].CH, 0 ) ;
			}
*/
		}
}

void HardwareControlForTTA12Packet(void)
{


	// --------------------------------------------------------------

	// --------------------------------------------------------------
	int i=0;
	int Size =0;
	int nodeCH=0 ;
	BYTE aARG ;
	WORD aVALUE;
	printf("TTAParser.RequestCommand %02x\n",TTAParser.RequestCommand ) ;

	switch( TTAParser.RequestCommand )
	{
		case REQCMD_INIT :


			ACTUATOR_NODE_CONTROL( TTAParser.NODE_ID, REQCMD_INIT,0,0x00 ) ;
			for( Size = 0 ; Size < MAX_SENSOR_COUNT ; Size++)
			{
				SENSOR_MAP[Size].NODE_ID = 0 ;
				SENSOR_MAP[Size].CH = 0 ;
				SENSOR_MAP[Size].COUNT=0;
			}

			break ;

		case REQCMD_INIT_NODE :


			break;

		case REQCMD_INIT_ACT :


			break ;

		case REQCMD_NODE_INFO :


			break ;

		case REQCMD_ACTUATOR_SET :


				if( TTAParser.PLF.length > 0 )
				{
					printf("HardwareControlForTTA12Packet -----------------------------------------------------------------\n") ;
					for( i=0; i < TTAParser.PLF.length ;i++)
					{
						//AI[NODE_ID*8+i].data=aData[i] ;

						printf(" ACTUATOR DATA id=%d,%d aData[%d].value = %04X \n",AI[i].data.id,AI[i].data.type,i,AI[i].data.value ) ;

						aARG = (TTAParser.aData[i].value&0xF000)>>12 ;
						aVALUE = TTAParser.aData[i].value&0x0FFF ;

						nodeCH = GetActuatorConfigIndex (TTAParser.aData[i].id ,aARG) ;
						if( nodeCH > -1 )
						{
// chj 2016/07/21


							if( aVALUE > 0 )
							{
								ACTUATOR_MAP[nodeCH].SET_INTERVAL = ActuatorInterval ;
								ACTUATOR_MAP[nodeCH].COUNT= aVALUE ;
								ACTUATOR_NODE_CONTROL( ACTUATOR_MAP[nodeCH].NODE_ID , REQCMD_ACTUATOR_SET,ACTUATOR_MAP[nodeCH].CH, 1 ) ;
								//printf(" id=%d,%d aData[%d].value =  %X,count %d \n",TTAParser.aData[i].id,TTAParser.aData[i].type,i,TTAParser.aData[i].value,ACTUATOR_MAP[	nodeCH ].COUNT ) ;
								printf("ON [id=%d,ARG=%X] findINDEX=%d,count %d \n",TTAParser.aData[i].id,aARG,nodeCH,ACTUATOR_MAP[nodeCH ].COUNT ) ;
//								printf("*************************************ON [id=%d,ARG=%X] findINDEX=%d,count %d \n",TTAParser.aData[i].id,aARG,nodeCH,ACTUATOR_MAP[nodeCH ].COUNT ) ;
							} else {

								ACTUATOR_MAP[nodeCH].SET_INTERVAL = ActuatorInterval ;
								ACTUATOR_MAP[nodeCH].COUNT= 1 ;

								ACTUATOR_NODE_CONTROL( ACTUATOR_MAP[nodeCH].NODE_ID , REQCMD_ACTUATOR_SET,ACTUATOR_MAP[nodeCH].CH, 0 ) ;
								printf("OFF [id=%d,ARG=%X] findINDEX=%d,count %d \n",TTAParser.aData[i].id,aARG,nodeCH,ACTUATOR_MAP[nodeCH ].COUNT ) ;
//								printf("=====================================OFF [id=%d,ARG=%X] findINDEX=%d,count %d \n",TTAParser.aData[i].id,aARG,nodeCH,ACTUATOR_MAP[nodeCH ].COUNT ) ;

								//AI[nodeCH].state=0x04 ;
								//AI[nodeCH].data.value &= 0xF000 ;
								//if( TransActuatorDataCount < 63 ) TransActuatorDataCount++ ;
								//TransOnStatusActuatorData(0x04) ;
							}
// chj end


						} else {
								printf("NOT FIND %d [id=%d,ARG=%X] findINDEX=%d,count %d \n",TTAParser.PLF.length,TTAParser.aData[i].id,aARG,nodeCH,ACTUATOR_MAP[	nodeCH ].COUNT ) ;
						}
					}
				}


			break ;
		case REQCMD_PASSIVE_MODE :


				TransPassiveModeSensorData();


			break ;

		case REQCMD_ACTIVE_MODE :

				if( TTAParser.PLF.length > 0 )
				{
					for( i=0; i < TTAParser.PLF.length ;i++)
					{

						//printf(" id=%d,%d aData[%d].value =  %d \n",TTAParser.sData[i].id,TTAParser.sData[i].type,i,TTAParser.sData[i].value ) ;

						nodeCH = GetSensorConfigIndex( TTAParser.sData[i].id );
						SENSOR_MAP[nodeCH].NODE_ID = TTAParser.NODE_ID ;

						if( 	(SI[i].time&0xC0) == PERSEC )
						{
							SENSOR_MAP[nodeCH].COUNT = SI[nodeCH].time&0x3F ;
							SENSOR_MAP[nodeCH].SET_INTERVAL= SI[nodeCH].time&0x3F ;

						}
						if( 	(SI[i].time&0xC0) == PERMIN )
						{
							SENSOR_MAP[nodeCH].COUNT = (SI[nodeCH].time&0x3F)*TIME_MIN ;
							SENSOR_MAP[nodeCH].SET_INTERVAL= (SI[nodeCH].time&0x3F)*TIME_MIN ;

						}
						if( 	(SI[i].time&0xC0) == PERHOUR )
						{
							SENSOR_MAP[nodeCH].COUNT = (SI[nodeCH].time&0x3F)*TIME_HOUR ;
							SENSOR_MAP[nodeCH].SET_INTERVAL= (SI[nodeCH].time&0x3F)*TIME_HOUR ;

						}
            if( 	(SI[i].time&0xC0) == PERDAY )
						{
							SENSOR_MAP[nodeCH].COUNT = (SI[nodeCH].time&0x3F)*TIME_DAY ;
							SENSOR_MAP[nodeCH].SET_INTERVAL= (SI[nodeCH].time&0x3F)*TIME_DAY ;

						}

						//printf(" id=%d SI[%d].mode = %d [%02X:%d]\n",SI[i].data.id,i,SI[i].mode,SI[i].time&0xC0,
						//		SENSOR_MAP[TTAParser.NODE_ID*8+SI[i].data.id].COUNT) ;
						/*

							SENSOR_MAP[Size].NODE_ID = 0 ;
							SENSOR_MAP[Size].SENSOR_ID = 0 ;
							SENSOR_MAP[Size].COUNT=0;
							SI[i].NODE_ID = NODE_ID ;
							SI[i].data.id = sData[i].id ;
							SI[i].mode = RequestCommand ; //sData[i].type ;
							SI[i].time = sData[i].value | sData[i].type  ;
						*/
					}
				}

			break ;
		case REQCMD_EVENT_MODE :



			break ;
	}

}

BYTE SearchIndexSensorNode( WORD CANID )
{
	BYTE b=0;
	for( b= 0 ; b < InstalledSensorNodeCount ; b++ )
	{
			if( (SENSOR_MAP[b*16].CANID&0x00ff) == (CANID&0x00ff) ) return b ;
	}
  return InstalledSensorNodeCount-1 ;
}

bool UARTSensorPacketStreaming(int idx)
{
	u8					nch, i;
	u16					nchksum;
	//u8					*buffer = (u8*)&USART2Rxbuf;

  //printf("SensorPacketStreaming  %x \n", USART2RxDataQue.nBuffer[USART2RxDataQue.nPushIndex-1] ) ;
	while( UARTFifoPop(USARTRxDataQue + idx, &nch) )
	{
		// packet streaming
		//for( i=0; i<(COMM_SENSOR_SIZE-1); i++ ) { buffer[i] = buffer[i+1]; }
		//buffer[COMM_SENSOR_SIZE-1] = nch;
		//if( COMM_SENSOR[0].LENGTH

		if( nch == 0x0A || nch == 0x0D ) newlineflag1++ ;

		if( newlineflag1 > 0 )
		{
			if( nch == 0x0A || nch == 0x0D ) break;

			USARTRxbuf[idx][ comm_data_count1++]=nch ;
			if( comm_data_count1 >= COMM_SENSOR[idx].LEN )
			{
				newlineflag1=0;
				comm_data_count1=0;

				//COMM_SENSOR_VALUE[0] = atoi( (char *)USART2Rxbuf ) ;
				printf( "COMM sensor data [%s] \n", USARTRxbuf[idx]);
				if (REG_PARSE( idx, (char *)(USARTRxbuf[idx]) ) < 0) {
					printf ("COMM sensor data could not parsed.\n");
				} else {
					printf( "COMM sensor data %s parsed\n", USARTRxbuf[idx]);
				}
				return true;

			}
		}
  }

  return false;
}

void CommSensorValueReadToNode(char cnode)
{


}

// DATA TYPE    -------  NODE TYPE  ---- NODE ID
//-------------------------------------------------------
//                     BASEBD   0x00
// ADC LO  0x0000      ADC      0x10      0x00~0xFF
// ADC HI  0x0100
// RELAY   0x0200      REALY    0x20
// ISO     0x0300      ISO      0x30
// COUNTER 0x0400      COUNTER  0x40
// SCAN    0x0700

void SensorValueReadToNode (void)
{
		//printf("RS232 RECEIVED %x %x \n", USART1StreamingBuffer.nHeader,USART1StreamingBuffer.wCanID );	// 0xaa55
		BYTE NodeID = 0 ;
		BYTE DataTYPE = 0 ;
		BYTE NodeTYPE = 0 ;

		NodeID = SearchIndexSensorNode(USARTStreamingBuffer[0].wCanID) ;
		//NodeID = USART1StreamingBuffer.wCanID&0x000F;
		NodeTYPE = USARTStreamingBuffer[0].wCanID&0x00F0;
		DataTYPE = (USARTStreamingBuffer[0].wCanID&0xFF00)>>8;

		if( NodeTYPE == 0x00 )
		{
			if( DataTYPE ==0x04 )
			{
				//NodeID = 2 ;
				printf( "BASE COUNTER  [%04x : %d] IN CH1 %d,CH2 %d\n",
											USARTStreamingBuffer[0].wCanID,
						SearchIndexSensorNode(USARTStreamingBuffer[0].wCanID),
					USARTStreamingBuffer[0].dwData[0],USARTStreamingBuffer[0].dwData[1] ) ;
				SI[NodeID*16+0].data.value=USARTStreamingBuffer[0].dwData[0];
				SI[NodeID*16+1].data.value=USARTStreamingBuffer[0].dwData[1];
			}

		} else {  // ADC,ISO,RELAY MODULE board

			if( NodeTYPE ==0x10 )   // ADC
			{
				if( DataTYPE ==0x00 )
				{

					SI[NodeID*16+0].data.value = USARTStreamingBuffer[0].wData[0] ;
					SI[NodeID*16+1].data.value = USARTStreamingBuffer[0].wData[1] ;
					SI[NodeID*16+2].data.value = USARTStreamingBuffer[0].wData[2] ;
					SI[NodeID*16+3].data.value = USARTStreamingBuffer[0].wData[3] ;

					printf( "ADC[%04x : %d] 1,2,3,4 %4d %4d %4d %4d\n",
						USARTStreamingBuffer[0].wCanID,
						SearchIndexSensorNode(USARTStreamingBuffer[0].wCanID),
						SI[NodeID*16+0].data.value ,
						SI[NodeID*16+1].data.value ,
						SI[NodeID*16+2].data.value ,
						SI[NodeID*16+3].data.value  ) ;

				}
				if( DataTYPE ==0x01 )
				{

					SI[NodeID*16+4].data.value = USARTStreamingBuffer[0].wData[0] ;
					SI[NodeID*16+5].data.value = USARTStreamingBuffer[0].wData[1] ;
					SI[NodeID*16+6].data.value = USARTStreamingBuffer[0].wData[2] ;
					SI[NodeID*16+7].data.value = USARTStreamingBuffer[0].wData[3] ;

					printf( "ADC[%04x : %d] 5,6,7,8 %4d %4d %4d %4d\n",
						USARTStreamingBuffer[0].wCanID,
						SearchIndexSensorNode(USARTStreamingBuffer[0].wCanID),
						SI[NodeID*16+4].data.value ,
						SI[NodeID*16+5].data.value ,
						SI[NodeID*16+6].data.value ,
						SI[NodeID*16+7].data.value  ) ;

				}
				if( DataTYPE ==0x05 )
				{
					//NodeID = 0 ;
					SI[NodeID*16+8].data.value = USARTStreamingBuffer[0].wData[0] ;
					SI[NodeID*16+9].data.value = USARTStreamingBuffer[0].wData[1] ;
					SI[NodeID*16+10].data.value = USARTStreamingBuffer[0].wData[2] ;
					SI[NodeID*16+11].data.value = USARTStreamingBuffer[0].wData[3] ;

					printf( "BASE ADC[%d] 9,10,11,12 %4d %4d %4d %4d\n",
						NodeID,
					  SI[NodeID*16+8].data.value ,
						SI[NodeID*16+9].data.value ,
						SI[NodeID*16+10].data.value ,
						SI[NodeID*16+11].data.value  ) ;

				}
				if( DataTYPE ==0x06 )
				{
					//NodeID = 0 ;
					SI[NodeID*16+12].data.value = USARTStreamingBuffer[0].wData[0] ;
					SI[NodeID*16+13].data.value = USARTStreamingBuffer[0].wData[1] ;
					SI[NodeID*16+14].data.value = USARTStreamingBuffer[0].wData[2] ;
					SI[NodeID*16+15].data.value = USARTStreamingBuffer[0].wData[3] ;

					printf( "BASE ADC[%d] 13,14,15,16 %4d %4d %4d %4d\n",
						NodeID,
						SI[NodeID*16+12].data.value ,
						SI[NodeID*16+13].data.value ,
						SI[NodeID*16+14].data.value ,
						SI[NodeID*16+15].data.value  ) ;

				}
			}


			if( NodeTYPE ==0x30 && DataTYPE ==0x03 )
			{
				WORD bitVAL=0x01;
				printf( "ISO [%04x : %d] IN %02X\n",
						USARTStreamingBuffer[0].wCanID,
						SearchIndexSensorNode(USARTStreamingBuffer[0].wCanID),
					USARTStreamingBuffer[0].nData[0] ) ;

				for( char i = 0 ; i < 16 ;i ++)
				{
					if( (USARTStreamingBuffer[0].wData[0]&bitVAL)==bitVAL )
						SI[NodeID*16+i].data.value=0xFFFF;
					else
						SI[NodeID*16+i].data.value=0x0000;
					bitVAL<<=1;

					printf( "ISO IN CH %d:%02X\n",i, SI[NodeID*16+i].data.value ) ;
				}

			}

		}

		if( SensorReadCount < 20 ) SensorReadCount++ ;
			else SensorReadCount=0 ;

}

void
daemonize ()
{
    int x;
    pid_t pid;

    /* Fork off the parent process */
    pid = fork();
    if (pid < 0)
        exit(EXIT_FAILURE);
    if (pid > 0)
        exit(EXIT_SUCCESS);

    /* On success: The child process becomes session leader */
    if (setsid() < 0)
        exit(EXIT_FAILURE);

    signal(SIGCHLD, SIG_IGN);
    signal(SIGHUP, SIG_IGN);

    /* Fork off for the second time*/
    pid = fork();
    if (pid < 0)
        exit(EXIT_FAILURE);
    if (pid > 0)
        exit(EXIT_SUCCESS);

    umask(0);
    //chdir(GOS_WORKING_DIRECTORY);

    /* Close all open file descriptors */
    for (x = sysconf(_SC_OPEN_MAX); x > 0; x--) {
    //    close (x);
    }
}


void sig_handler(int signo)
{
	tcpman.CloseServer() ;
	//destroy_timer();
	//////////////////////////////////////////////////////////////////////////
	//

	//
	InitializeActuatorOffAtStartup() ;

	printf("Program Exit \n") ;
	exit(signo) ;
}



int main(int argc, char **argv)
{
	bool rtn;
	int tmKey ;
	int idx;
    int c ;

    signal(SIGINT, sig_handler);
    signal(SIGTERM, sig_handler);

    while ((c = getopt (argc, argv, "c:dv:")) != -1) {
        switch (c) {
            case 'd':
                daemonize ();
                break;
            default:
                break;
        }
    }


	//////////////////////////////////////////////////////////////////////////
	//

	//
	PacketVariable_init() ;

	ReadDevice_Config() ;printf("Config device read OK!!\n") ;
	ReadServer_Config() ;printf("Config server read OK!!\n") ;

	

	//////////////////////////////////////////////////////////////////////////
	//

	//
	pthread_mutex_init(&mutex_key, NULL);
	//pthread_mutex_init(&mutex_rsbuf[0], NULL);
	pthread_mutex_init(&mutex_process, NULL);


	int isOK = 0;
	int retry_count=0 ;

	//////////////////////////////////////////////////////////////////////////
	//

	//

	//printf("Serial port #1 open  for ARM\n") ;
	//if( RS232_OpenComport(CONTROL_PORT, "/dev/ttyS1", PORT_SPEED) )
	//{
//		printf("Can not open serial port #1 for ARM\n") ;
//	}

	for (idx = 0; idx < INSTALL_COMM_SENSOR_COUNT; idx++) {
    		
		pthread_mutex_init(&mutex_rsbuf[idx], NULL);
		printf("Serial port #[%d] open for COMM %s %d\n", idx+1, COMM_SENSOR[idx].TTY, COMM_SENSOR[idx].SPEED) ;
		if( RS232_OpenComport(COMM_SENSOR[idx].PORT, COMM_SENSOR[idx].TTY, COMM_SENSOR[idx].SPEED) )
		{
			printf("Can not open serial port #[%d] for COMM SENSOR (RS485)\n", idx+1) ;
			COMM_SENSOR[idx].SPEED=0;
		} 
		
		memset(USARTRxbuf + idx, 0, 10) ;
	}

  	//RS485Ctrl_flow(0) ;  // receive mode

	pthread_create(&t_idRS232, NULL, RS232_Thread, NULL) ;
	pthread_detach(t_idRS232) ;


	//////////////////////////////////////////////////////////////////////////
	//

	//
	pthread_create(&t_idTimer, NULL, Timer_handler, NULL) ;
	pthread_detach(t_idTimer) ;

	//////////////////////////////////////////////////////////////////////////
	//

	//

	while( retry_count < 5 )
	{
		GCG_connected = isOK = tcpman.ClientConnect( GCG_IP,GCG_PORT ) ;

		if( isOK != -1 ) break ;
		usleep(1000*1000) ;
		retry_count++ ;
	}
	printf("======================================\n") ;
	printf("TTA1,2 daemon build 3.2001  2016-12-07  \n" ) ;
	printf("Raspberry support ...    \n" ) ;
	printf("config.ini applied    \n" ) ;
	printf("Initialize Actuator at Power ON   \n" ) ;
	printf("======================================\n") ;

	//BuzzerBeep(); BuzzerBeep();
	sleep(1) ;

	//////////////////////////////////////////////////////////////////////////
	//

	//
	InitializeActuatorOffAtStartup() ;


	//////////////////////////////////////////////////////////////////////////
	//

	//
	printf("Sensor Status Reading ................\n") ;

	while( RS2323ReadCount < 30 )
	{
		if( UARTPacketStreaming(0) )
		{
				SensorValueReadToNode() ;
		}
		if( SensorReadCount > 5 ) break ;
	}


	//////////////////////////////////////////////////////////////////////////
	//

	//

	TransActiveModeSensorData(0x00) ;


	//////////////////////////////////////////////////////////////////////////
	//

	//

	BYTE pTYPE=0xFF ;
	printf("Start Main Loop ................\n") ;
	while(1)
	{


		if( UARTPacketStreaming(0) ) {
			SensorValueReadToNode() ;
		}

    	for (idx = 1; idx <INSTALL_COMM_SENSOR_COUNT; idx++) {
	        if( COMM_SENSOR[idx].SPEED > 0 )
			{
				printf("comm sensor packet [%d] ................\n", idx) ;
  				UARTSensorPacketStreaming(idx);
			}
		}


		// GCG connection üũ
		if( tcpman.getConnectionCount() == 0 )
		{
			printf("GCG connection losted.... try reconnection \n") ;
			GCG_connected = isOK = tcpman.ClientConnect( GCG_IP,GCG_PORT ) ;
			usleep(1000*1000) ;
			if( isOK != -1 ) continue ;
		}


		if( TCP_CMD_HEAD < TCP_CMD_TAIL )
		{

			printf("Reveived GCG Packet...................................................\n") ;
			//HexaPrint(  TCP_CMD_BUF[TCP_CMD_HEAD].buf,TCP_CMD_BUF[TCP_CMD_HEAD].size ) ;

			pthread_mutex_lock(&cmd_mutex);
			if( TCP_CMD_BUF[TCP_CMD_HEAD].size > 0 )
			{
				//pthread_mutex_lock(&mutex_process);
				idx = 0;
				do {
					//printf("TCP BUFF head %d: tail %d\n",TCP_CMD_HEAD,TCP_CMD_TAIL ) ;
					TTAParser.Clear() ;
					TTAParser.packet.Add( TCP_CMD_BUF[TCP_CMD_HEAD].buf + idx, TCP_CMD_BUF[TCP_CMD_HEAD].size - idx);


					pTYPE = TTAParser.ParsingPacket() ;

					switch (pTYPE)
					{
						case  FTYPE_REQUEST:
									printf("FTYPE_REQUEST\n" ) ;
									HardwareControlForTTA12Packet() ;
									break;

						case  FTYPE_RESPONSE:
									printf("FTYPE_RESPONSE \n") ;
									break;

						case  FTYPE_CONFIRM :
									printf("FTYPE_CONFIRM\n") ;
									break;

						case  FTYPE_NOTIFY:
									printf("FTYPE_NOTIFY\n") ;
									break;

						case  FTYPE_DATA:
								  printf("FTYPE_DATA\n") ;
									break;

					}

					if( pTYPE != FTYPE_CONFIRM &&  pTYPE != 0xFF  )
					{



						//CPacket *rk = TTAParser.GetReturnPacket() ;
						//if( rk->Getsize() > 8 )	send_msg( (char *)rk->GetBYTE(),rk->Getsize() ) ;

					}

					idx += TTAParser.packet.GetReadIndex () + 1;
					printf("CMD BUFFER GetReadIndex : %d ................................................\n",TTAParser.packet.GetReadIndex () ) ;
				} while (TCP_CMD_BUF[TCP_CMD_HEAD].size > idx);
				//pthread_mutex_unlock(&mutex_process);

			}


			TCP_CMD_HEAD++ ;
			if(  TCP_CMD_HEAD == TCP_CMD_TAIL ) TCP_CMD_HEAD=TCP_CMD_TAIL=0 ;
			pthread_mutex_unlock(&cmd_mutex);
		} // if( TCP_CMD_HEAD < TCP_CMD_TAIL )

		if( SequenceCount > 65530 ) SequenceCount=0;
		usleep(20000) ;
	} // while

	tcpman.CloseServer() ;
	//destroy_timer();
	//////////////////////////////////////////////////////////////////////////
	//

	//
	InitializeActuatorOffAtStartup() ;

	printf("Program Exit \n") ;

}
