ezfarm-farmcloud/cflora/(commit log)

2016-11-17 migration from naver open project
    [CECS_BASEBOARD_NEW.DSN, CECS_BASEBOARD_NEW.opj, CECS_BASEBOARD_NEW_Check.pcb, CECS_MODULE_ATOD.DSN, CECS_MODULE_AtoD.opj, CECS_MODULE_ISOINPUT.DSN, CECS_MODULE_IsoInput.opj, CECS_MODULE_IsoInput_pl.xlsx]
2016-11-29 컴파일이 용이하도록 수정
2016-11-29 SQLITE 관련 파일 제거
2016-11-29 SQLITE 관련 내용 제거
2016-11-29 static 라이브러리를 사용하도록 수정
2016-11-29 rt 라이브러리 추가하도록 수정
2016-11-30 누적일사를 위한 가상센서 추가
2016-11-30 서브모듈관련 명령은 루트디렉토리에서 수행해야함
2016-11-30 CF_DB_OK 삭제
2016-11-30 초기화 버그 수정
2016-12-05 ctrlarg 처리부 수정
2016-12-07 노드 설정 파일 업데이트
2016-12-07 노드 캔통신을 위한 포트 설정이 가능하도록 변경
2016-12-13 16포트 지원되는 노드를 위한 변경
2016-12-15 잘못된 명령에 대한 무시 처리
2016-12-15 간단한 표현 변경
2017-01-04 gcg가 메세지 처리하다 죽는 버그 수정 및 COMM 센서관련 초기화 문제 수정
    [TTA12daemon.cpp]
2017-01-16 2번째 버전 하드웨어 정보 추가
    [CECS_BASEBOARD_NEW.DSN, CECS_BASEBOARD_NEW.opj, CECS_BASEBOARD_NEW_Check.pcb, CECS_MODULE_ATOD.DSN, CECS_MODULE_ATOD_1020.DSN, CECS_MODULE_AtoD.opj, CECS_MODULE_ISOINPUT.DSN, CECS_MODULE_ISOINPUT_1020.DSN]
