ezfarm-farmcloud/cflora/(notices)

Notices in the files:
software/node/src/rs232.c:
This program is free software; you can redistribute it and/or modify
it under the terms of the GNU General Public License as published by
the Free Software Foundation version 2 of the License.
